sonwit/Bilderamme/plates/fugler/loxia-curvirostra.png

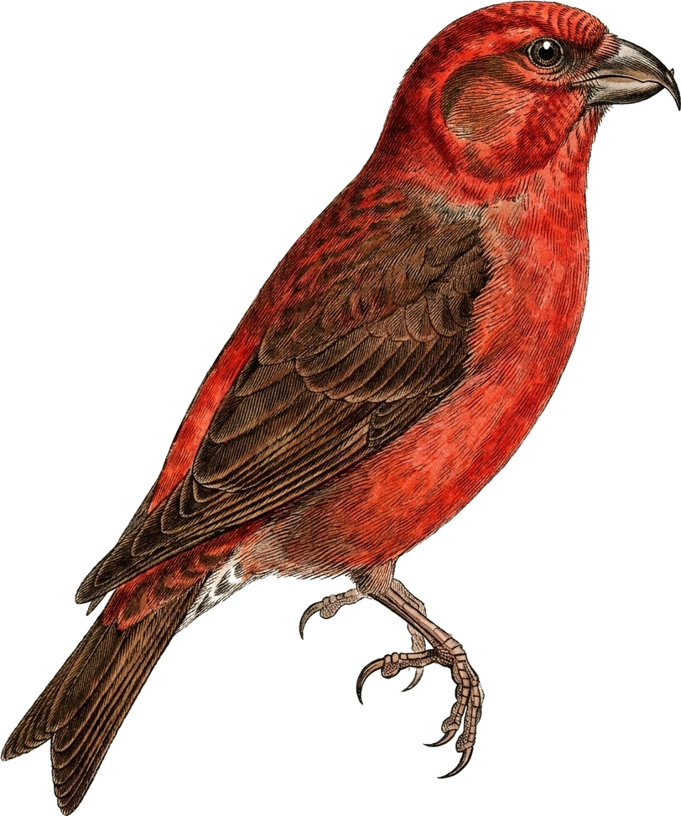
plates/fugler/loxia-curvirostra.png
