sonwit/Bilderamme/plates/fugler/phoenicurus-phoenicurus-flyvende.png

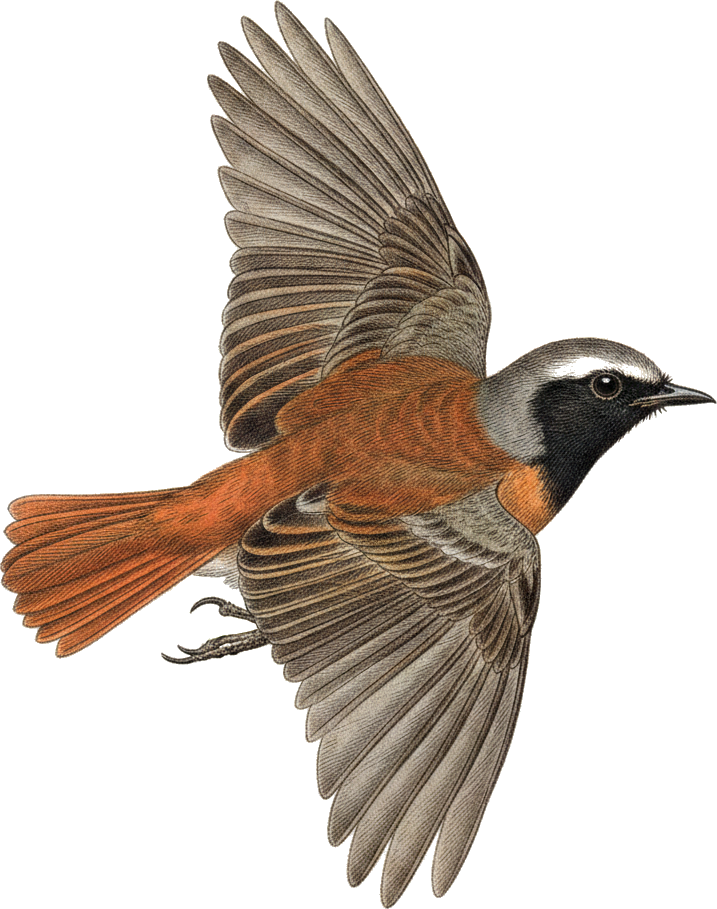
plates/fugler/phoenicurus-phoenicurus-flyvende.png
