sonwit/Bilderamme/docs/README.md

# docs/ — guider og notater

Guidene beskriver hvordan ting settes opp. Notatene er skrevet underveis og
beskriver det som var sant da; de er beholdt som historikk.

| Fil | Hva | Status |
|---|---|---|
| `Fase 1 — Kom i gang med ePaper-skjermen.md` | Første kontakt med panelet: board-innstillinger, testbilde, to nettverk under samme navn. | Guide |
| `Egen firmware — oppsett.md` | Hvordan innedelens firmware ble til, med den fungerende driveren. | Guide |
| `Flashing med arduino-cli.md` | Førstegangsoppsett av arduino-cli og feilsøking av flashing. | Guide |
| `Utedel v2 — ESP32-S3 XIAO.md` | Alt om lytteren: montering, strøm, fjernkonfig, feilsøking. | Guide |
| `Webapp — galleri og generering.md` | Webappen på port 8090: galleri, send på nytt, generering. | Guide |
| `Dagsoversikten — én dag om gangen.md` | `/dag`: hva siden viser og hvorfor den finnes. | Guide |
| `On-demand — Siri-kommando.md` | «Hei Siri, tegn X på fuglerammen»: snarveien og endepunktet. | Guide |
| `Prompt-guide — bilder til ePaper-rammen.md` | Prompt-maler som gir gode resultater på seks farger. | Guide |
| `Utedel — status og neste steg.md` | Utedel v1 på Raspberry Pi: hva som virket, hva som ikke gjorde det. | Historikk |
| `HANDOFF — bygg BirdNET-automatikk.md` | Overleveringen da BirdNET-automatikken skulle bygges, sommeren 2026. | Historikk |
| `Fugleramme — Ambient Art Display.md` | Det opprinnelige konseptet, før fuglesiden. | Historikk |

Hver mappe i repoet har sin egen README om det som ligger der; start i
[../README.md](../README.md).
