sonwit/Bilderamme/nettside/bilder/boks-inni.jpg

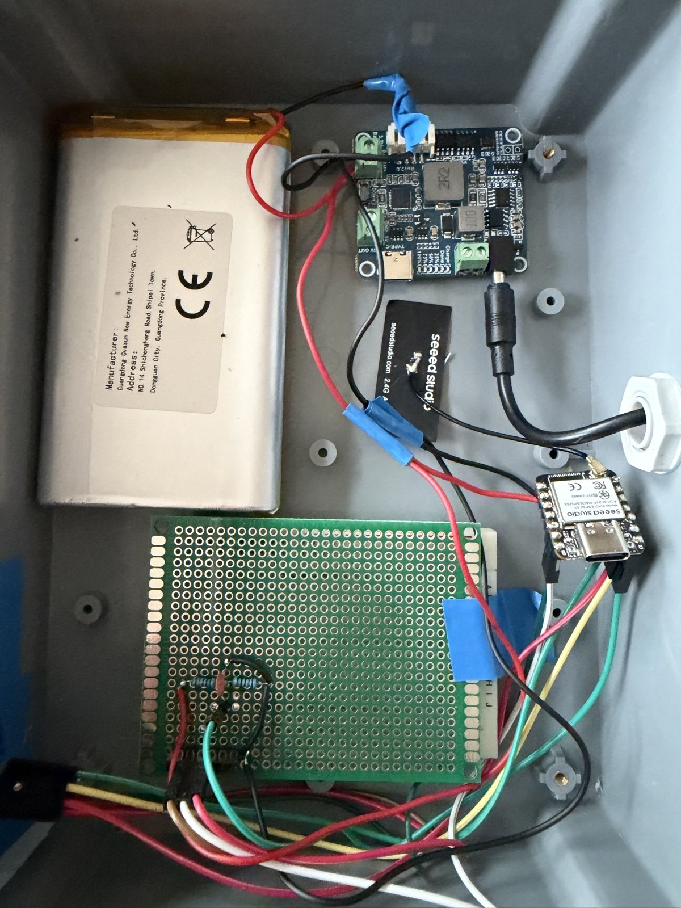
nettside/bilder/boks-inni.jpg
