sonwit/Bilderamme/nettside/bilder/boks-ute.jpg

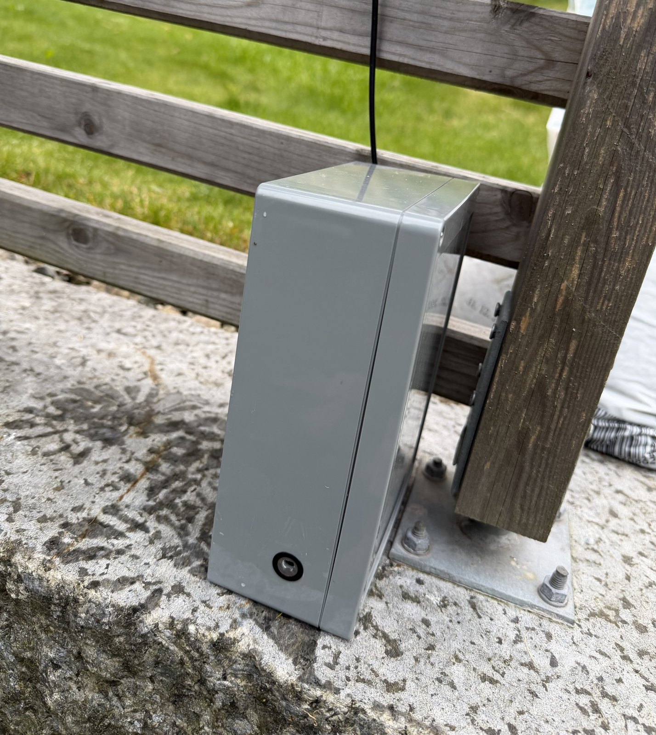
nettside/bilder/boks-ute.jpg
