sonwit/Bilderamme/nettside/bilder/ramme-naer.jpg

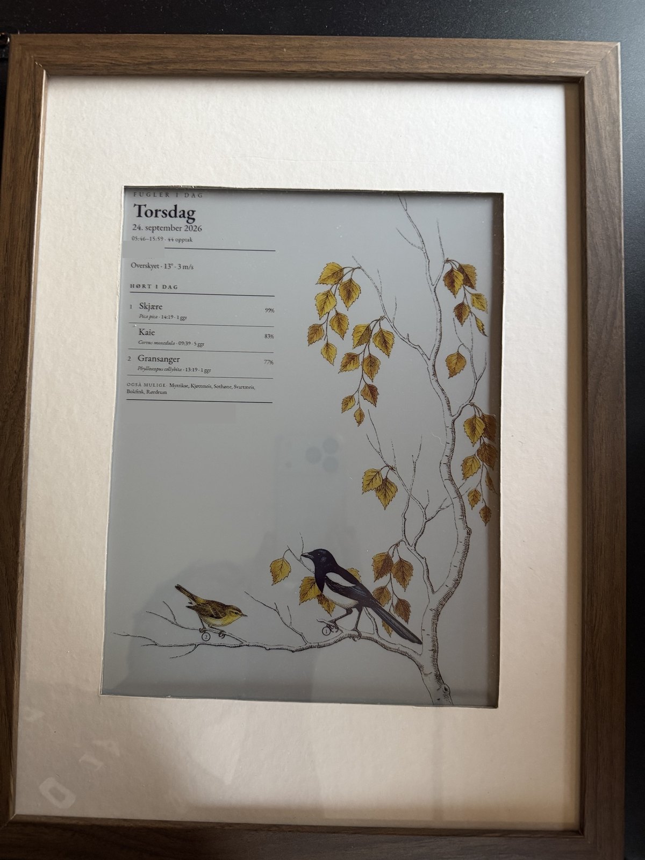
nettside/bilder/ramme-naer.jpg
