sonwit/Bilderamme/nettside/bilder/ramme.jpg

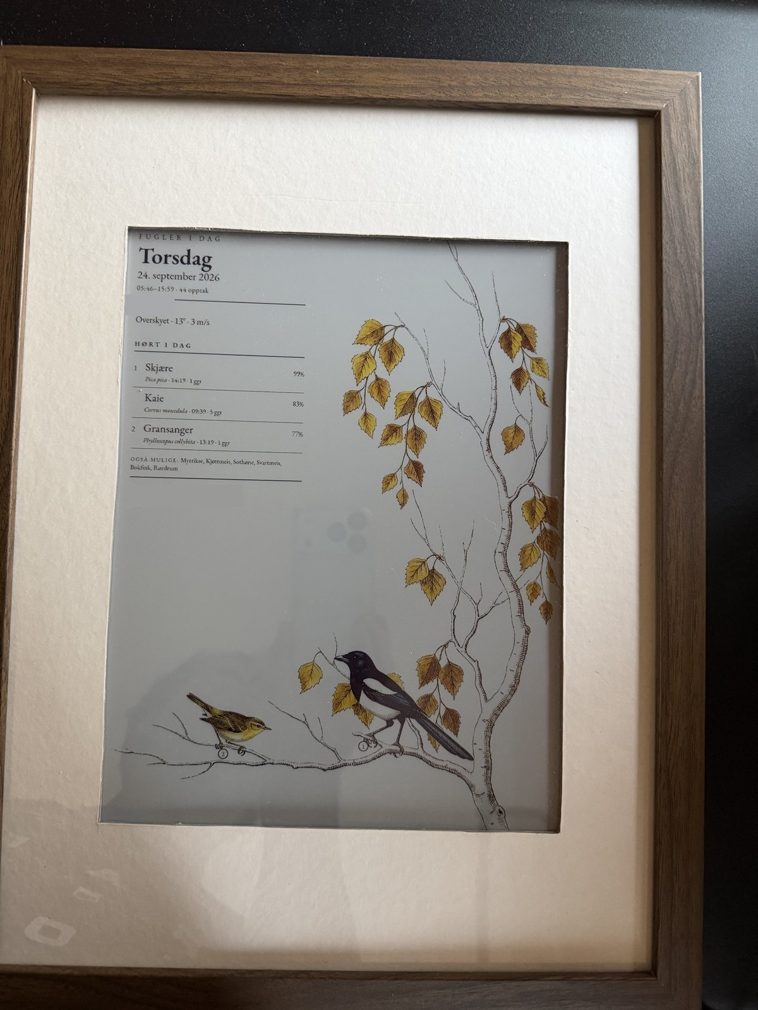
nettside/bilder/ramme.jpg
