sonwit/Bilderamme/nettside/dager/2026-09-18.png

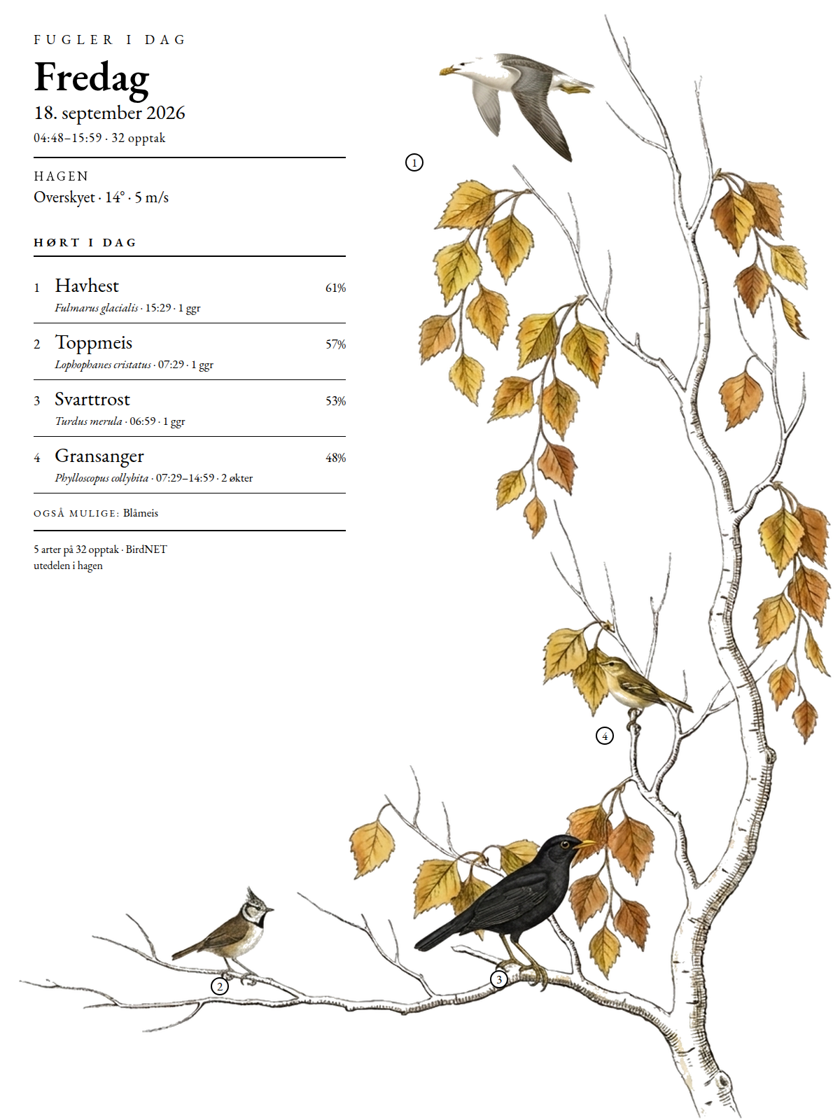
nettside/dager/2026-09-18.png
