sonwit/Bilderamme/nettside/dager/2026-09-19.png

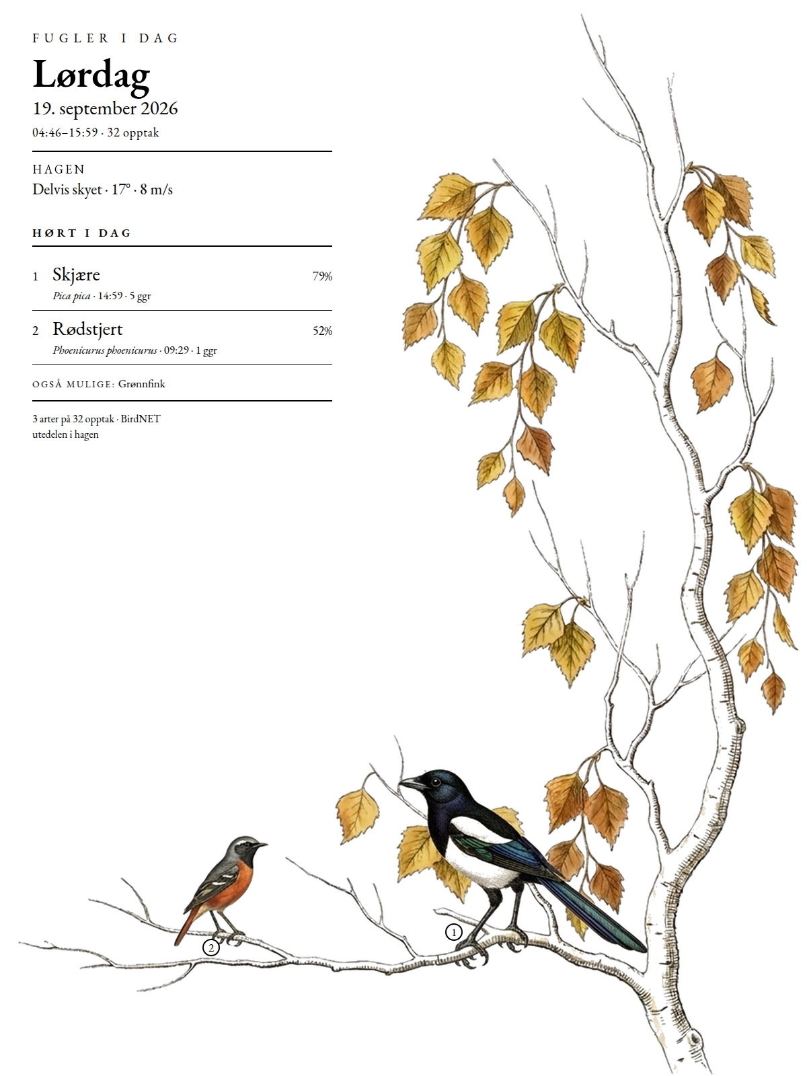
nettside/dager/2026-09-19.png
