sonwit/Bilderamme/nettside/dager/2026-09-20.png

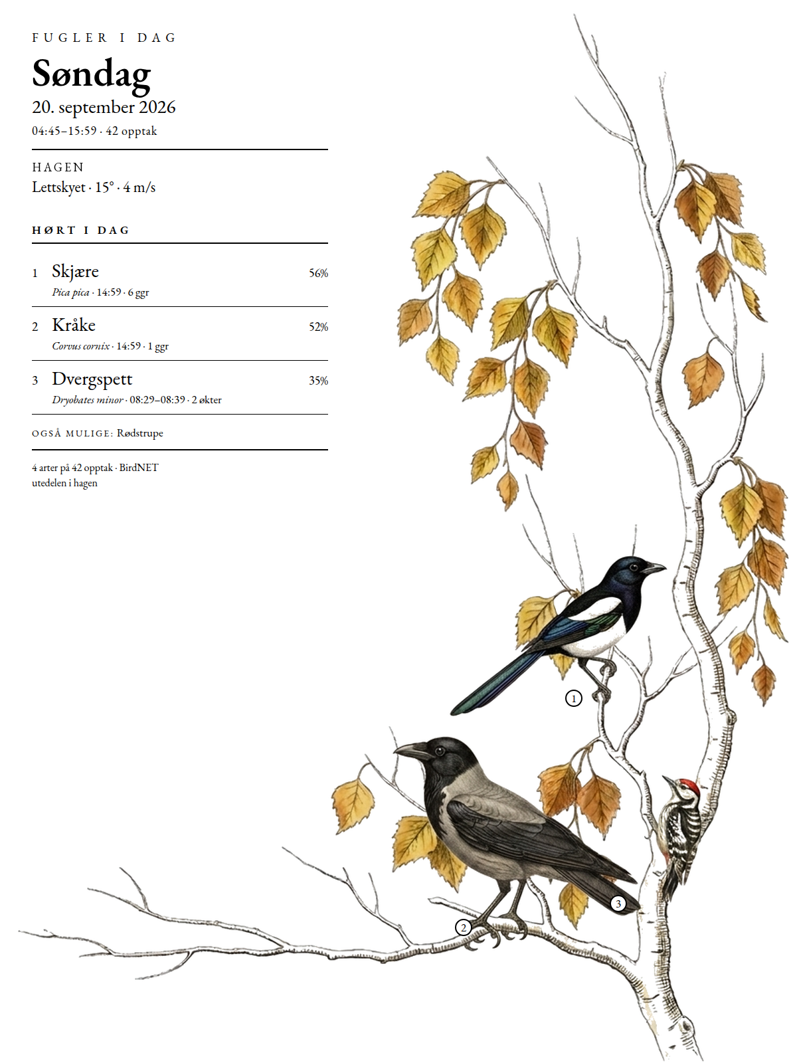
nettside/dager/2026-09-20.png
