sonwit/Bilderamme/nettside/dager/2026-09-21.png

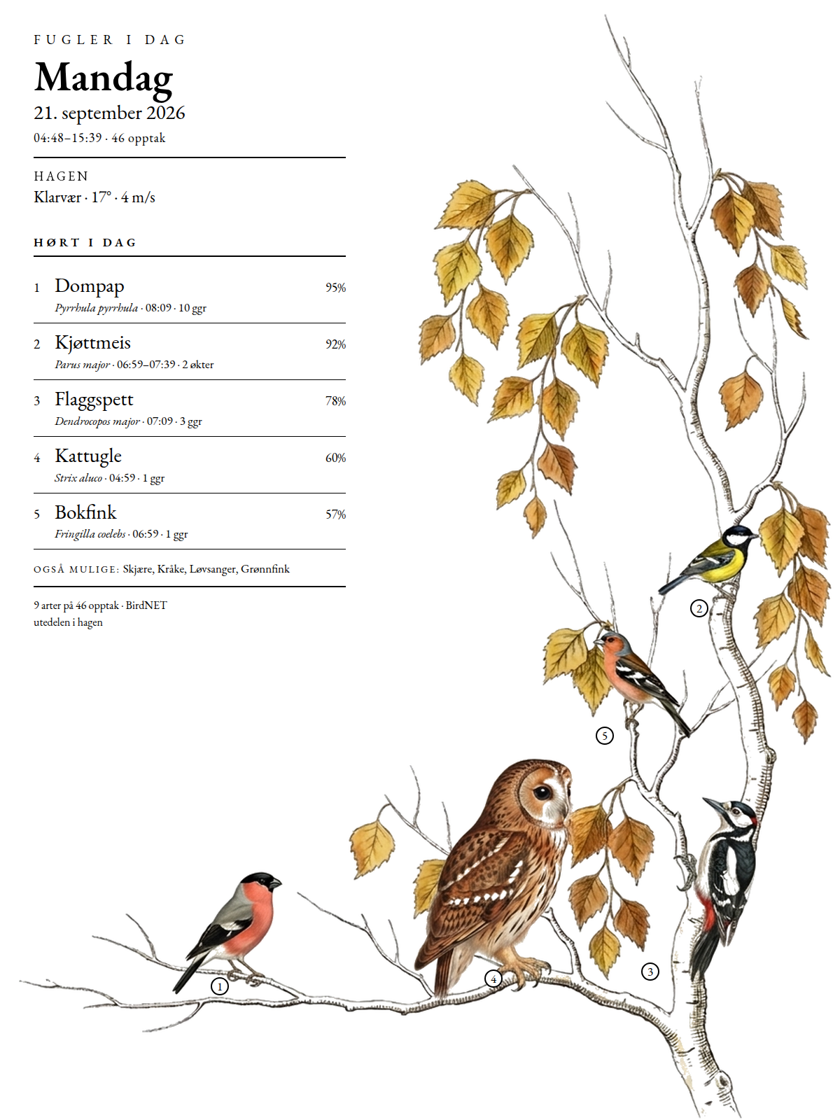
nettside/dager/2026-09-21.png
