sonwit/Bilderamme/nettside/dager/2026-09-22.png

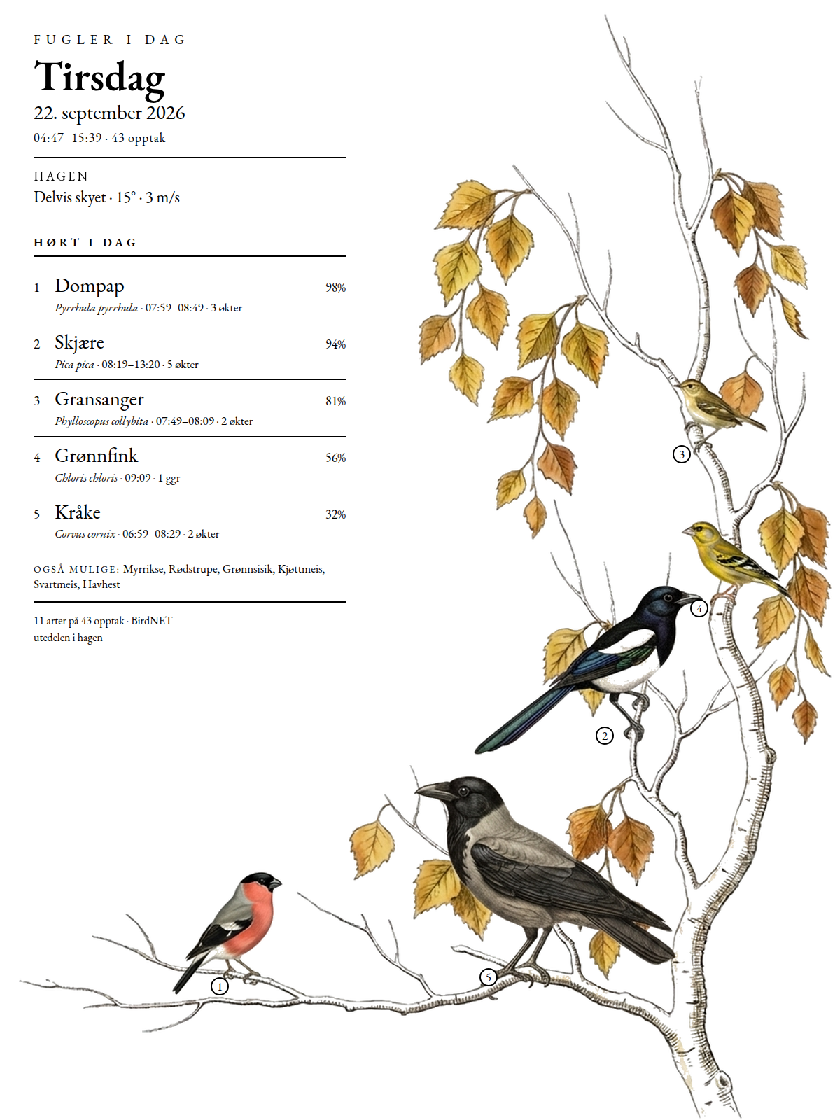
nettside/dager/2026-09-22.png
