sonwit/Bilderamme/nettside/dager/2026-09-23.png

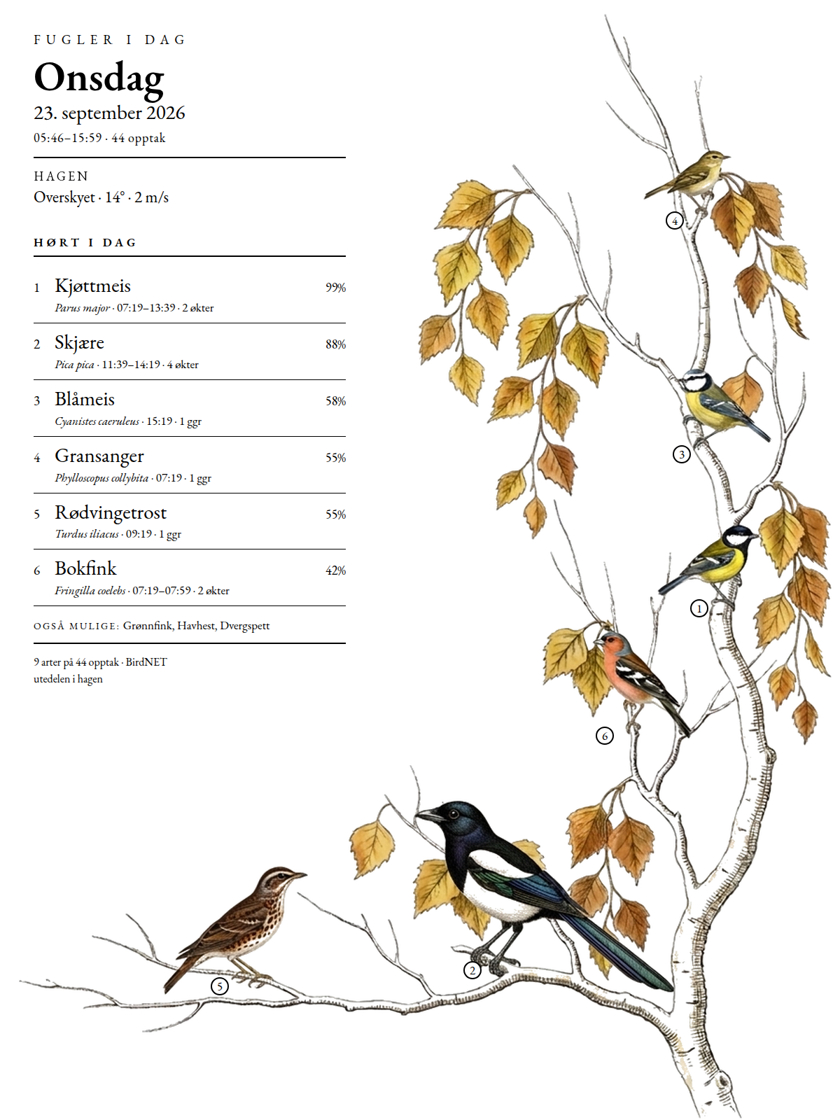
nettside/dager/2026-09-23.png
