sonwit/Bilderamme/nettside/dager/2026-09-24.png

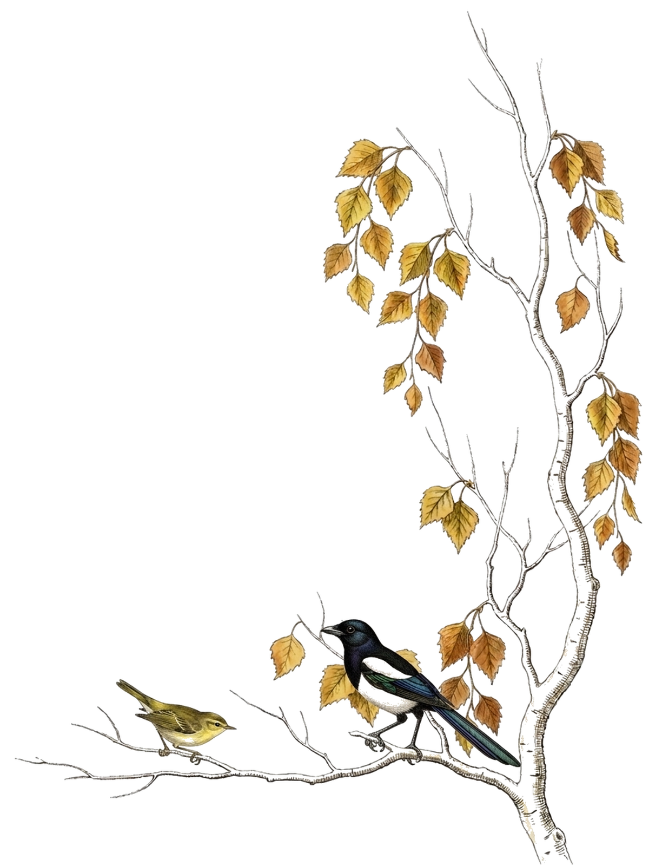
nettside/dager/2026-09-24.png
