sonwit/Bilderamme/nettside/dager/2026-09-26.png

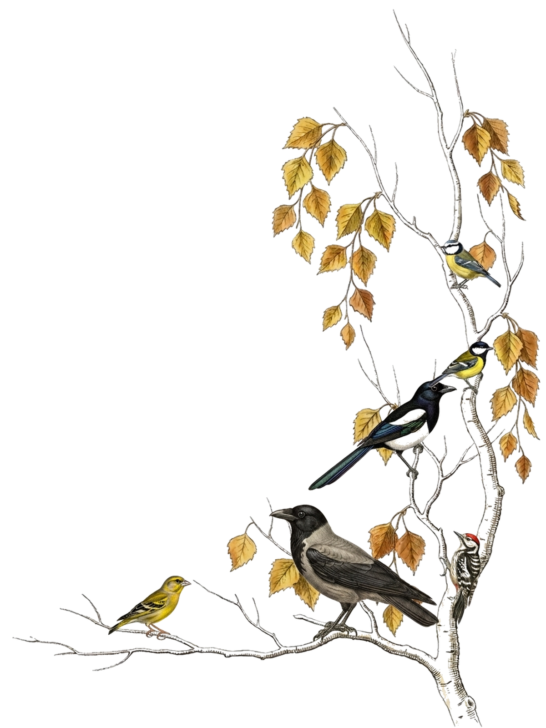
nettside/dager/2026-09-26.png
