sonwit/Bilderamme/nettside/dager/2026-09-29.png

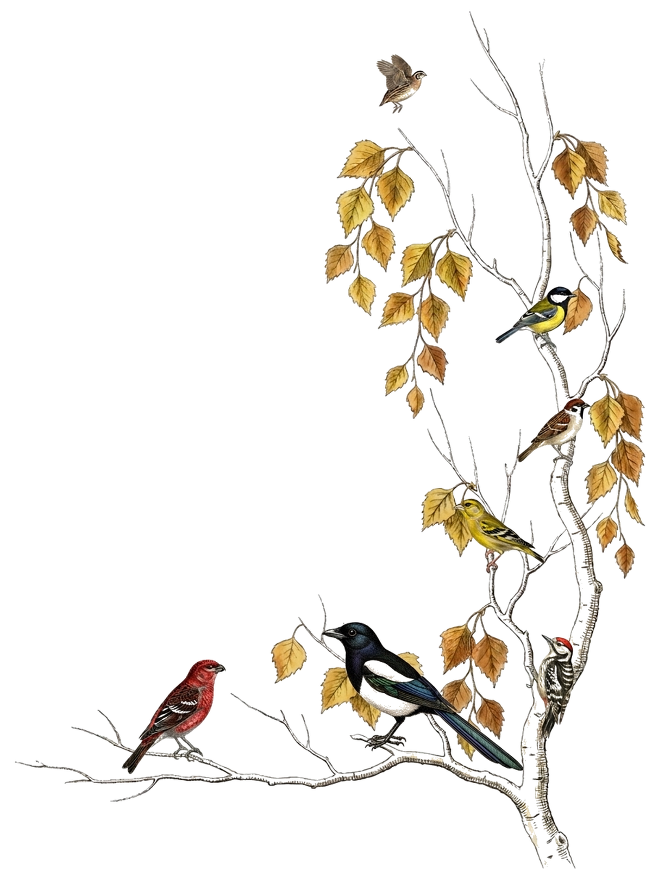
nettside/dager/2026-09-29.png
