sonwit/Bilderamme/nettside/dager/2026-10-04.png

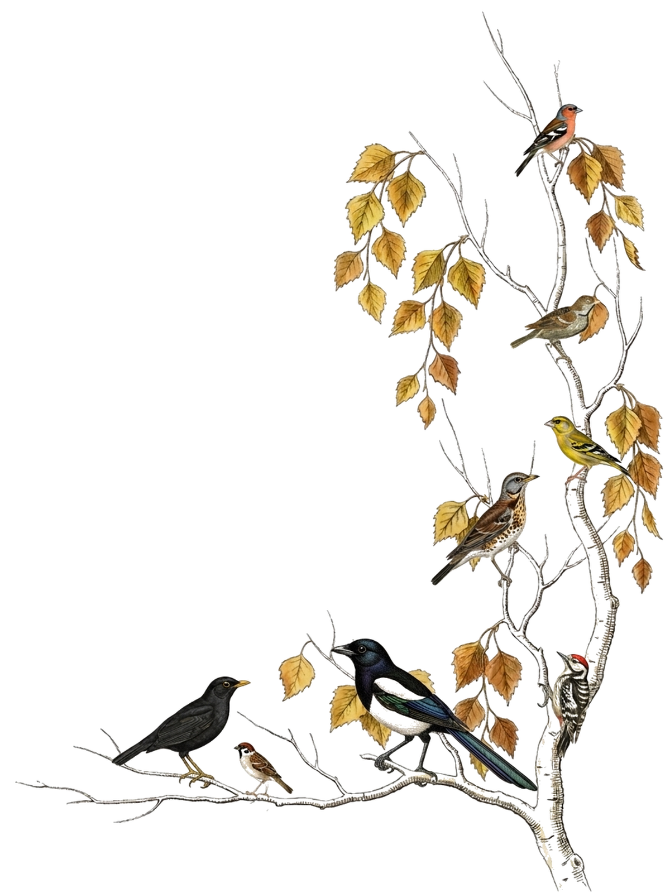
nettside/dager/2026-10-04.png
