sonwit/Bilderamme/nettside/dager/2026-10-10.png

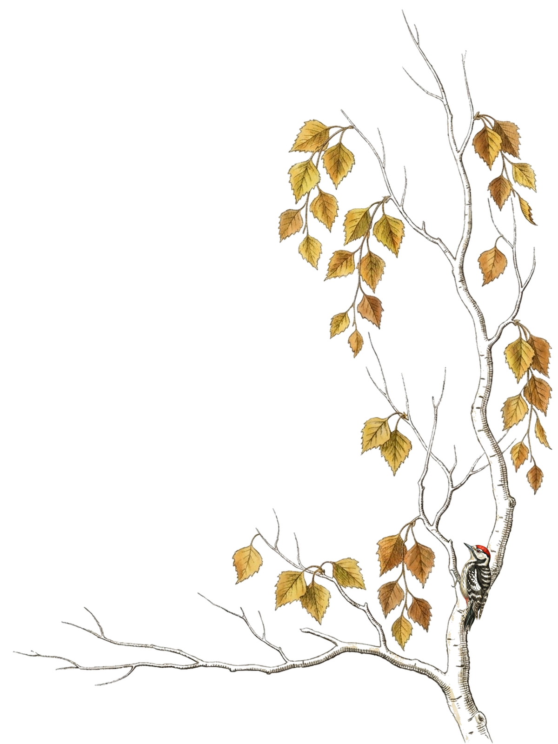
nettside/dager/2026-10-10.png
