sonwit/Bilderamme/nettside/dager/2026-10-22.png

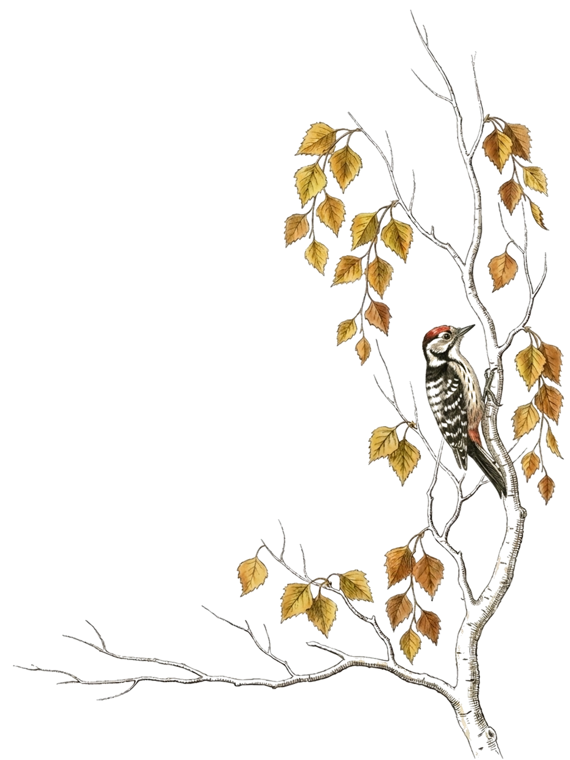
nettside/dager/2026-10-22.png
