sonwit/Bilderamme/nettside/dager/2026-11-07.png

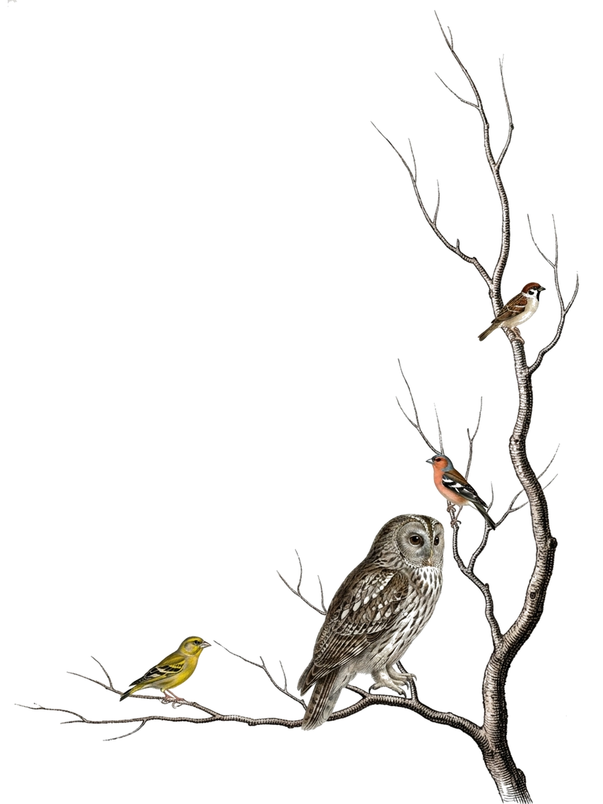
nettside/dager/2026-11-07.png
