sonwit/Bilderamme/nettside/dager/2026-11-08.png

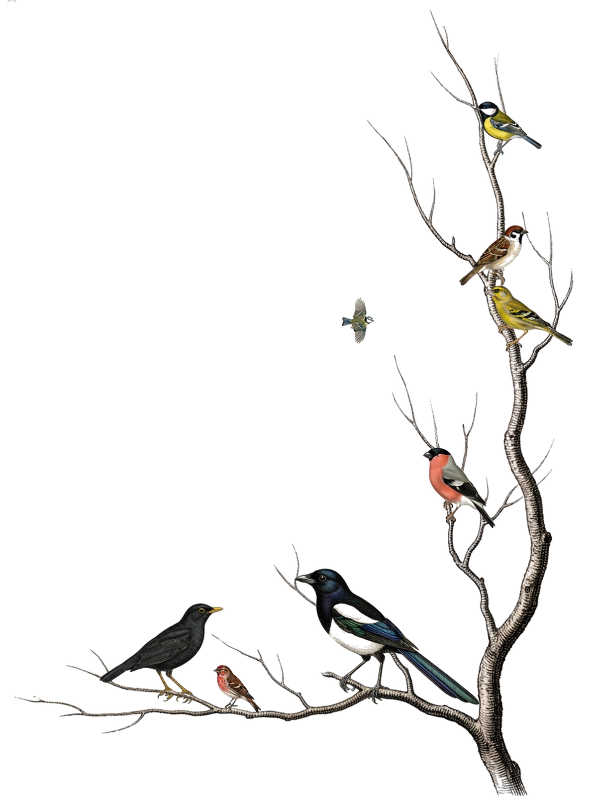
nettside/dager/2026-11-08.png
