sonwit/Bilderamme/nettside/dager/2026-11-09.png

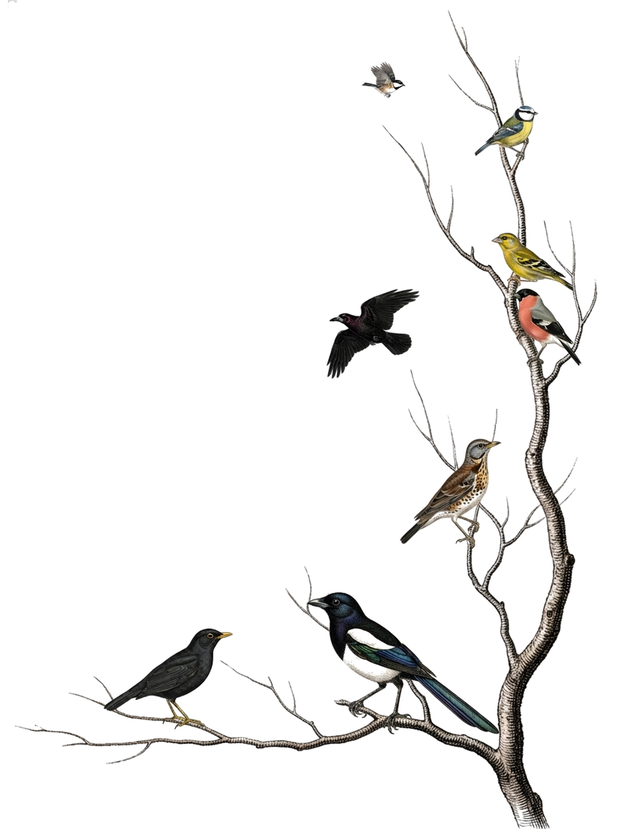
nettside/dager/2026-11-09.png
