sonwit/Bilderamme/nettside/dager/2026-11-10.png

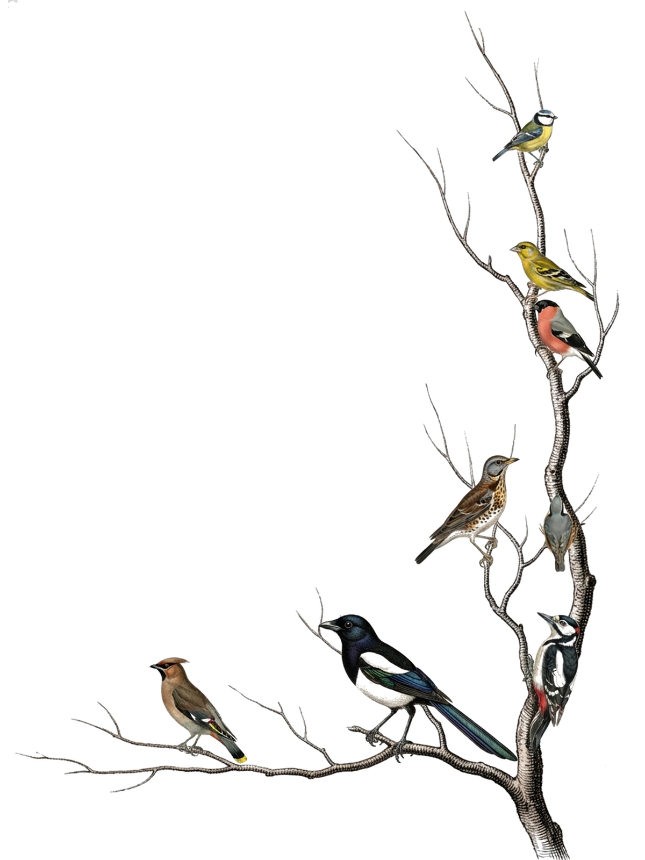
nettside/dager/2026-11-10.png
