sonwit/Bilderamme/nettside/dager/2026-11-13.png

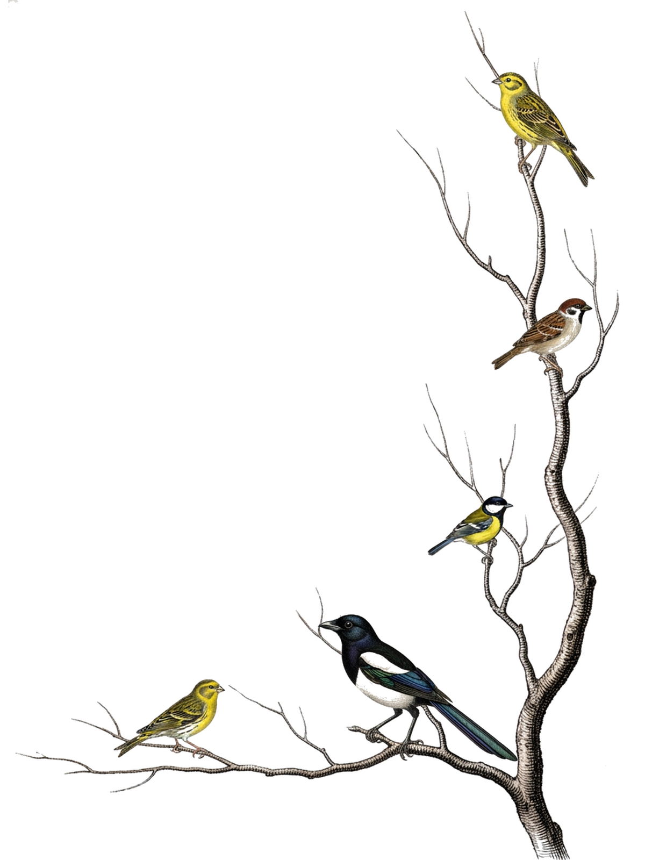
nettside/dager/2026-11-13.png
