sonwit/Bilderamme/plates/anser-anser.jpg

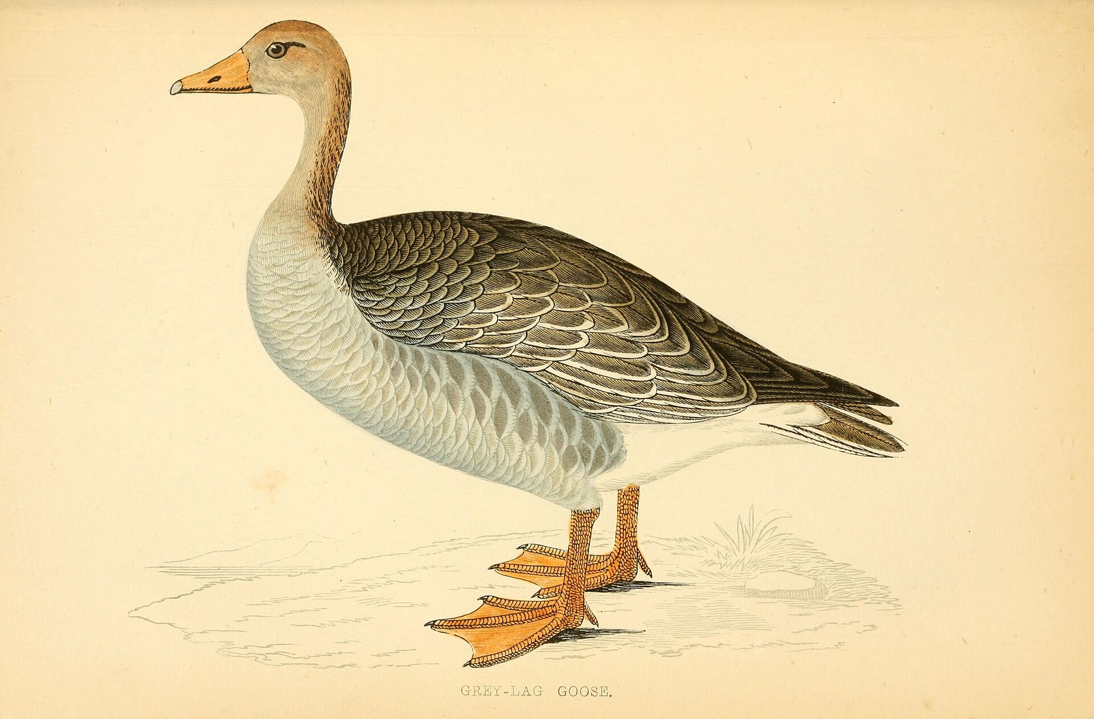
plates/anser-anser.jpg
