sonwit/Bilderamme/plates/ardea-cinerea.jpg

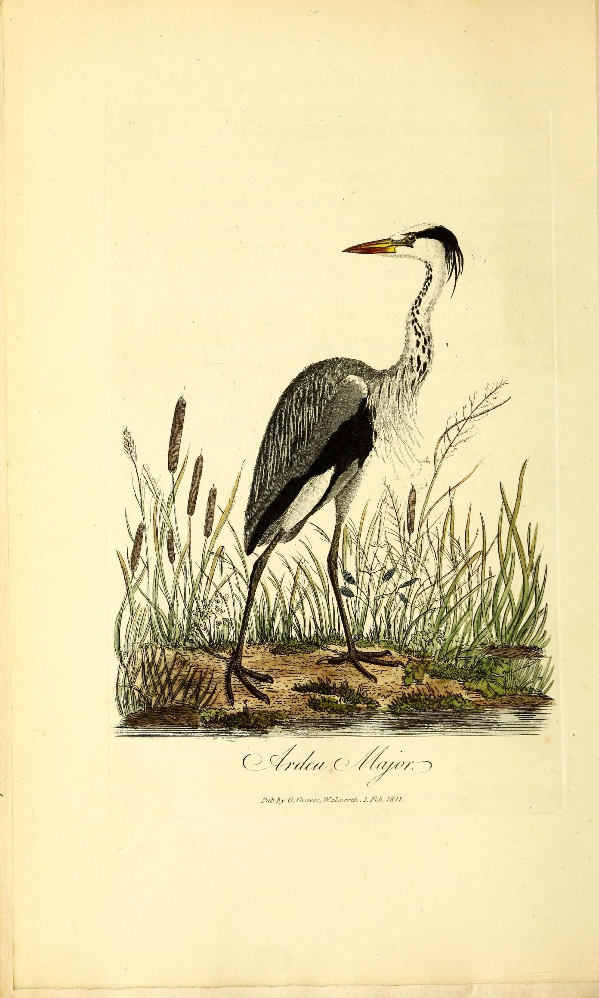
plates/ardea-cinerea.jpg
