sonwit/Bilderamme/plates/chloris-chloris.jpg

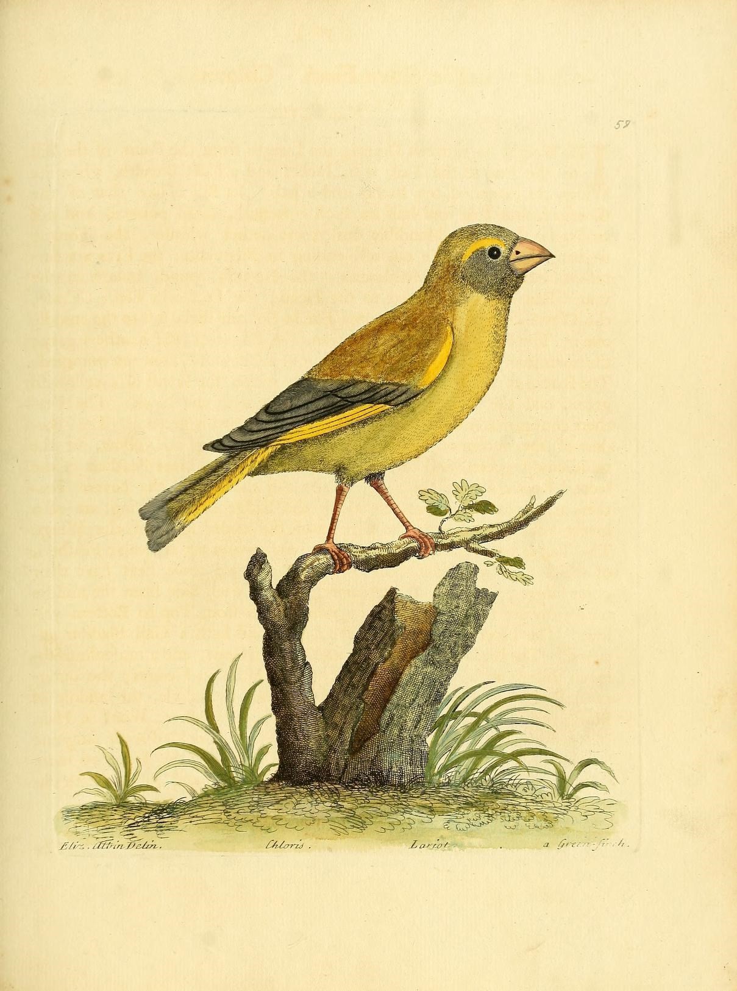
plates/chloris-chloris.jpg
