sonwit/Bilderamme/plates/corvus-cornix.jpg

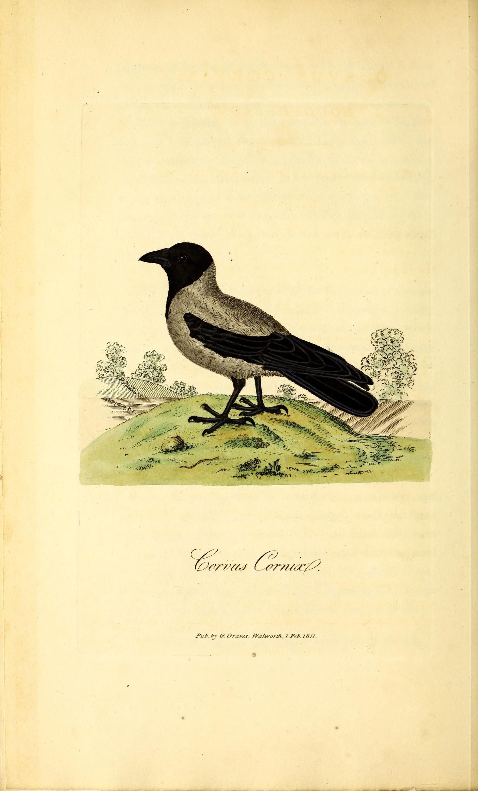
plates/corvus-cornix.jpg
