sonwit/Bilderamme/plates/coturnix-coturnix.jpg

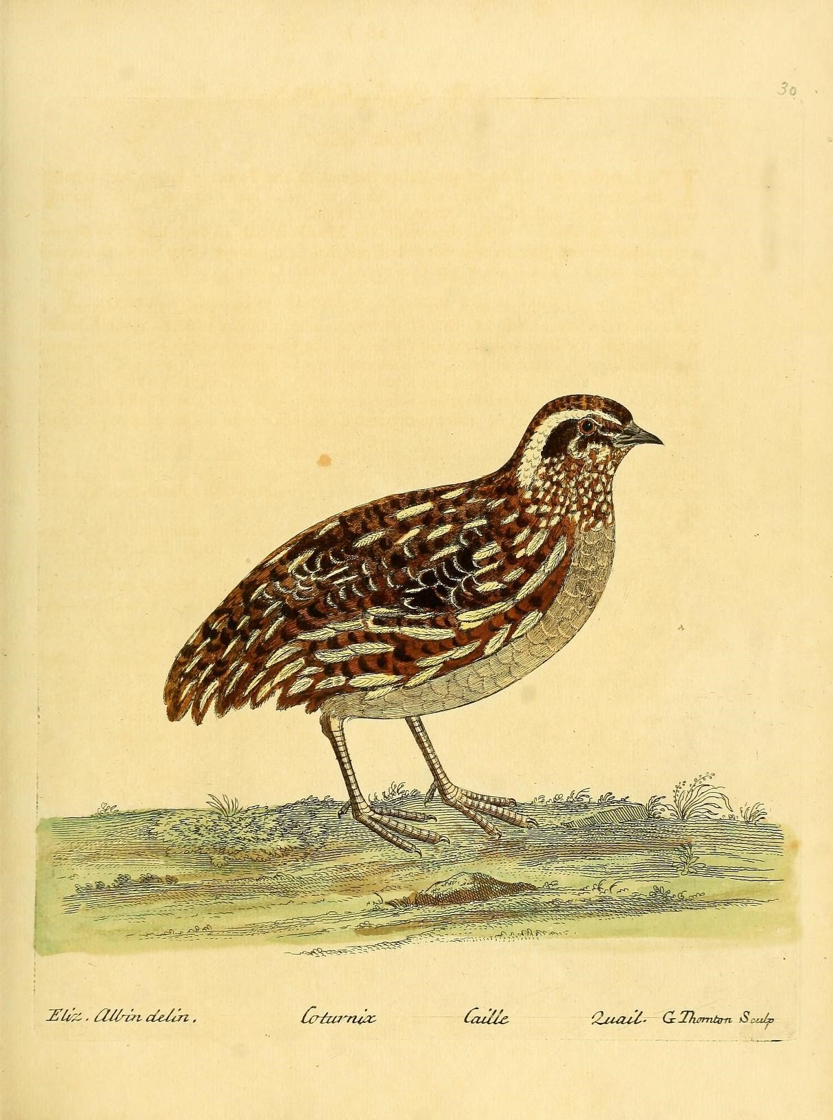
plates/coturnix-coturnix.jpg
