sonwit/Bilderamme/plates/cyanistes-caeruleus.jpg

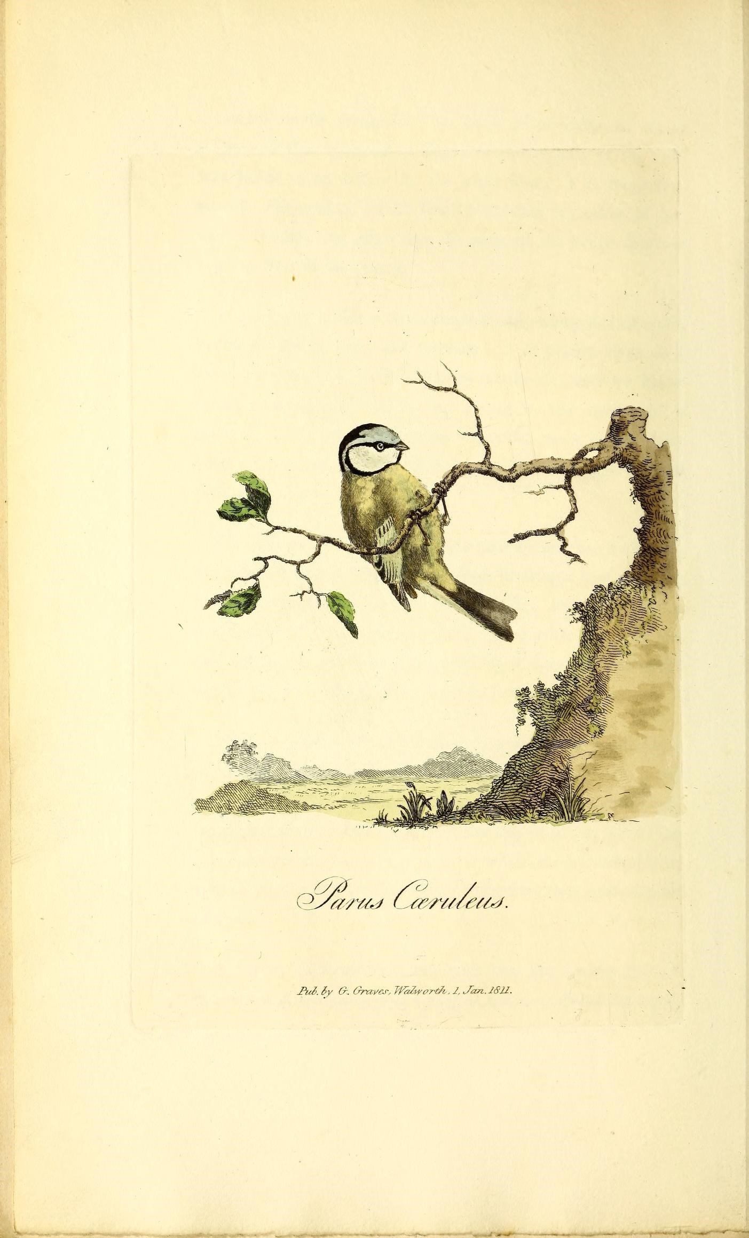
plates/cyanistes-caeruleus.jpg
