sonwit/Bilderamme/plates/dendrocopos-major.jpg

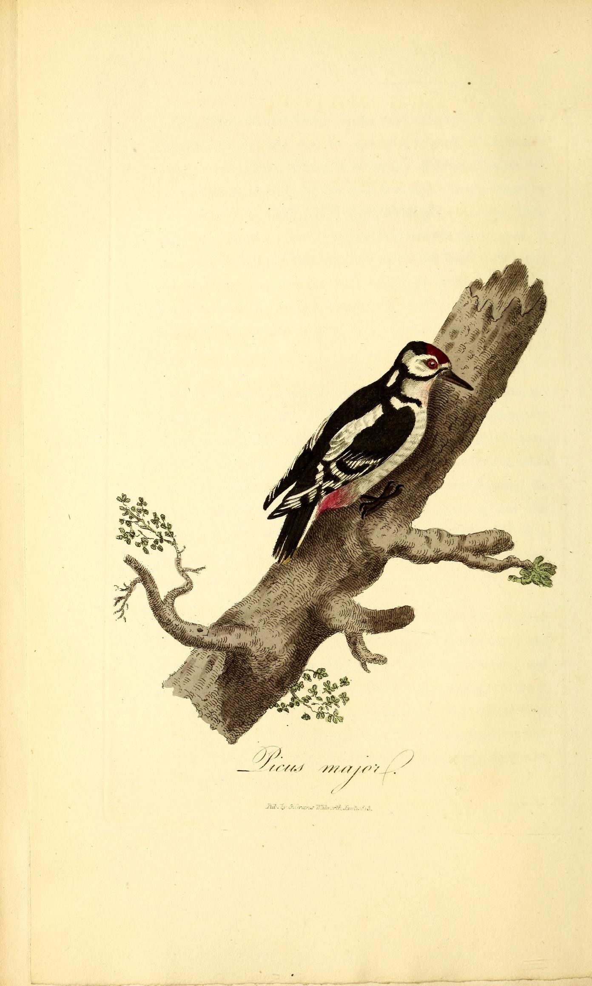
plates/dendrocopos-major.jpg
