sonwit/Bilderamme/plates/fringilla-coelebs.jpg

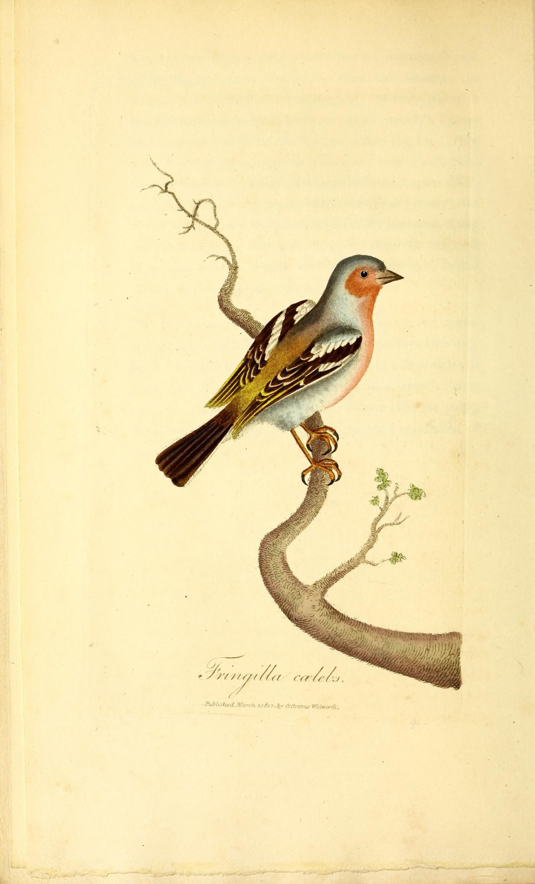
plates/fringilla-coelebs.jpg
