sonwit/Bilderamme/plates/fugler/anser-anser-flyvende.png

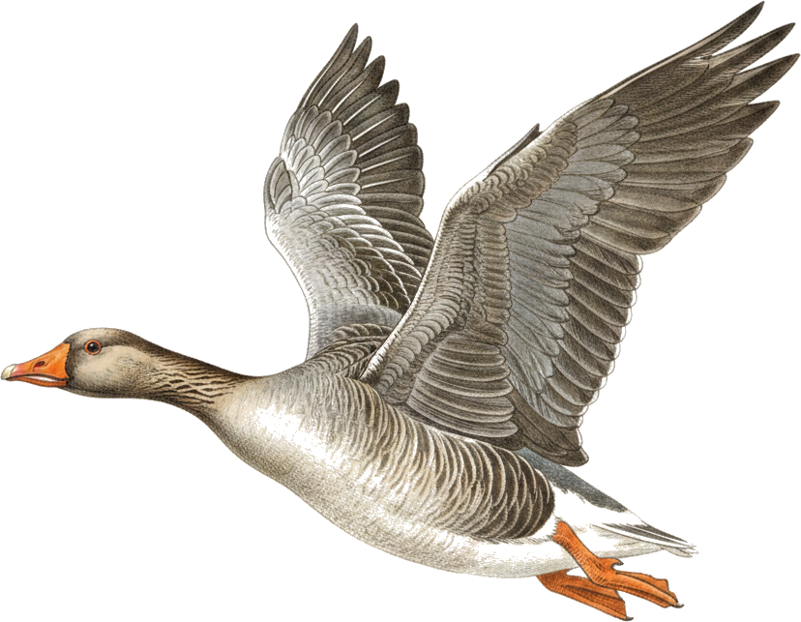
plates/fugler/anser-anser-flyvende.png
