sonwit/Bilderamme/plates/fugler/anser-anser.png

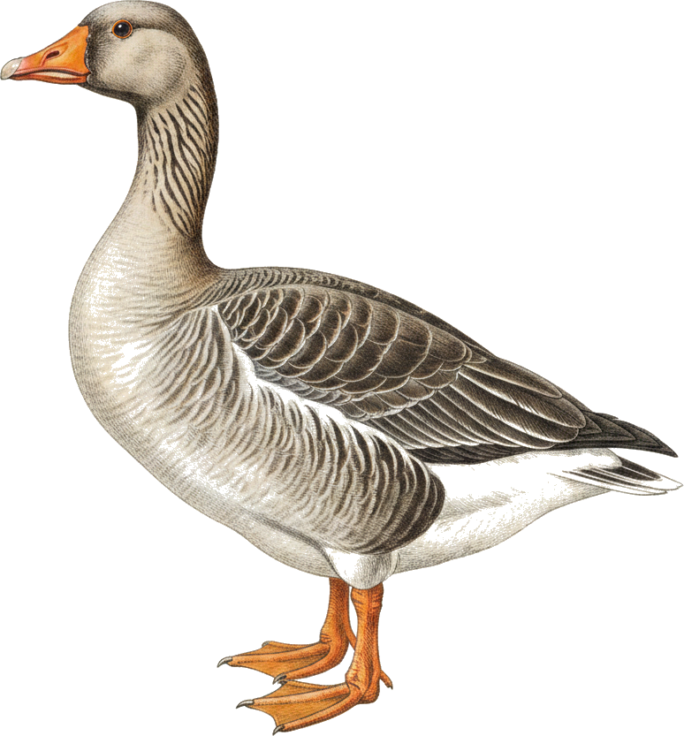
plates/fugler/anser-anser.png
