sonwit/Bilderamme/plates/fugler/ardea-cinerea-flyvende.png

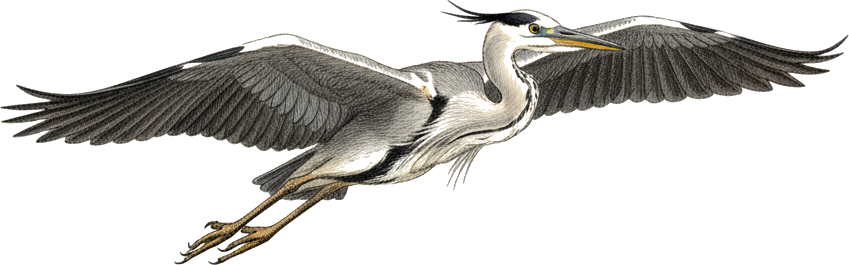
plates/fugler/ardea-cinerea-flyvende.png
