sonwit/Bilderamme/plates/fugler/ardea-cinerea.png

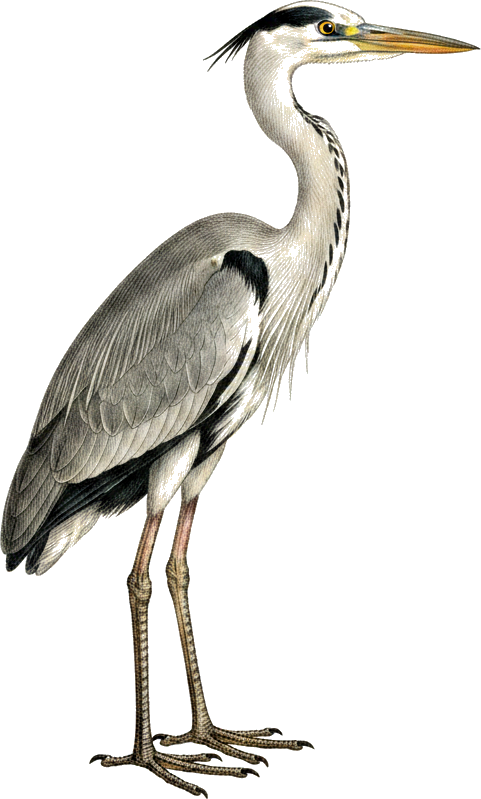
plates/fugler/ardea-cinerea.png
