sonwit/Bilderamme/plates/fugler/chloris-chloris-flyvende.png

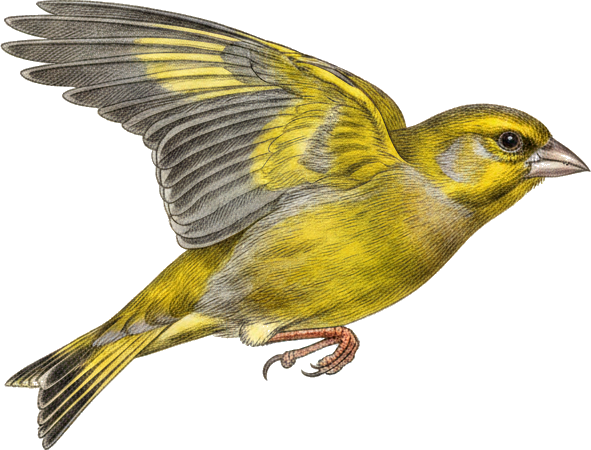
plates/fugler/chloris-chloris-flyvende.png
