sonwit/Bilderamme/plates/fugler/chloris-chloris.png

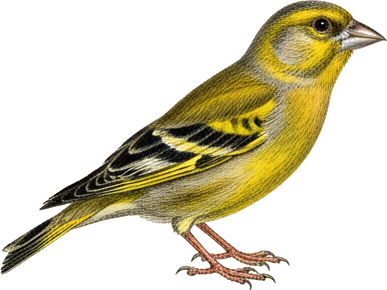
plates/fugler/chloris-chloris.png
