sonwit/Bilderamme/plates/fugler/corvus-cornix-flyvende.png

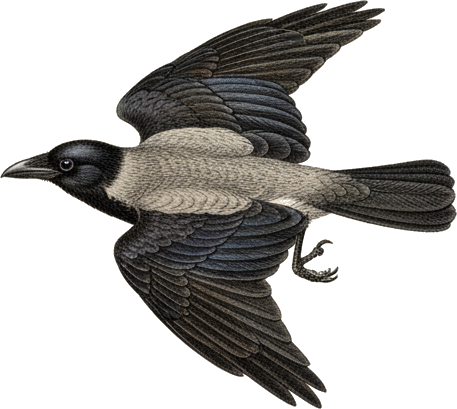
plates/fugler/corvus-cornix-flyvende.png
