sonwit/Bilderamme/plates/fugler/corvus-cornix.png

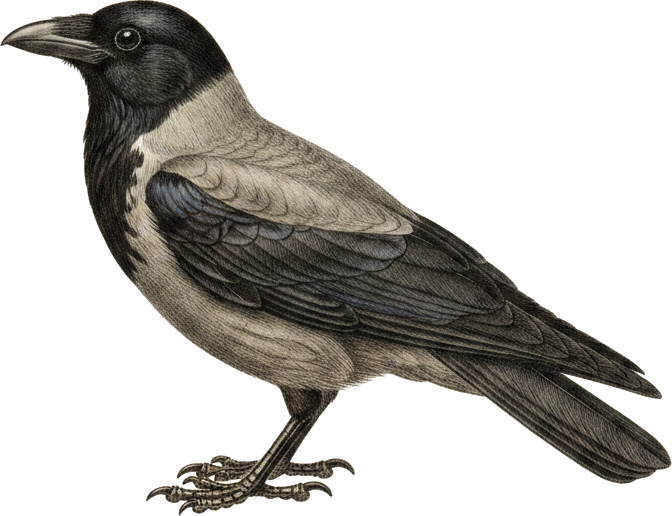
plates/fugler/corvus-cornix.png
