sonwit/Bilderamme/plates/fugler/coturnix-coturnix-flyvende.png

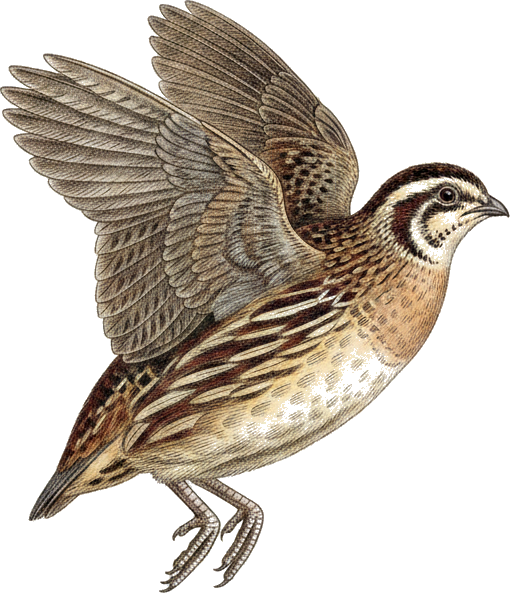
plates/fugler/coturnix-coturnix-flyvende.png
