sonwit/Bilderamme/plates/fugler/coturnix-coturnix.png

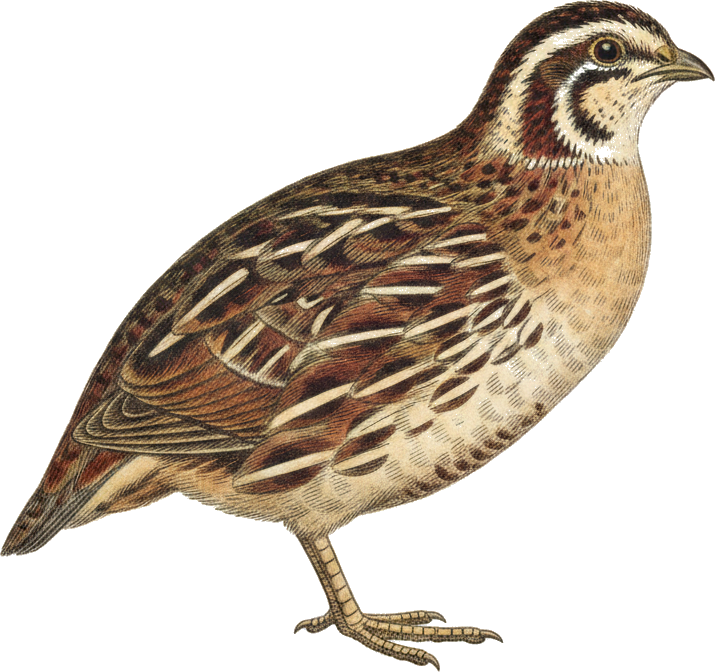
plates/fugler/coturnix-coturnix.png
