sonwit/Bilderamme/plates/fugler/cyanistes-caeruleus-flyvende.png

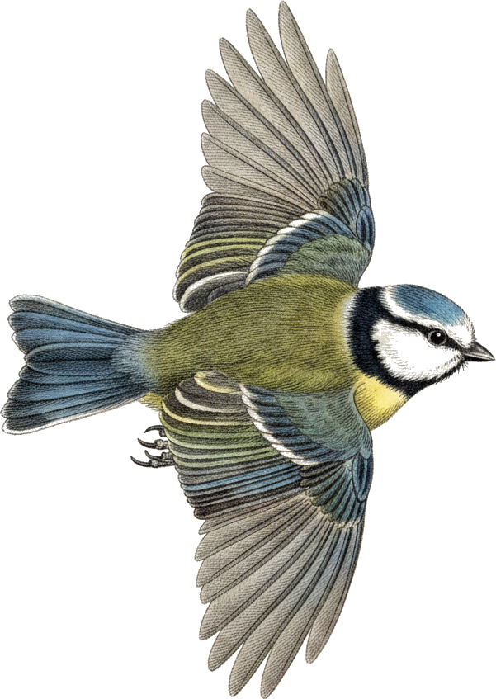
plates/fugler/cyanistes-caeruleus-flyvende.png
