sonwit/Bilderamme/plates/fugler/cyanistes-caeruleus.png

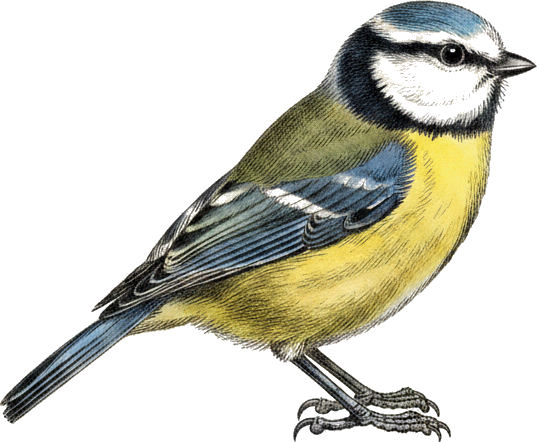
plates/fugler/cyanistes-caeruleus.png
