sonwit/Bilderamme/plates/fugler/dendrocopos-major-flyvende.png

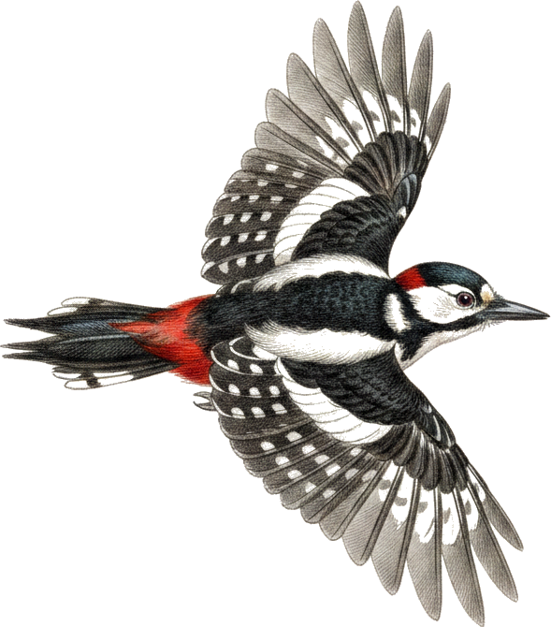
plates/fugler/dendrocopos-major-flyvende.png
