sonwit/Bilderamme/plates/fugler/dendrocopos-major-klatrende.png

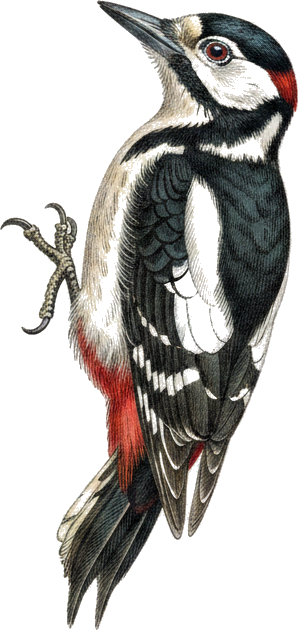
plates/fugler/dendrocopos-major-klatrende.png
