sonwit/Bilderamme/plates/fugler/dendrocopos-major.png

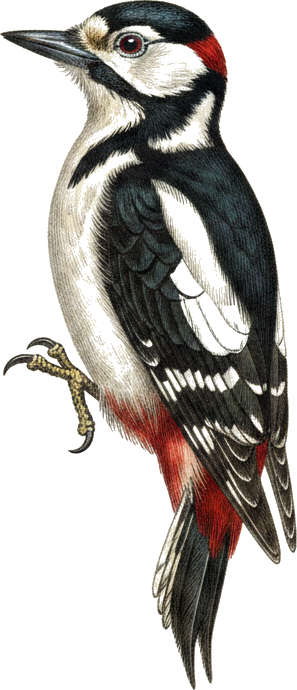
plates/fugler/dendrocopos-major.png
