sonwit/Bilderamme/plates/fugler/dryobates-minor-flyvende.png

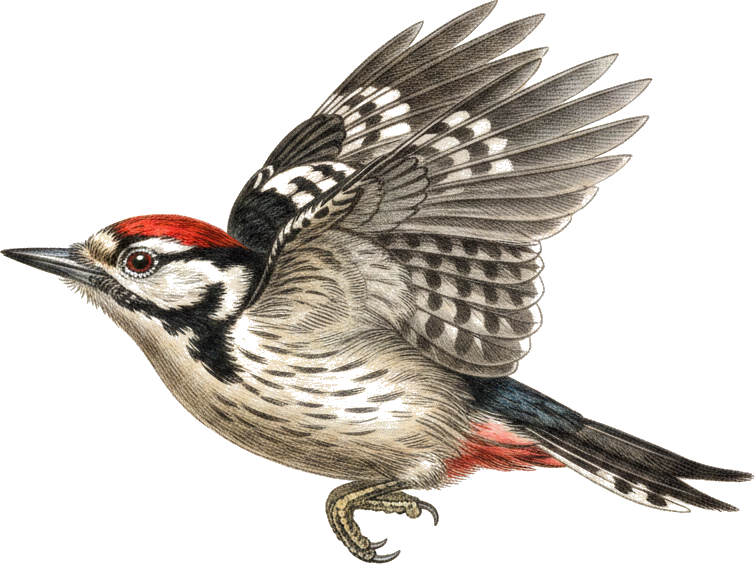
plates/fugler/dryobates-minor-flyvende.png
