sonwit/Bilderamme/plates/fugler/dryobates-minor-klatrende.png

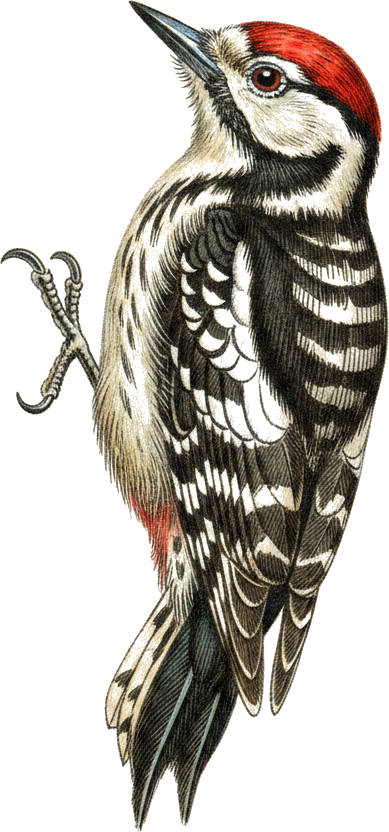
plates/fugler/dryobates-minor-klatrende.png
