sonwit/Bilderamme/plates/fugler/dryobates-minor.png

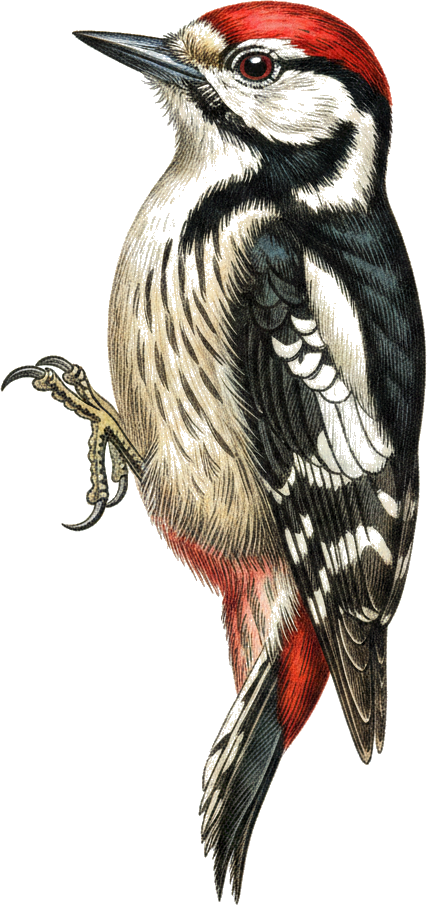
plates/fugler/dryobates-minor.png
