sonwit/Bilderamme/plates/fugler/fringilla-coelebs-flyvende.png

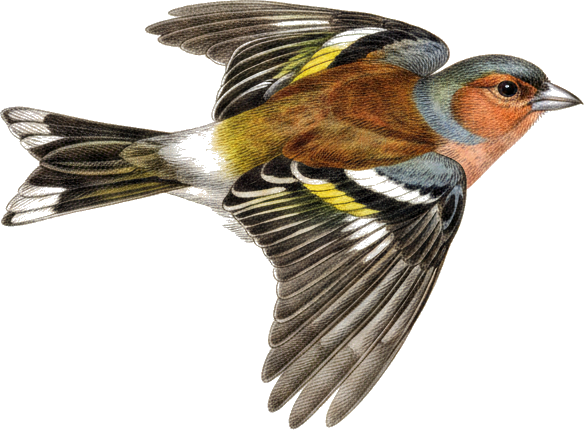
plates/fugler/fringilla-coelebs-flyvende.png
