sonwit/Bilderamme/plates/fugler/fringilla-coelebs.png

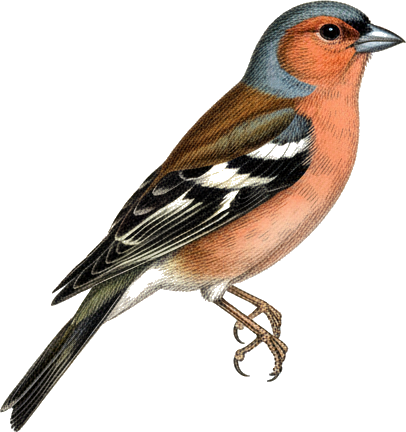
plates/fugler/fringilla-coelebs.png
