sonwit/Bilderamme/plates/fugler/fulmarus-glacialis-flyvende.png

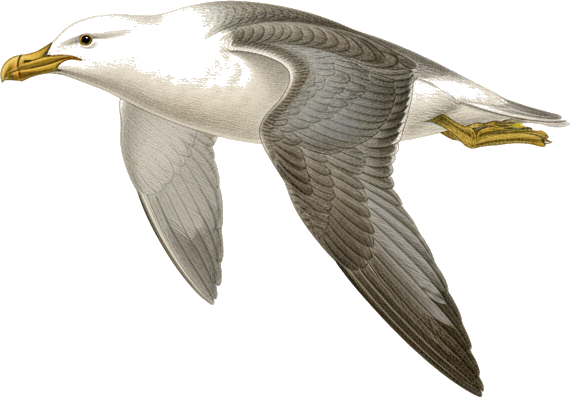
plates/fugler/fulmarus-glacialis-flyvende.png
