sonwit/Bilderamme/plates/fugler/fulmarus-glacialis.png

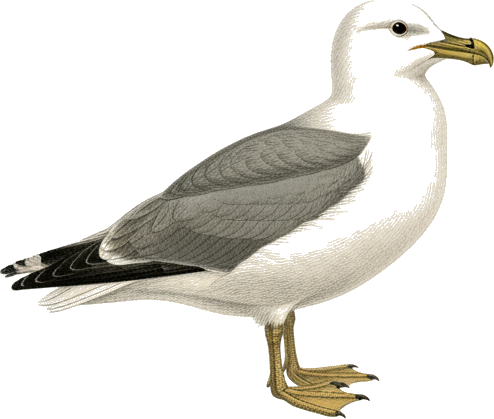
plates/fugler/fulmarus-glacialis.png
