sonwit/Bilderamme/plates/fugler/gallinago-gallinago-flyvende.png

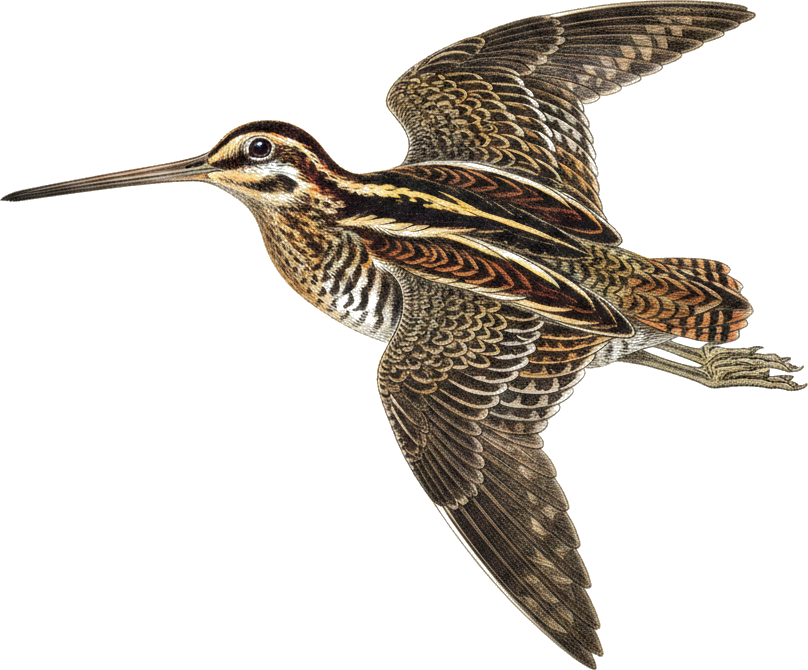
plates/fugler/gallinago-gallinago-flyvende.png
