sonwit/Bilderamme/plates/fugler/gallinago-gallinago.png

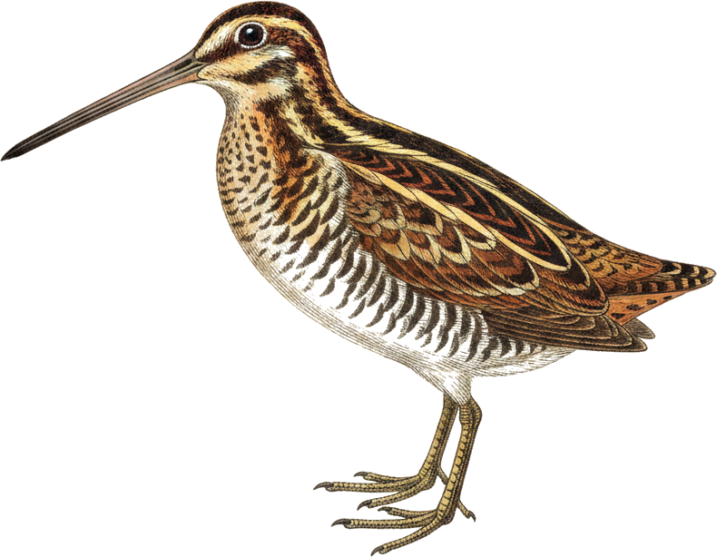
plates/fugler/gallinago-gallinago.png
