sonwit/Bilderamme/plates/fugler/mareca-strepera-flyvende.png

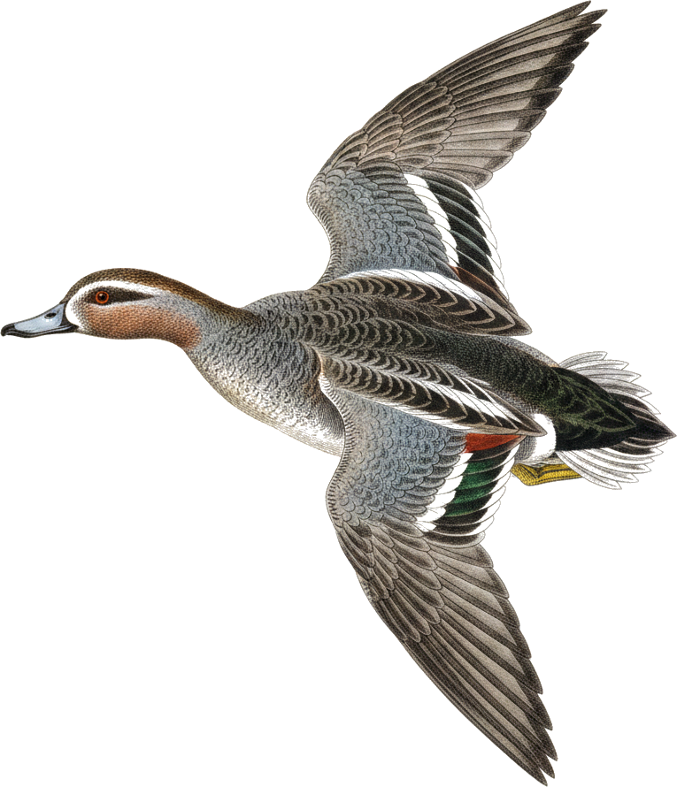
plates/fugler/mareca-strepera-flyvende.png
