sonwit/Bilderamme/plates/fugler/mareca-strepera.png

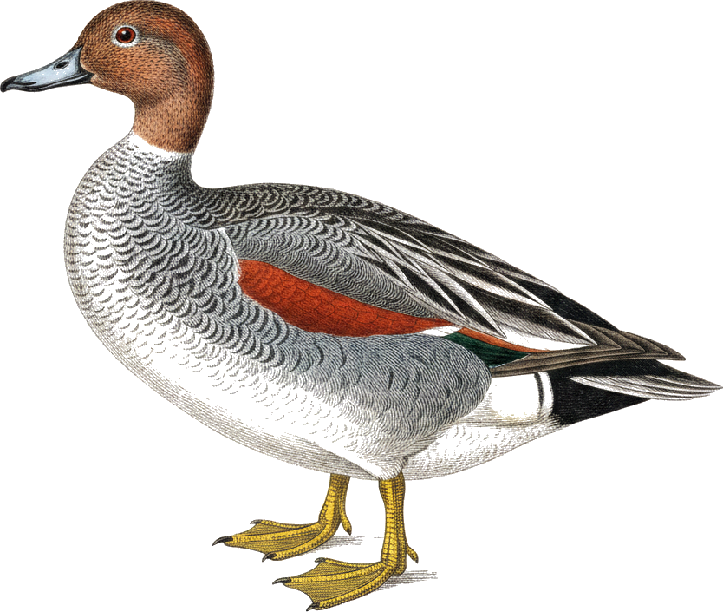
plates/fugler/mareca-strepera.png
