sonwit/Bilderamme/plates/fugler/parus-major-flyvende.png

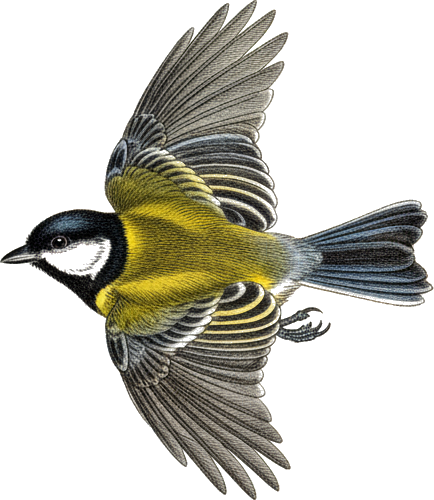
plates/fugler/parus-major-flyvende.png
