sonwit/Bilderamme/plates/fugler/parus-major.png

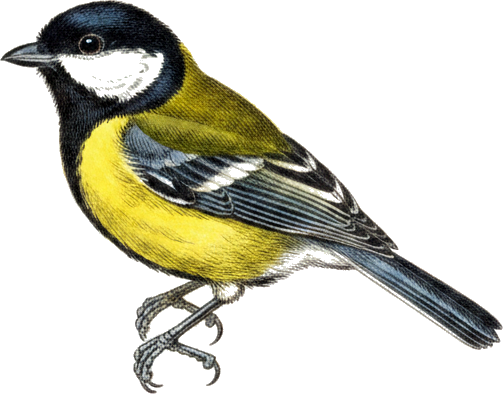
plates/fugler/parus-major.png
