sonwit/Bilderamme/plates/fugler/periparus-ater-flyvende.png

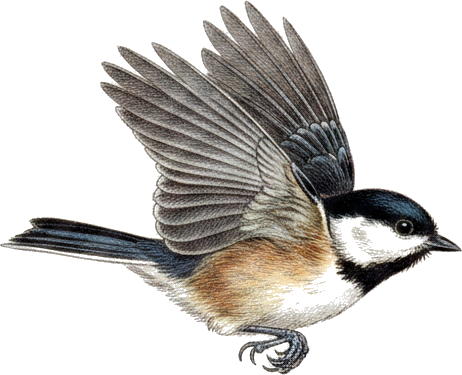
plates/fugler/periparus-ater-flyvende.png
