sonwit/Bilderamme/plates/fugler/periparus-ater.png

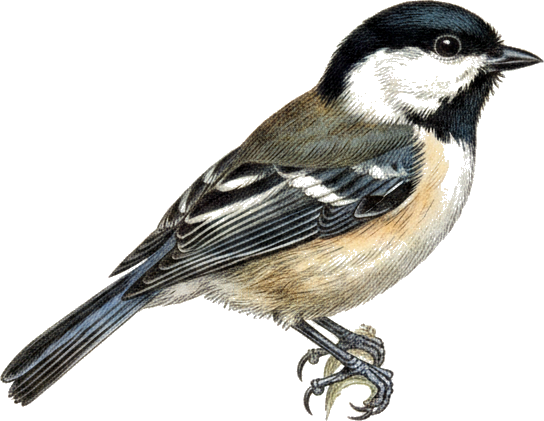
plates/fugler/periparus-ater.png
