sonwit/Bilderamme/plates/fugler/phoenicurus-phoenicurus.png

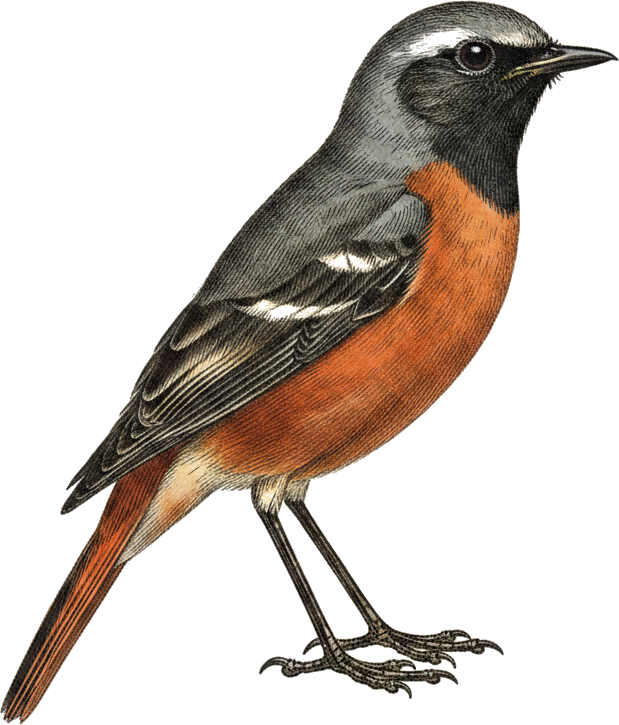
plates/fugler/phoenicurus-phoenicurus.png
