sonwit/Bilderamme/plates/fugler/phylloscopus-collybita-flyvende.png

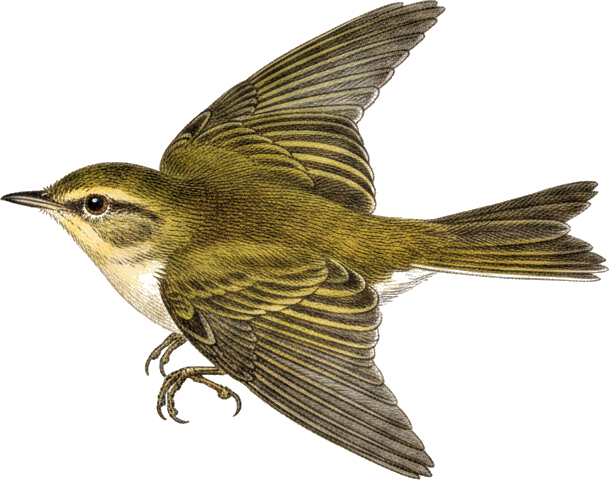
plates/fugler/phylloscopus-collybita-flyvende.png
