sonwit/Bilderamme/plates/fugler/phylloscopus-collybita.png

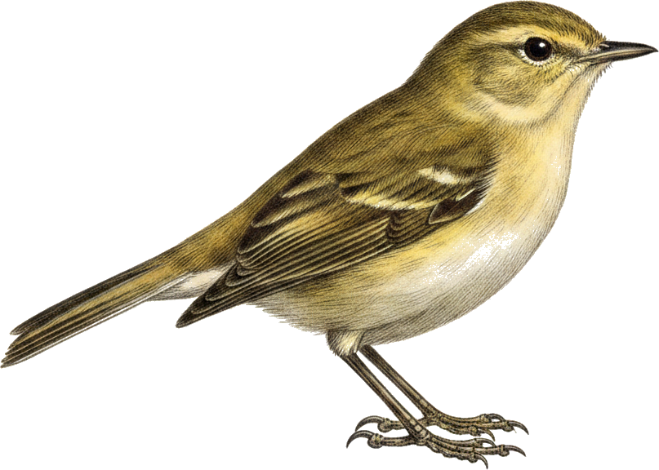
plates/fugler/phylloscopus-collybita.png
