sonwit/Bilderamme/plates/fugler/pica-pica-flyvende.png

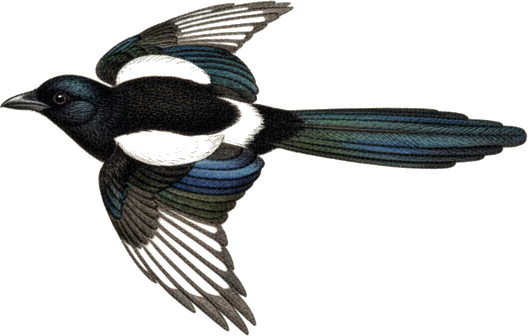
plates/fugler/pica-pica-flyvende.png
