sonwit/Bilderamme/plates/fugler/pica-pica.png

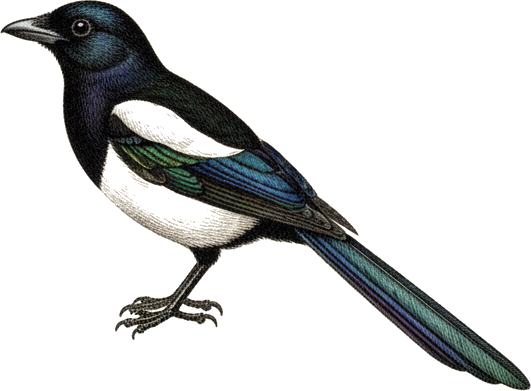
plates/fugler/pica-pica.png
