sonwit/Bilderamme/plates/fugler/porzana-porzana-flyvende.png

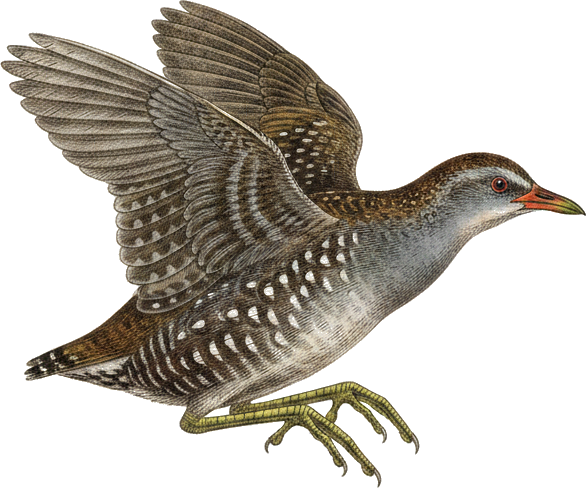
plates/fugler/porzana-porzana-flyvende.png
