sonwit/Bilderamme/plates/fugler/porzana-porzana.png

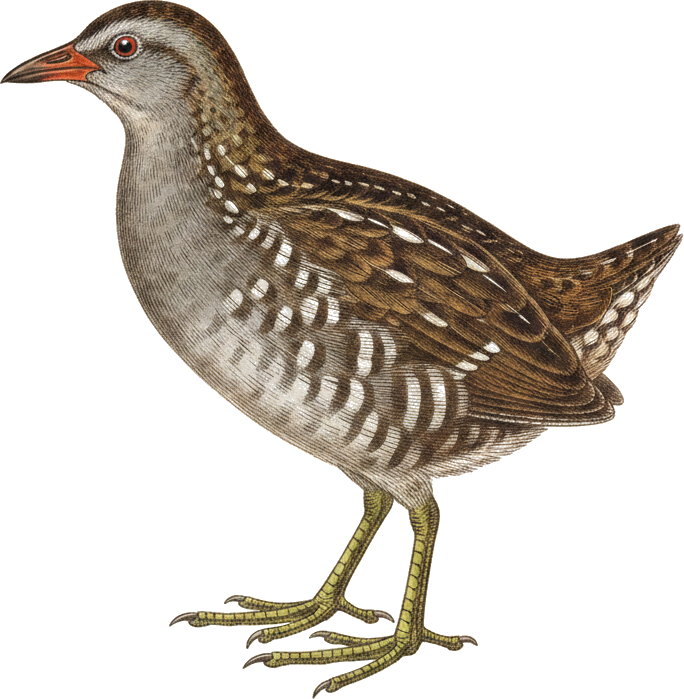
plates/fugler/porzana-porzana.png
