sonwit/Bilderamme/plates/fugler/pyrrhula-pyrrhula-flyvende.png

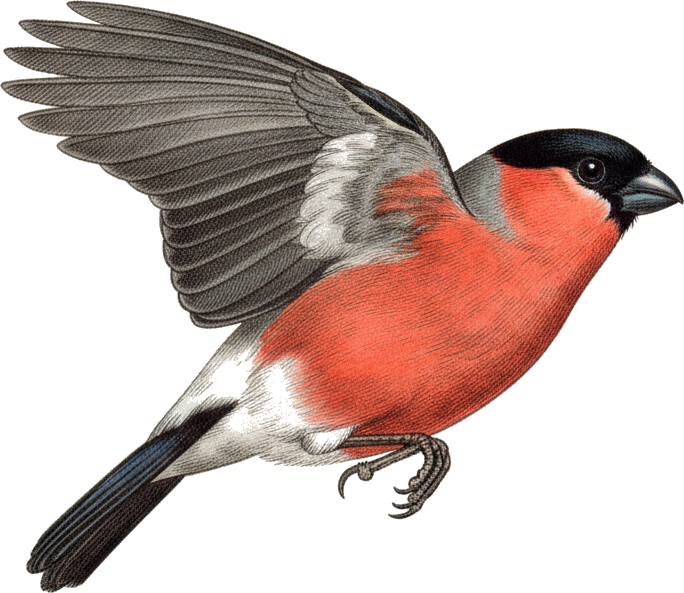
plates/fugler/pyrrhula-pyrrhula-flyvende.png
