sonwit/Bilderamme/plates/fugler/regulus-regulus-flyvende.png

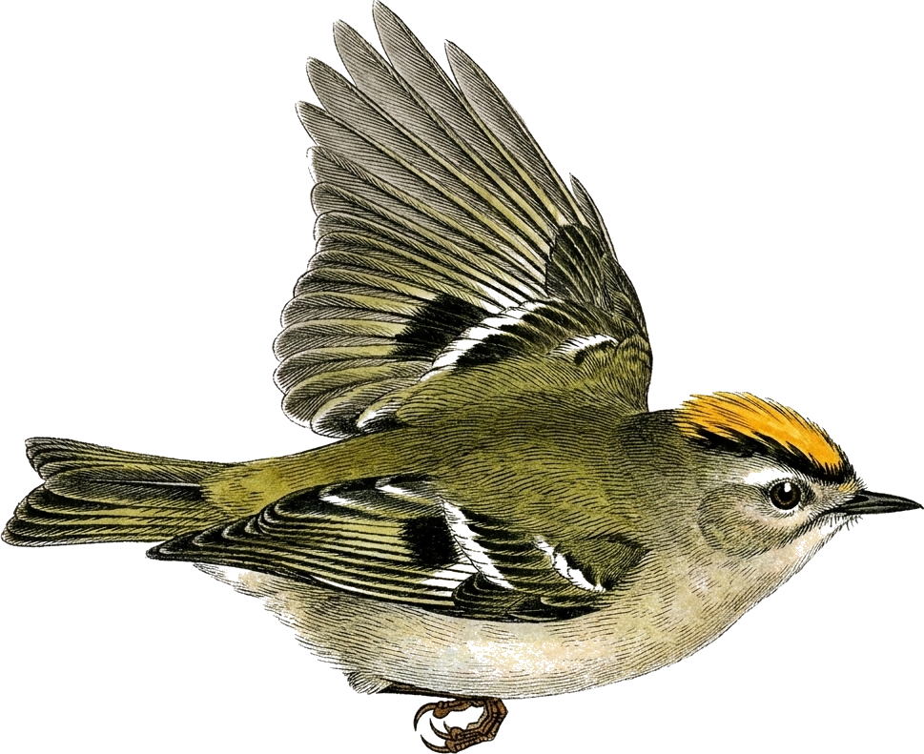
plates/fugler/regulus-regulus-flyvende.png
