sonwit/Bilderamme/plates/fugler/regulus-regulus.png

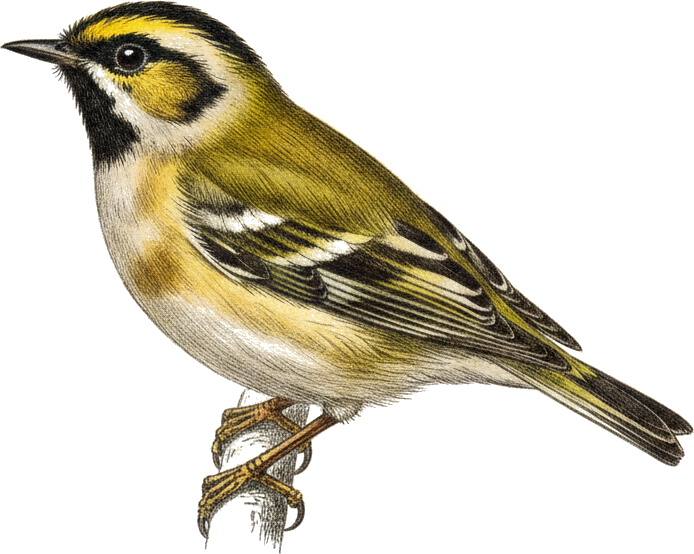
plates/fugler/regulus-regulus.png
