sonwit/Bilderamme/plates/fugler/sitta-europaea-klatrende.png

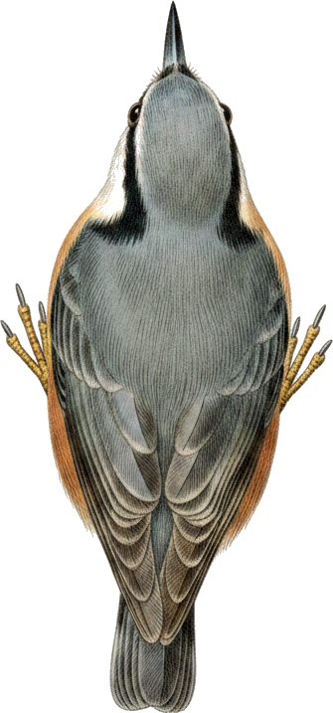
plates/fugler/sitta-europaea-klatrende.png
