sonwit/Bilderamme/plates/fugler/sitta-europaea.png

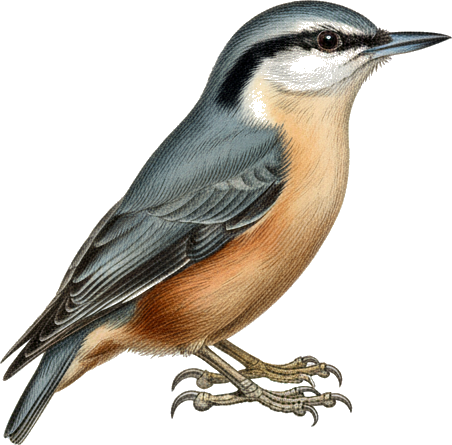
plates/fugler/sitta-europaea.png
