sonwit/Bilderamme/plates/fugler/spinus-spinus.png

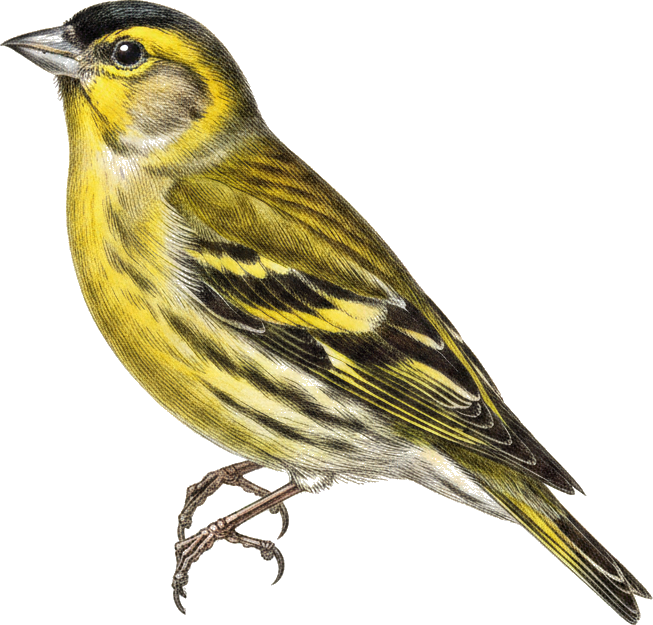
plates/fugler/spinus-spinus.png
