sonwit/Bilderamme/plates/fugler/strix-aluco-flyvende.png

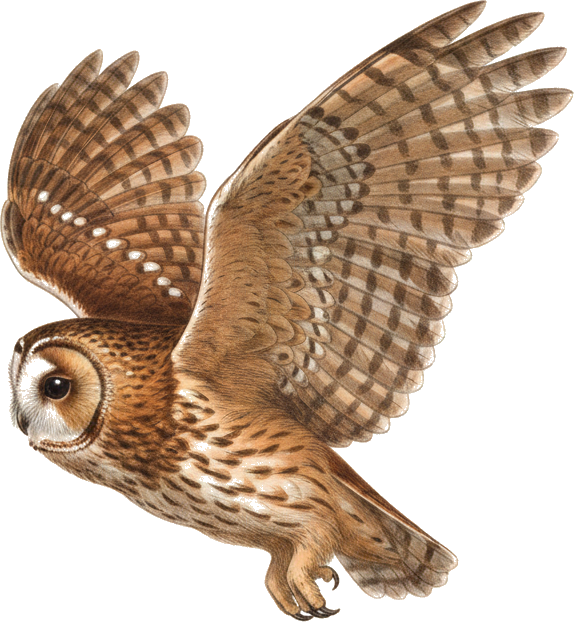
plates/fugler/strix-aluco-flyvende.png
