sonwit/Bilderamme/plates/fugler/strix-aluco.png

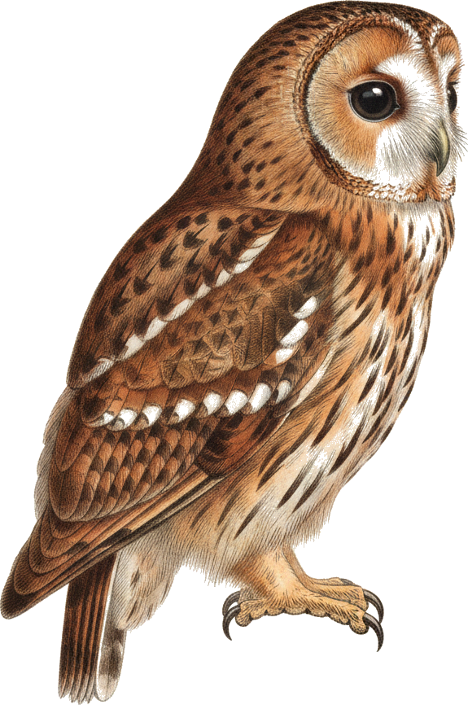
plates/fugler/strix-aluco.png
