sonwit/Bilderamme/plates/fugler/turdus-iliacus-flyvende.png

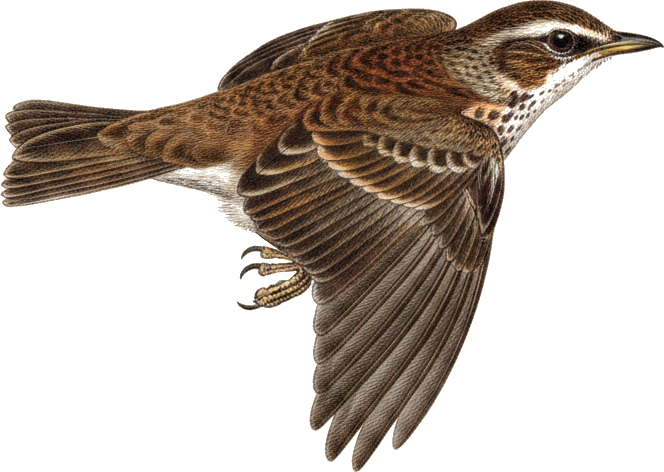
plates/fugler/turdus-iliacus-flyvende.png
