sonwit/Bilderamme/plates/fugler/turdus-iliacus.png

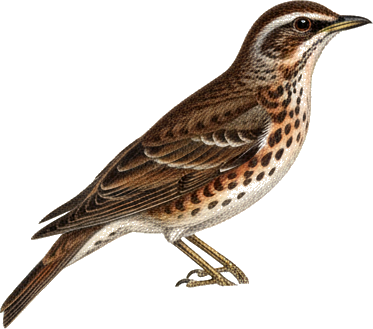
plates/fugler/turdus-iliacus.png
