sonwit/Bilderamme/plates/fugler/turdus-merula-flyvende.png

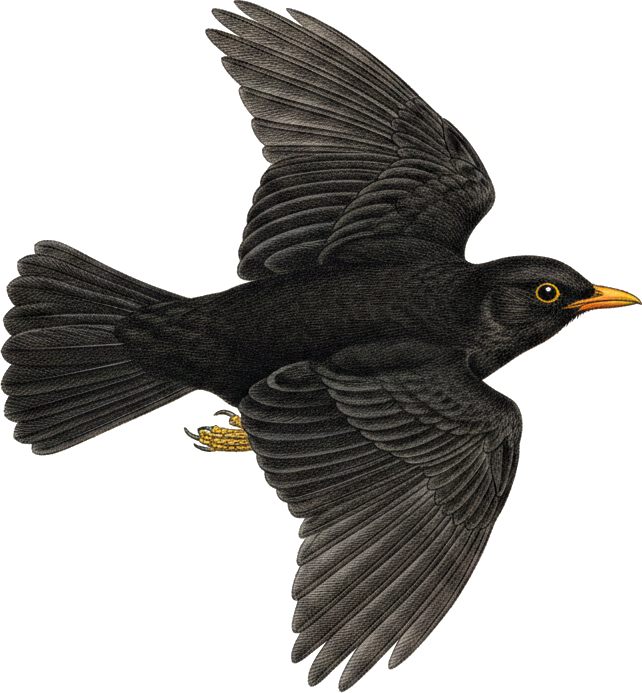
plates/fugler/turdus-merula-flyvende.png
