sonwit/Bilderamme/plates/fugler/turdus-merula.png

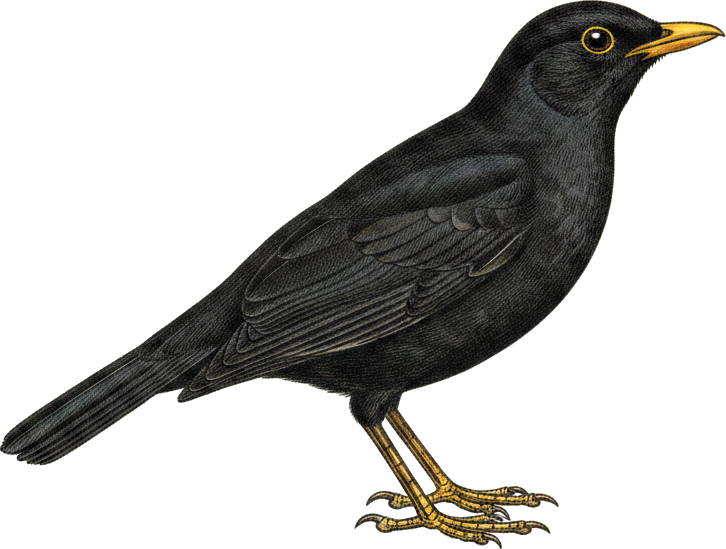
plates/fugler/turdus-merula.png
