sonwit/Bilderamme/plates/fugler/turdus-pilaris-flyvende.png

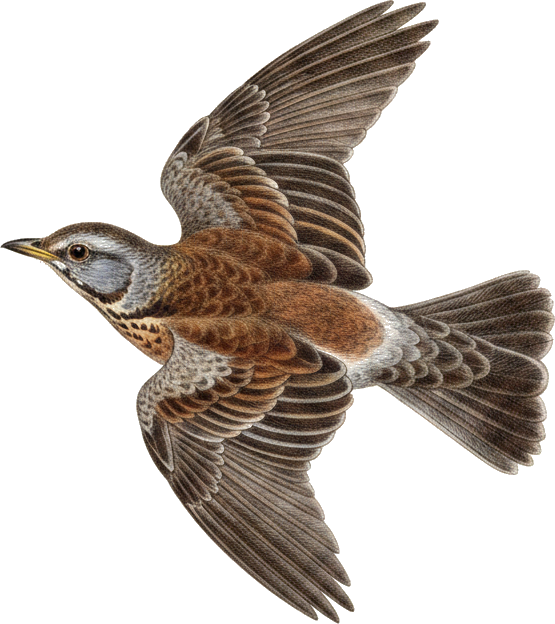
plates/fugler/turdus-pilaris-flyvende.png
