sonwit/Bilderamme/plates/fugler/turdus-pilaris.png

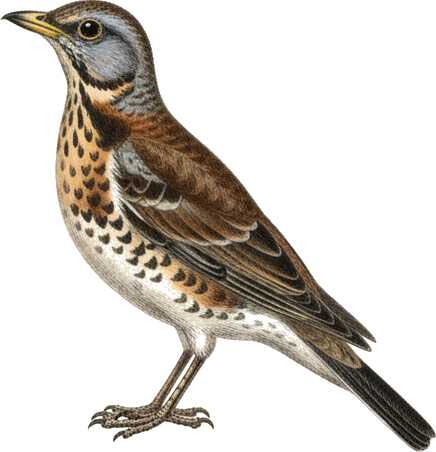
plates/fugler/turdus-pilaris.png
