sonwit/Bilderamme/plates/fulmarus-glacialis.jpg

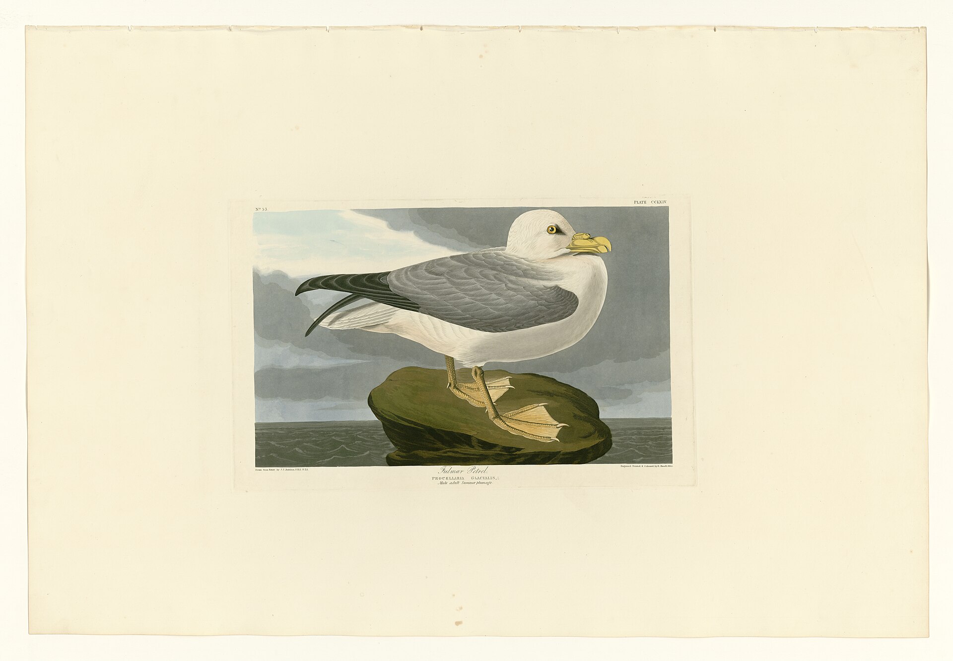
plates/fulmarus-glacialis.jpg
