sonwit/Bilderamme/plates/gallinago-gallinago.jpg

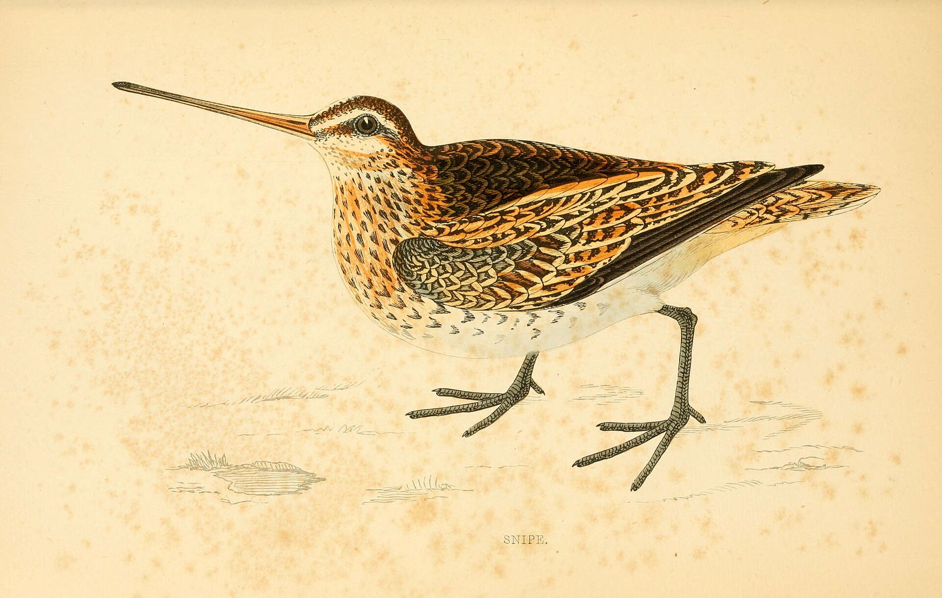
plates/gallinago-gallinago.jpg
