sonwit/Bilderamme/plates/loxia-curvirostra.jpg

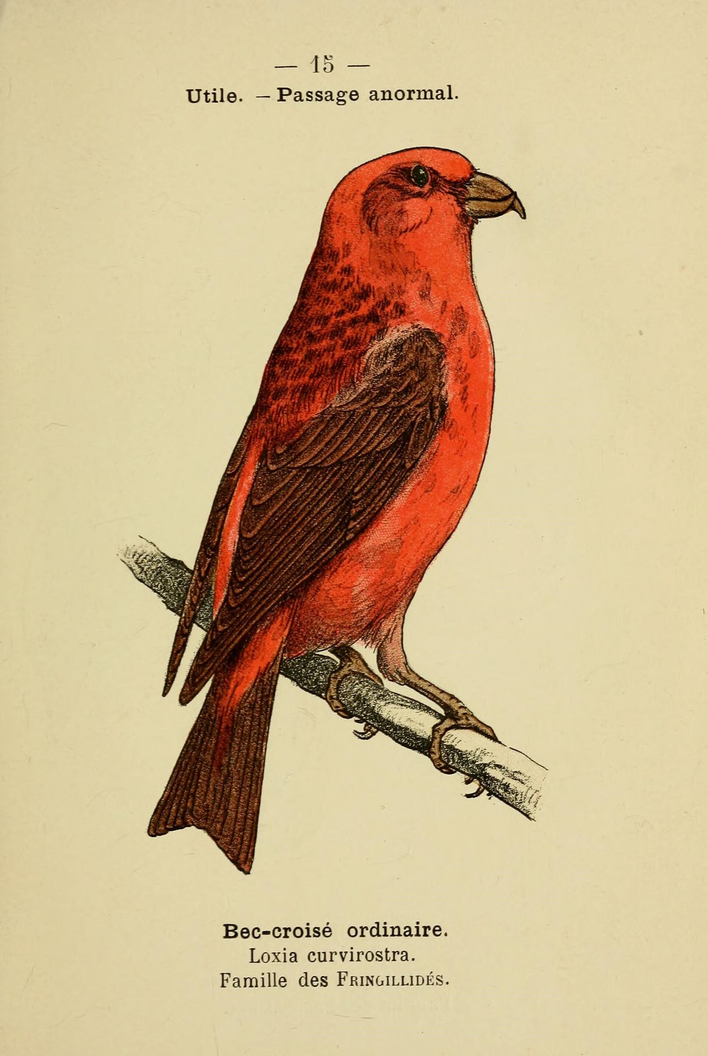
plates/loxia-curvirostra.jpg
