sonwit/Bilderamme/plates/maler/gran.png

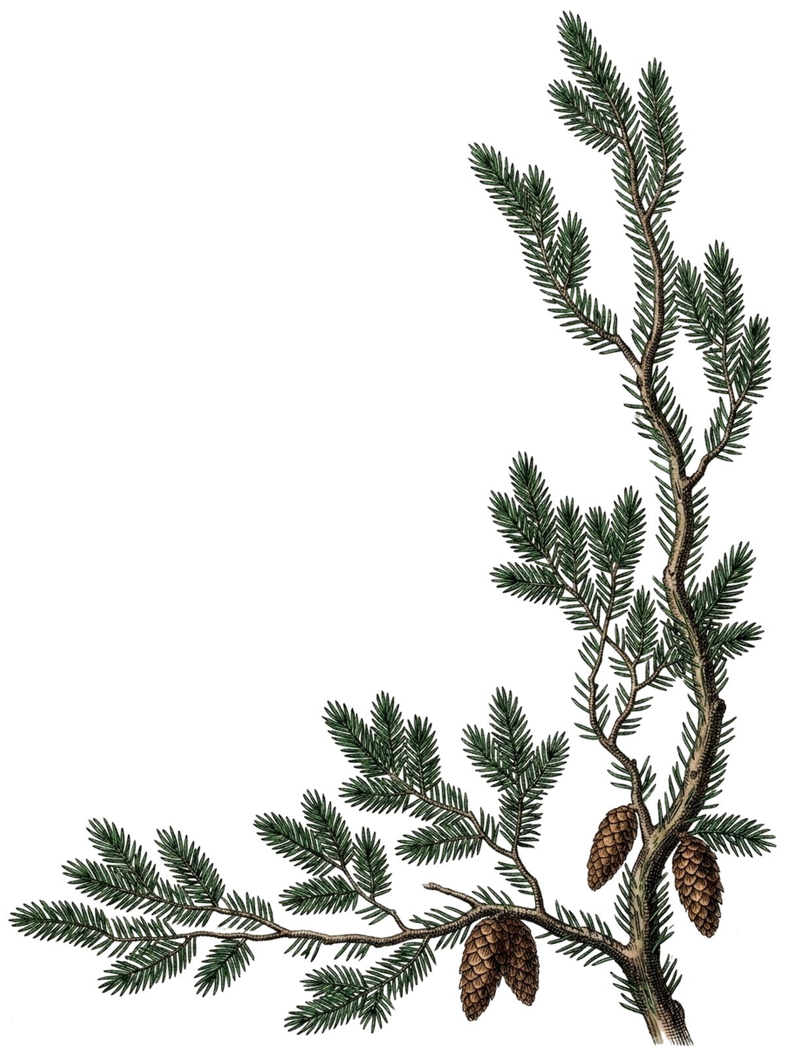
plates/maler/gran.png
