sonwit/Bilderamme/plates/maler/myr.png

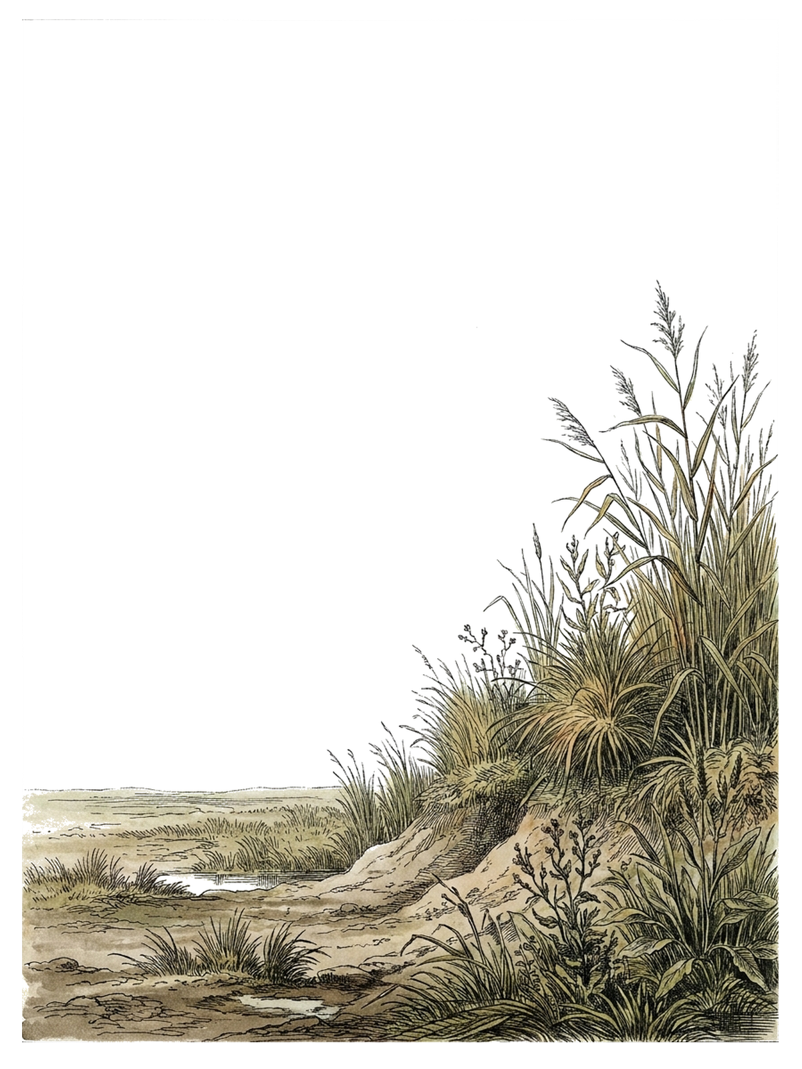
plates/maler/myr.png
