sonwit/Bilderamme/plates/maler/rogn.png

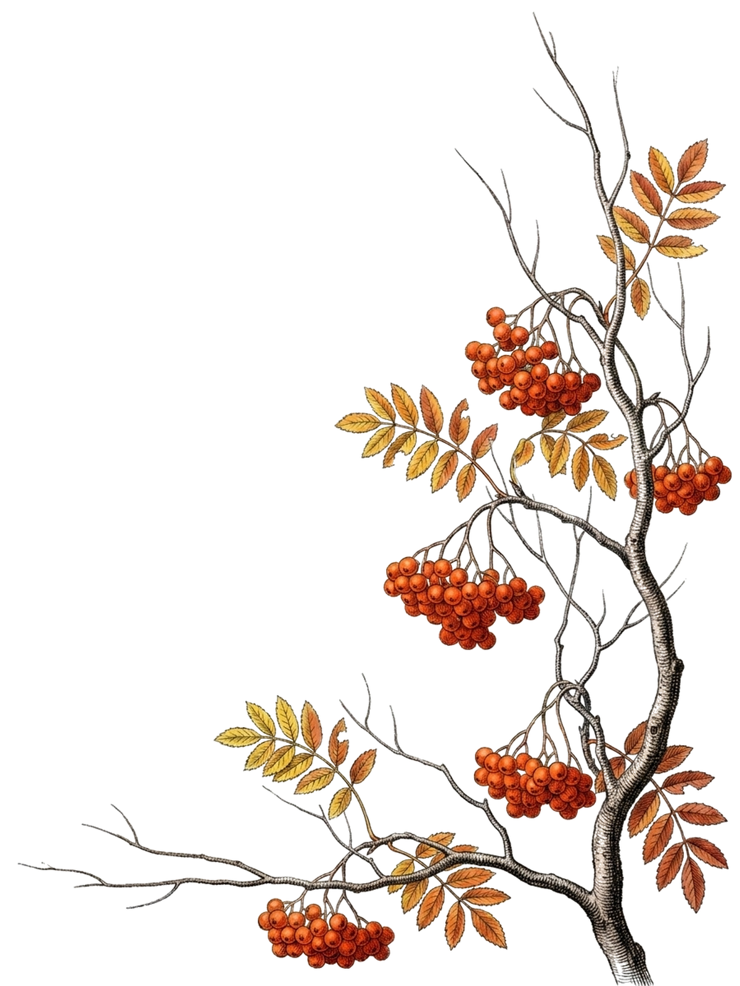
plates/maler/rogn.png
