sonwit/Bilderamme/plates/mareca-strepera.jpg

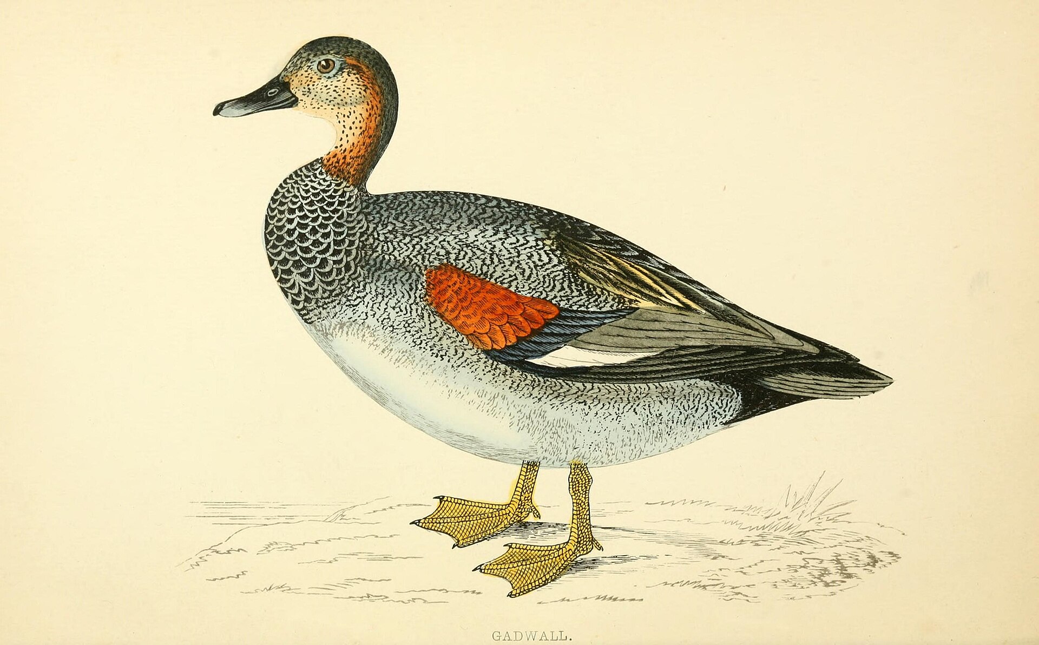
plates/mareca-strepera.jpg
