sonwit/Bilderamme/plates/parus-major.jpg

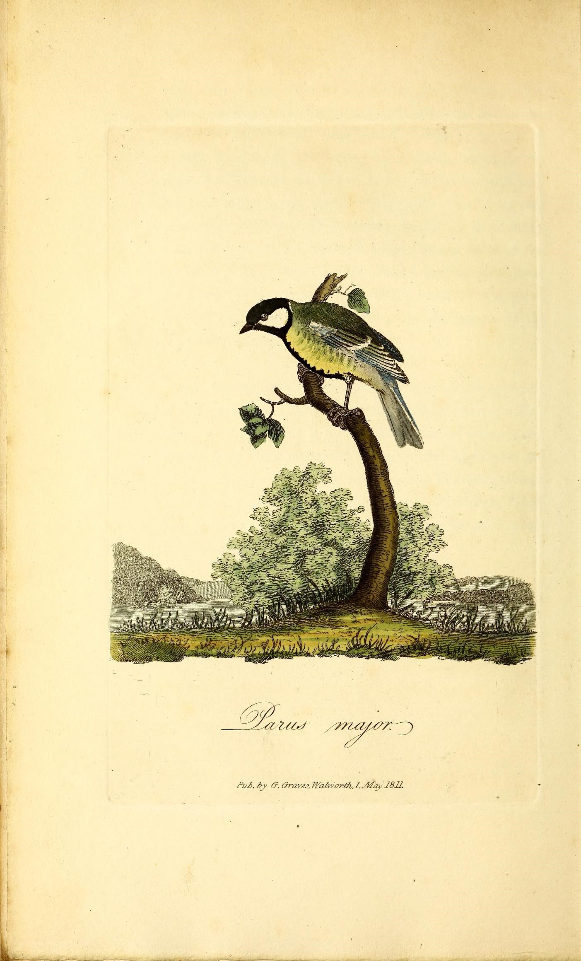
plates/parus-major.jpg
