sonwit/Bilderamme/plates/periparus-ater.jpg

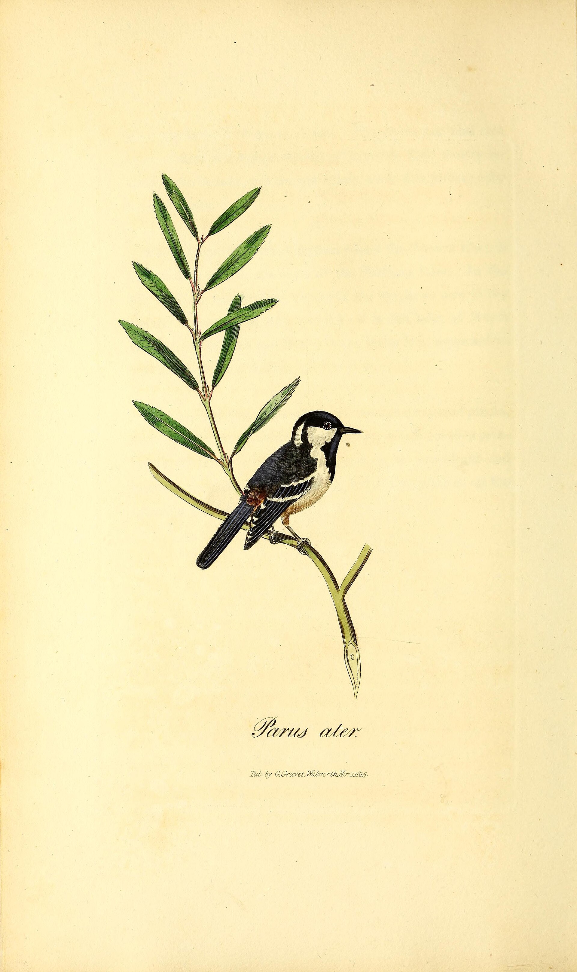
plates/periparus-ater.jpg
