sonwit/Bilderamme/plates/phoenicurus-phoenicurus.jpg

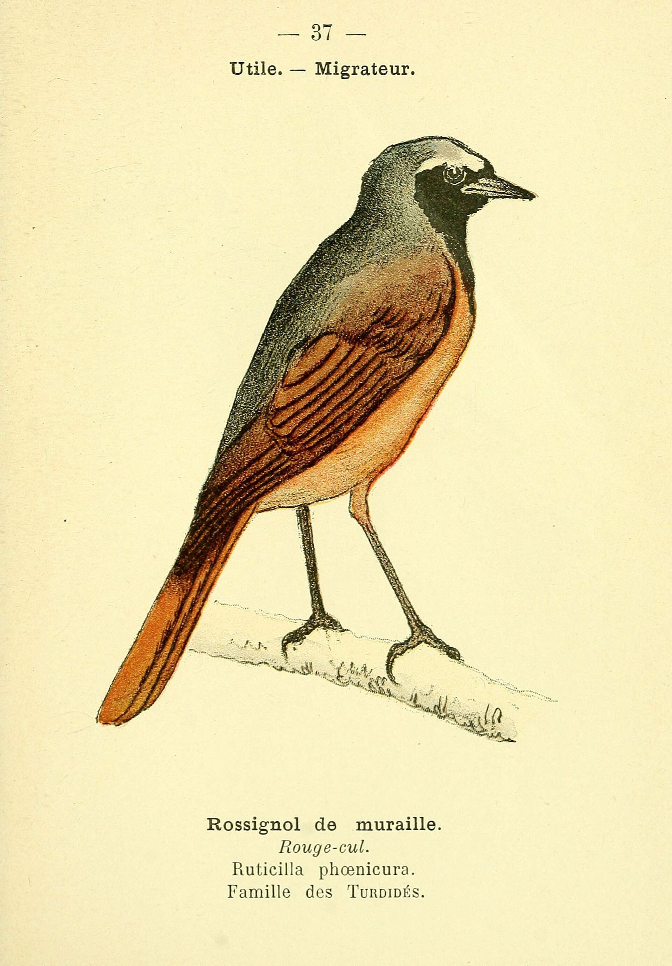
plates/phoenicurus-phoenicurus.jpg
