sonwit/Bilderamme/plates/phylloscopus-collybita.jpg

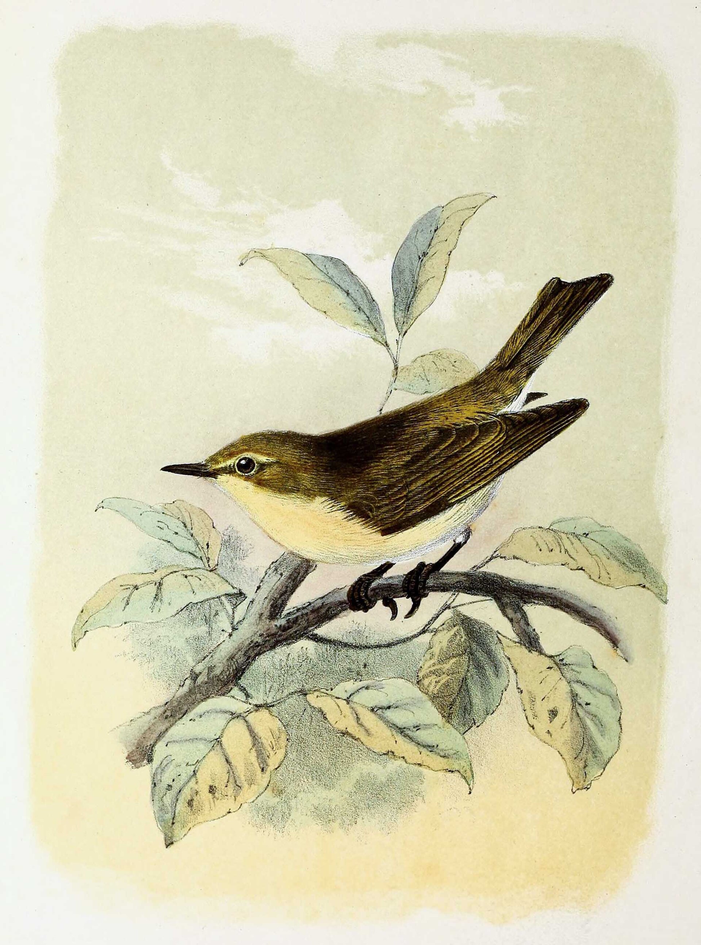
plates/phylloscopus-collybita.jpg
