sonwit/Bilderamme/plates/pica-pica.jpg

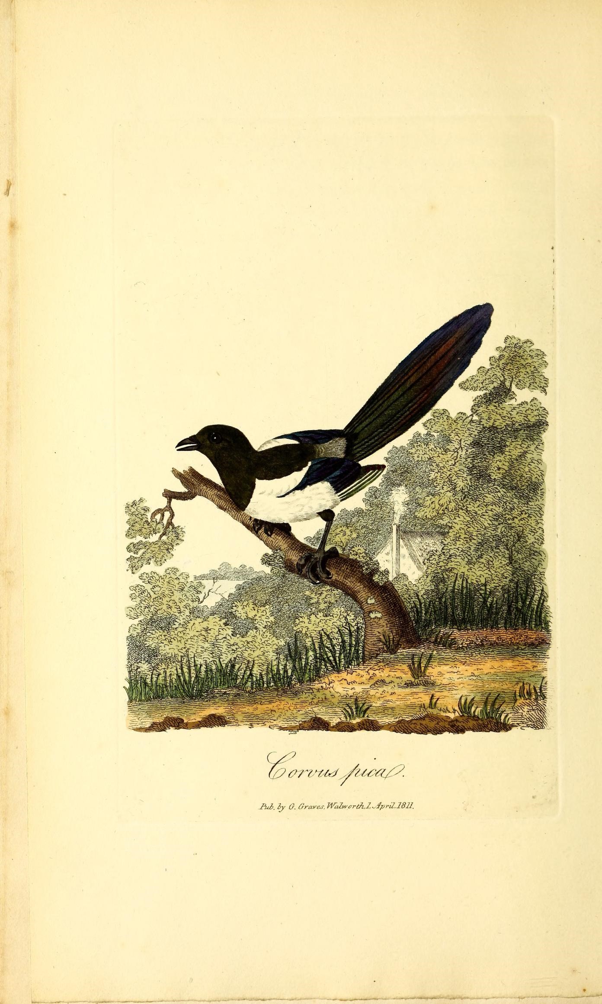
plates/pica-pica.jpg
