sonwit/Bilderamme/plates/porzana-porzana.jpg

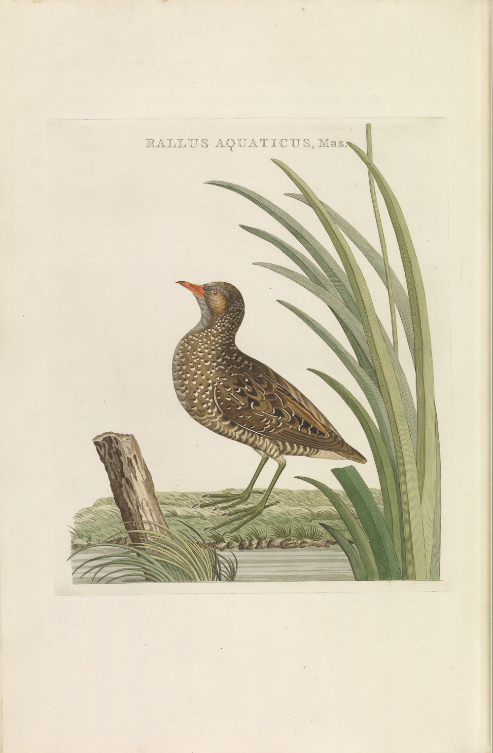
plates/porzana-porzana.jpg
