sonwit/Bilderamme/plates/pyrrhula-pyrrhula.jpg

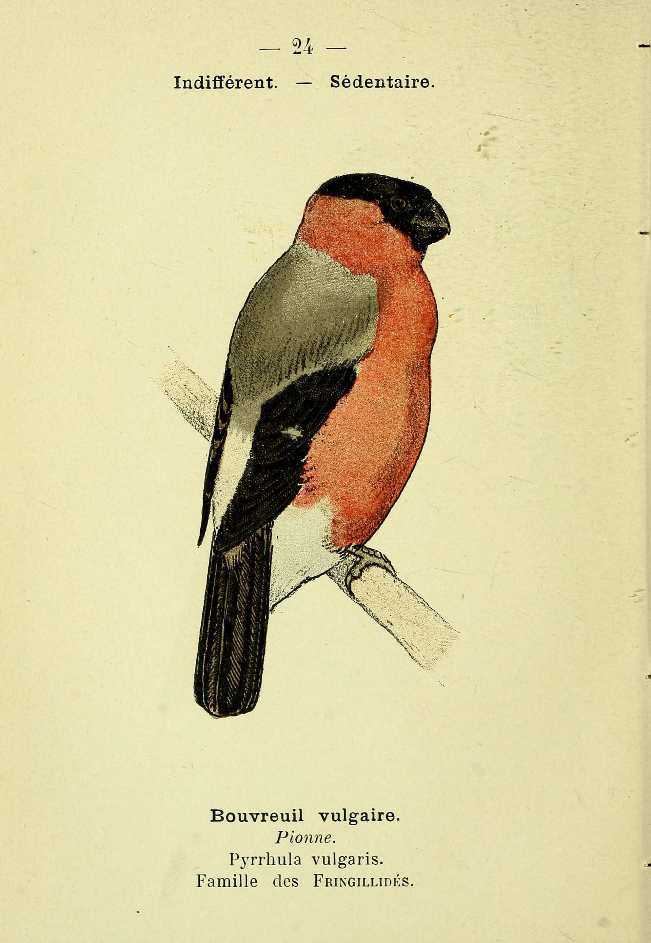
plates/pyrrhula-pyrrhula.jpg
