sonwit/Bilderamme/plates/regulus-regulus.jpg

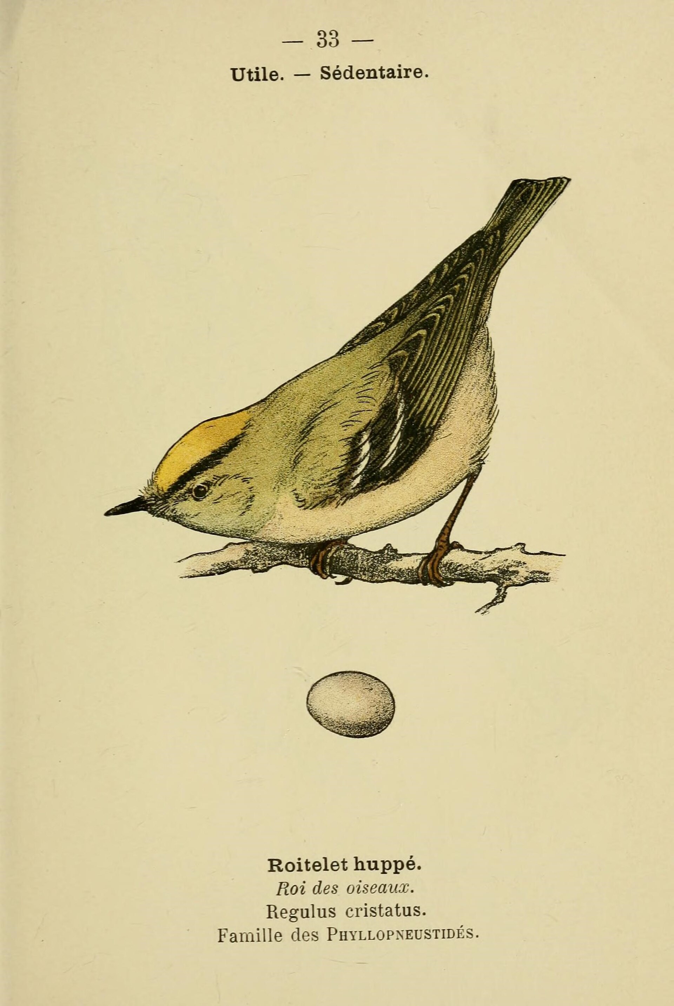
plates/regulus-regulus.jpg
