sonwit/Bilderamme/plates/sitta-europaea.jpg

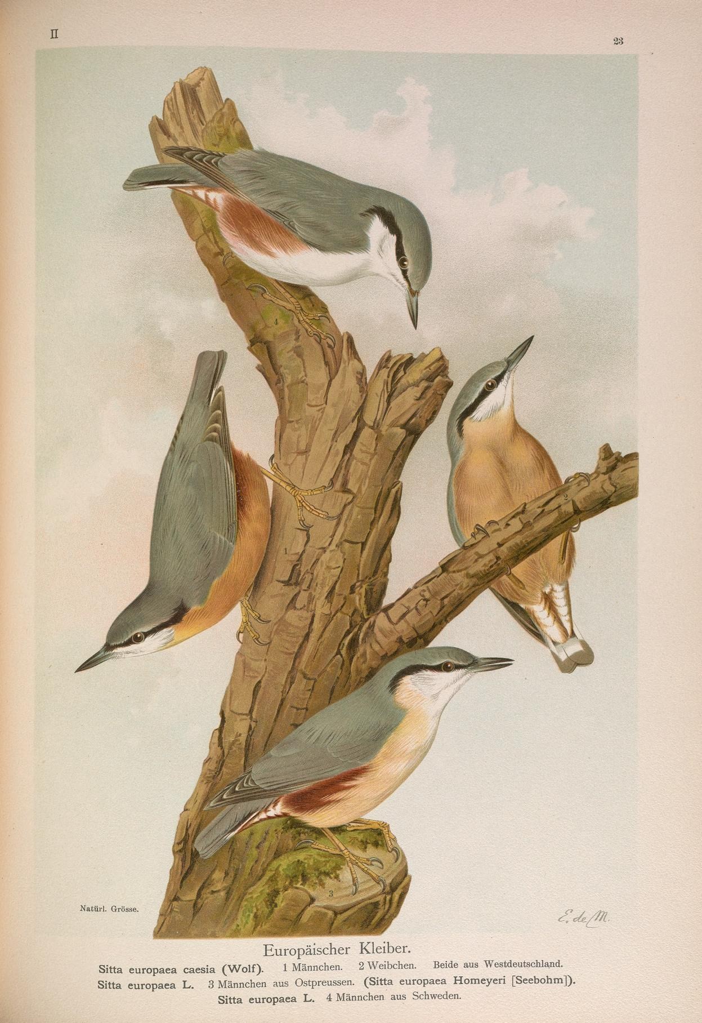
plates/sitta-europaea.jpg
