sonwit/Bilderamme/plates/spinus-spinus.jpg

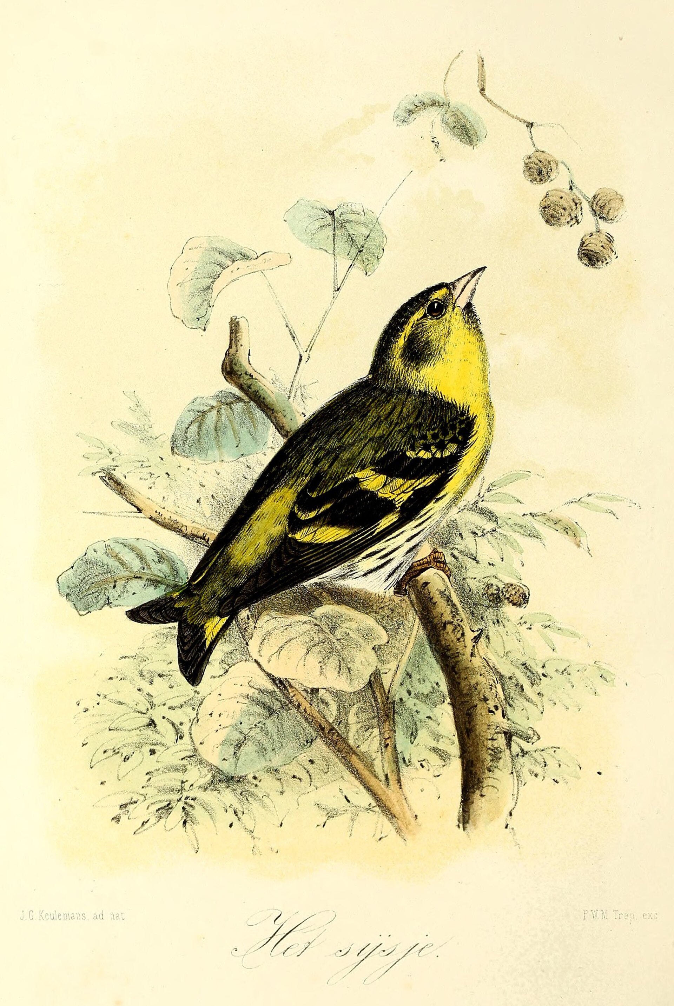
plates/spinus-spinus.jpg
