sonwit/Bilderamme/plates/strix-aluco.jpg

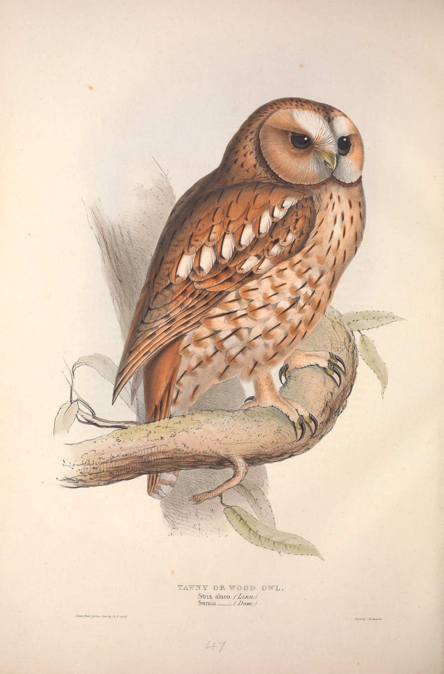
plates/strix-aluco.jpg
