sonwit/Bilderamme/plates/turdus-iliacus.jpg

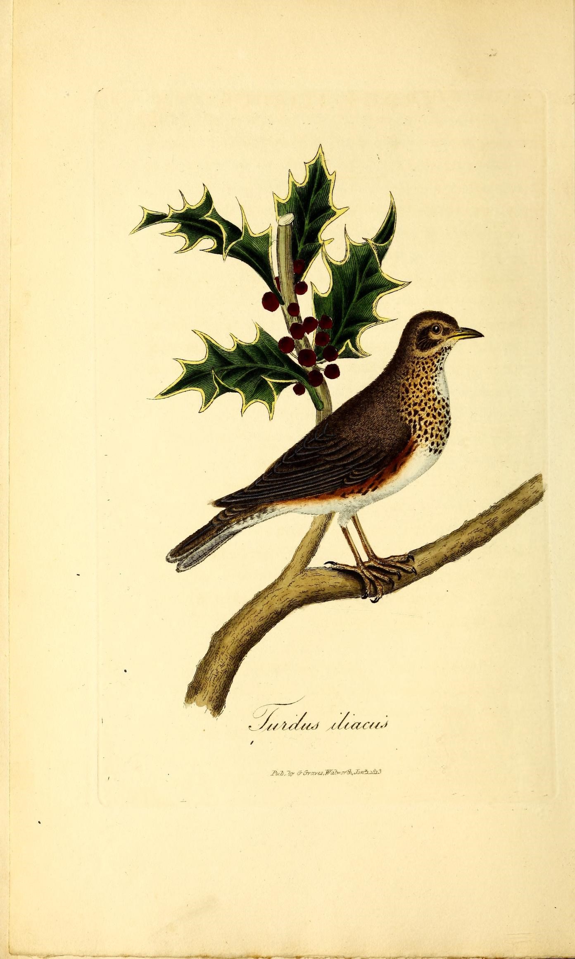
plates/turdus-iliacus.jpg
