sonwit/Bilderamme/plates/turdus-merula.jpg

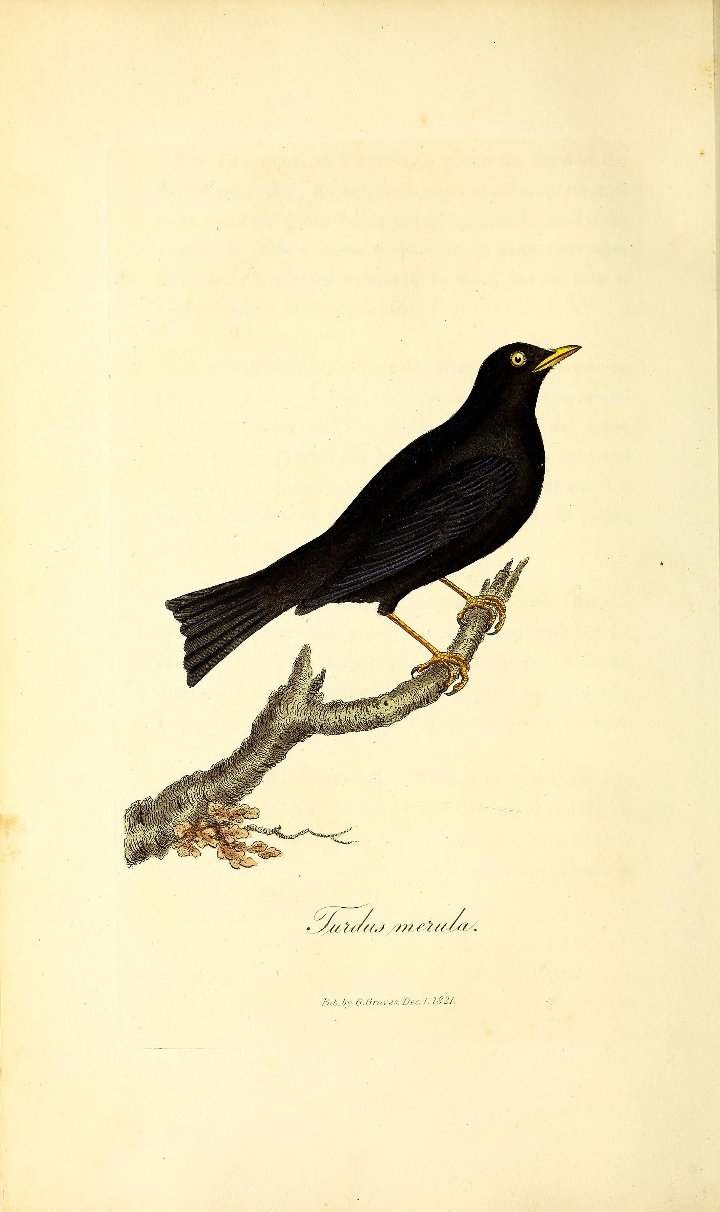
plates/turdus-merula.jpg
