sonwit/Bilderamme/plates/turdus-pilaris.jpg

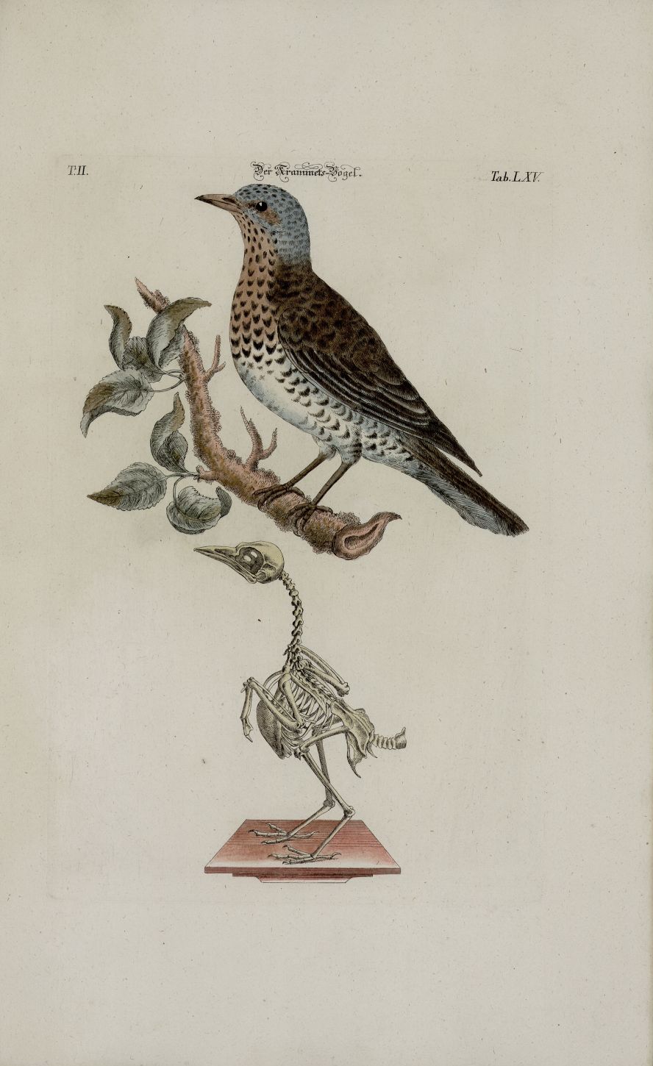
plates/turdus-pilaris.jpg
