sonwit/Bilderamme/(commit log)

2026-07-26 Legg til resten av prosjektet: firmware, frame-server, deploy og docs
    - firmware/indoor_frame/: ESP32-S3-sketch (HTTP-server, POST /display),
    Waveshare-driver og lyd (ES8311 + pling ved nytt bilde).
    - tools/frame_server.py: on-demand generering (Siri/web-galleri, port 8090).
    - tools/send_to_frame.py: manuell testing fra Macen.
    - deploy/: deploy.sh, systemd-tjeneste og env-eksempel for hjemmeserveren.
    - docs/: prosjektnotater, faser og guider.
    - .gitignore: hold testbilder og lokalt rask utenfor.
2026-07-26 BirdNET: dagens motiv fra fugler som faktisk er hoert i hagen
    - pi/: opptak paa utedelen (record_and_upload.sh, crontab, power-tuning).
    - tools/birdnet_analyze.py: analyserer opptak paa serveren, skriver birds.json.
    - tools/bird_stats.py: statistikk over hoerte arter.
    - generate_daily_image.py: er birds.json fersk (fra i dag), trekkes dagens
    motiv vektet blant toppartene i stedet for tilfeldig DAILY_SUBJECTS.
2026-08-04 Utedel v2: firmware for XIAO ESP32-S3
    Erstatter Pi 3 B (v1) som lydsensor: deep sleep etter opptaksplanen
    (04:00-08:30 hvert 30. min, 09-21 hver time), 60 s I2S-opptak fra
    INMP441 rett i PSRAM foer radioen slaas paa, NTP-synk som venter paa
    ekte SNTP-fullfoering (RTC drifter minutter per natt), hoeypassfilter
    mot vindrumling (150 Hz), og HTTP-opplasting med helse-JSON-sidecar.
    ~14 uA i soevn mot Pi-ens ~450 mA konstant. Ingen opptakskoe i v1 av
    firmwaren: PSRAM doer i deep sleep — tapte opplastinger vises som hull
    i dekningsstatistikken.
    [config.example.h, outdoor_sensor.ino]
2026-08-04 Server: audio_ingest tar imot opptak fra ESP32-utedelen
    ESP32 kan ikke scp/ssh slik Pi-en gjorde, saa utedelen POST-er WAV +
    helse-JSON til :8091 i stedet. Samme filnavnkonvensjon og analysekjede
    som foer — birdnet_analyze, observasjonslogg og statistikk er uroert.
    Kjoeres som systemd-tjeneste i venv-birdnet; deploy.sh installerer
    begge tjenestene og rydder bort manuelt startede instanser.
2026-08-04 BirdNET: normaliser paa 99,9-persentil-peak, ikke absolutt peak
    Utedelens hoeypassfilter gir ett fullskala-sample ved opptaksstart;
    absolutt peak paa 1.0 slo av normaliseringen for opptak som reelt er
    stille, og BirdNET mistet foelsomhet. peak999 ignorerer enkeltsamples.
2026-08-04 Docs: utedel v2 i drift — oppdater README og begge utedel-dokumentene
    README: status, struktur, serveroversikt og maskinvare reflekterer naa
    hele systemet (inneramme + webapp/Siri + utedel v2 + BirdNET-pipeline).
    V2-dokumentet: migreringen gjennomfoert, stroemvalget dokumentert med
    maaleresultater (5V-utgangen forkastet, XIAO rett paa batteriet),
    vindfunnet og fiksene, kjente quirks, og videre planer (batterimaaling,
    permanent lodding). V1-dokumentet stemplet som historikk.
2026-08-04 Utedel v2: fjernkonfig over HTTP — juster parametre uten aa hente boksen
    ESP-en henter GET /config etter hver opplasting og lagrer i RTC-minne;
    nye verdier gjelder fra neste oekt. Justerbart: gain, hoeypass,
    opptakslengde, testmodus og hele opptaksplanen. Serveren lagrer
    esp_config.json og tar imot POST /config. "rev" ekkoes som cfg_rev i
    helse-JSON, saa man ser naar brikken har plukket opp endringen.
    Inkluderer ogsaa priming av hoeypassfilteret (fjerner fullskala-
    samplet ved opptaksstart).
2026-08-05 Docs: rett opp port 8080-referanser — www serveres ikke over HTTP
    Galleriet ligger paa frame_server (:8090); raafilene i www/ hentes med scp.
    Legg ogsaa til at fugleramme.local er ramma (192.168.1.94), ikke serveren —
    serveren heter hjemmeserveren og kunngjoer ikke noe .local-navn.
2026-08-05 BirdNET: bruk opptakets dato, og fjern normaliseringen som ikke gjorde noe
    To funn fra maalinger paa 131 opptak:
    1. Normaliseringen var en no-op. BirdNET normaliserer selv internt. A/B paa
    10 opptak fra begge utedelene (ESP32 og Pi, forsterkning +16 til +39 dB)
    ga identisk konfidens, avvik <= 0,01. Fjernet — den kostet en temp-fil
    skrevet og lest per opptak uten aa paavirke resultatet.
    2. analyze() sendte datetime.date.today() til BirdNET i stedet for opptakets
    egen dato. BirdNET bruker dato + posisjon til aa avgjoere hvilke arter som
    er sannsynlige den uka, saa samme lydfil fikk ulikt svar avhengig av NAAR
    den ble analysert: fugl_20260727_062001.wav gir null myrrikse m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
2026-08-27 Flashing uten Arduino IDE: arduino-cli-script og oppsettsguide
    Board-innstillingene laa bare i en IDE-meny og i en tabell i docs — etter
    en nullstilt Mac maatte de settes for haand paa nytt. Naa ligger de i repoet
    som FQBN, og tools/flash_firmware.sh kompilerer, finner USB-porten og laster
    opp begge brettene.
    - tools/flash_firmware.sh: inne/utedel, --sjekk (kompiler uten brett),
    --port, --monitor. Installerer esp32-kjernen hvis den mangler, og lager
    config.h fra malen med beskjed om aa fylle inn WiFi.
    - docs/Flashing med arduino-cli.md: foerstegangsoppsett paa Macen,
    IDE-innstilling -> FQBN-tabell, feilsoeking, og hva som maa gjoeres med
    FRAME_HOST naar rammen faar ny DHCP-IP ette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
2026-08-27 Innedel: watchdog + WiFi som kommer tilbake av seg selv
    Rammen henger i veggen og har ingen som trykker reset. Naa passer den paa
    seg selv:
    - Task-watchdog paa 120 s, panic -> omstart. Timeouten maa vaere romslig
    fordi en normal skjermtegning blokkerer i 25-35 s, men den fanger det
    som faktisk henger: driverens ReadBusyH venter i en uendelig loekke hvis
    BUSY-pinnen aldri slipper. Mates i loop() og i mottaksloekken.
    - WiFi ved oppstart: gir opp etter 60 s og starter paa nytt, i stedet for
    aa henge i while(status != CONNECTED) til noen drar ut stroemmen.
    - WiFi under drift: wifiKeepAlive() kobler til igjen naar nettet forsvinner,
    og starter brettet paa nytt hvis det ikke er tilbake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
    [indoor_frame.ino]
2026-08-27 Rammens adresse: bruk navnet, og slaa opp mDNS selv
    Rammen fikk ny DHCP-leie (.94 -> .92) etter en omstart 26.08., og da stoppet
    dagens bilde uten at noe annet feilet. push_to_frame.py brukte allerede
    fugleramme.local, men frame_server.py hadde IP-en hardkodet som default —
    saa webappen og Siri gikk i "No route to host" mens cron var uberoert.
    - push_to_frame.py: resolve_host() slaar opp .local over mDNS paa egen haand
    naar OS-et ikke klarer det (stdlib, ingen avahi/libnss-mdns paa serveren).
    Verifisert mot rammen: fugleramme.local -> 192.168.1.92 paa 1,4 s.
    - frame_server.py: arver defaulten fra push_to_frame i stedet for aa ha sin
    egen. Ett sted, ikke to som kan sprike.
    - Fjernet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
2026-08-27 Flash-script: si fra om Rosetta i stedet for "bad CPU type"
    arduino-cli kjoerer Arduinos ctags under kompileringen, og den finnes bare
    som Intel-binaer. Paa en fersk Apple Silicon-Mac stopper byggingen med
    "fork/exec ...: bad CPU type in executable", som ikke sier noe om hva man
    skal gjoere. Nå sjekker scriptet foerst og peker paa
    softwareupdate --install-rosetta.
    (universal-ctags fra Homebrew ble proevd som native alternativ — den mangler
    feltene Arduino bruker til aa generere prototyper og lager kode som ikke
    kompilerer. Rosetta er veien.)
2026-08-27 Flashing-doc: Rosetta, de to USB-portene, og at FRAME_HOST skal vaere navnet
    Tre ting som kostet tid i dag:
    - Apple Silicon trenger Rosetta til arduino-clis ctags. Feilmeldingen
    ("bad CPU type in executable") sier ingenting om hva man skal gjoere.
    - Innedelen dukker opp som to /dev/cu.usbmodem*-porter: Espressifs egen
    (flash hit) og en CH343 (serieutskriften kommer hit). Med CDCOnBoot=default
    gaar Serial.print paa UART-en, saa Serial Monitor paa Espressif-porten er
    helt tom — som ser ut som et doedt brett, men ikke er det.
    - Avsnittet om "endret IP-en seg" beskrev en jobb som ikke lenger finnes:
    push_to_frame.py slaar opp fugleramme.local selv.
2026-08-27 Rett opp historikken om .94: aatte doegn, ikke ett — og serveren HAR mdns
    Sjekket mot /opt/fugleramme/logs/daily.log paa serveren i stedet for aa tro
    paa overleveringen:
    - Rammen byttet IP en gang mellom 9. og 19. aug, ikke 26. aug. Pushen feilet
    aatte doegn paa rad (19.-26.) med [Errno 113], mens bildet ble generert og
    arkivert som normalt hver morgen. Veggen viste 9. august-bildet i 18 dager.
    - Serveren fikk libnss-mdns + avahi 26. aug og har FRAME_HOST=fugleramme.local
    i env-fila fra samme dag kl. 09:59. Paastanden om at serveren "mangler
    libnss-mdns" var altsaa feil da jeg skrev den.
    - Foerste vellykkede push var 27. aug 07:07 — dagens bilde var paa plass laenge
    foer jeg r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
2026-08-27 Fjern mDNS-oppslaget fra push_to_frame.py igjen
    Serveren har libnss-mdns + avahi fra 26. aug, saa getent loeser
    fugleramme.local der. De ~90 linjene med haandskrevet DNS-parsing var
    forsikring mot et problem som ikke finnes, og de maa vedlikeholdes.
    Koden i fila er naa byte-identisk med foer — bare docstringen er endret, og
    den sier naa hva som faktisk skjedde (aatte doegn, ikke "kan skje").
    Feiler navneoppslaget uten avahi, gir http.client en gaierror som allerede
    fanges av except OSError -> SendFailed -> retry, med IP i FRAME_HOST som
    utvei. Docs ryddet for omtale av resolve_host.
2026-08-27 bird_stats: mal dekningen mot utedelens plan, ikke Pi-ens gamle crontab
    EXPECTED_PER_HOUR var laast til Pi-en (*/20 i dagsangen = 31 oekter per
    doegn). Utedel v2 tar 23: hver halvtime 04:00-08:30, hver time 09:00-21:00.
    Resultatet var "⚠ hull, 76-84 %" hver eneste dag mens utedelen faktisk
    leverte hver eneste planlagte oekt. Etter fiksen: 23/23 (100 %) alle dager.
    - Planen leses naa fra DAWN_*/DAY_*-konstanter som speiler
    firmware/outdoor_sensor/config.h, ikke en per-time-tabell. Opptaket
    starter et minutt foer slottet (08:59 = 09:00-oekta), saa vi matcher med
    slingringsmonn.
    - Dekning teller hvilke planlagte oekter som kom, ikke hvor mange opptak som
    finnes. Ellers kunne en ekstr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
2026-08-27 Utedel: gjenskap batterilinja som bare fantes paa brikka
    Dumpet flashen fra utedelen (8 MB, esptool) og sammenlignet strengene med
    kilden. Alt stemte linje for linje bortsett fra én:
    Batteri: %.2f V (ADC-pinne %d, deler %.3f)
    Den finnes i binaeren og i ingen commit. Altsaa nok en ucommittet endring som
    ble flashet fra Macen og forsvant da Macen ble nullstilt — samme tap som
    watchdogen i innedelen, bare at ingen visste om denne.
    Verdien av linja er konkret: da config.h forsvant var det NETTOPP denne som
    fortalte oss at BATT_ADC_PIN = 1 og BATT_DIVIDER = 2.004. Helse-JSON-en
    rapporterer bare resultatet ("volt"), ikke hvordan det ble maalt. 2.004
    bekreftet uavhengig: den finnes noeyak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
2026-08-28 Norske fuglenavn og kroppslengder, noeklet paa latinsk navn
    BirdNET gir engelske navn, og de er ikke stabile mellom versjoner
    ("Eurasian Blue Tit" vs "Blue Tit"); Cyanistes caeruleus staar i ro.
    ~135 arter -- alle 41 utedelen har hoert saa langt, pluss vanlige hage-
    og skogsfugler. Ukjent art faller tilbake paa engelsk navn i kursiv, saa
    hull i lista synes paa veggen.
    Lengdene brukes til aa skalere fuglene i forhold til hverandre. Uten dem
    blir en skjaere paa 44 cm like stor som en groennsisik paa 12.
2026-08-28 Plansjer fra Wikimedia Commons, vasket for e-ink
    Commons har en "<Vitenskapelig navn> (illustrations)"-kategori for 40 av
    de 41 artene utedelen har hoert -- 2166 illustrasjoner, alle falt i det fri.
    Kategoriene er rotete (frimerker, lydfiler, 250 px-utsnitt), saa
    fetch_plates.py lager kortliste og mennesket velger. plates.json holder
    kilde og lisens for hver, saa vi kan svare paa hvor et bilde kommer fra.
    prepare_plates.py loeser det som naesten stoppet hele idéen: en raa
    skanning har papirtone som ikke finnes i paletten, saa Atkinson gjetter
    den med gule prikker og hele arket braaker. Hvitpunktet strekkes PER KANAL
    (gulstikket ligger i at R og G er hoeyere enn B -- felles skalering ville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
2026-08-28 Daglig kjoering byttet til fuglesida, med AI-bildet som reserve
    daily_panel.py kjoerer hele kjeden og gaar bare ut med 0 hvis frame.bin
    faktisk finnes og er 960000 byte. Cron paa serveren:
    { daily_panel.py || generate_daily_image.py; } && push_to_frame.py
    Har ingen av dagens arter faatt plansje ennaa, eller er Gemini nede, faller
    den tilbake paa den gamle veien -- da henger det et bilde paa veggen i
    stedet for ingenting. Sida arkiveres i www/arkiv/ saa galleriet paa :8090
    faar med historikken ogsaa for panelet.
2026-08-28 deploy.sh: ta med de nye verktoeyene og plansjebiblioteket
    Cron kjoerer naa daily_panel.py, men deploy.sh kopierte fortsatt bare de
    opprinnelige seks filene — en deploy ville latt de nye ligge igjen med
    gammel kode paa serveren uten at noe klaget.
    Kopierer ikke plates/vasket/ (lages av prepare_plates.py) eller
    plates/dagens-* (byttes hver morgen).
2026-08-28 Nummerer fuglene paa plansjen og i lista
    Med fem fugler paa grenen var det ingen maate aa se hvilken linje som hoerte
    til hvilken fugl. Nummeret staar naa begge steder.
    To valg verdt aa notere:
    * Bare artene som faktisk er TEGNET faar nummer, og de loeper 1..k i listas
    rekkefoelge. Numererte vi alle linjene, ville 1, 7 og 8 peke paa fugler som
    ikke finnes paa plansjen -- et tall uten svar er verre enn ikke noe tall.
    Tallplassen holdes av ogsaa paa de unummererte linjene, saa navnene
    fortsatt staar paa linje.
    * Plasseringen finnes i compose_branch.py, ikke i HTML-en. Den har pikslene
    og kan lete opp en flekk som faktisk er hvit; et tall lagt oppaa greina
    eller i fjaerdrakten for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
2026-08-28 Maler per habitat og aarstid i stedet for én fast gren
    En mal er ett habitat: et bakgrunnsbilde og en liste plasser aa sette fugler
    paa, lagret som JSON i plates/maler/. En ny mal er derfor en fil, ikke en
    kodeendring. Malen velges av dagens arter, maaneden og vaeret.
    Plass-typene svarer til hva fuglen faktisk gjoer:
    gren sitter paa ved -- y snappes til greinas overflate, fotpunkt brukes
    bakke staar paa mark -- y er bakkelinja, ingen snapping
    luft flyr -- ingen foetter, fuglen sentreres, og den tegnes i
    FLYGENDE positur (egen 1:1-fil per art)
    Habitatet ligger i bird_names.py. En plass tar bare imot arter som hoerer
    hjemme der -- en s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
2026-08-28 Fiks: hvitt MIDT i fuglen ble klippet bort
    Skjaera mistet buk og skulderflekk og ble gjennomsiktig der. Aarsaken var
    utklippingen, ikke genereringen: cutout() fjernet alt lysere enn terskelen,
    uansett hvor det laa. Hvit fjaerdrakt er like hvit som papiret.
    Bakgrunn er ikke "lyst", det er "lyst og ikke omsluttet av fugl".
    scipy.ndimage.binary_fill_holes fyller nettopp de hullene i motivmasken som
    ikke henger sammen med kanten. Verifisert at utsnittet blir bit for bit likt
    det gamle (pica-pica: 531x391 baade foer og etter), saa de lagrede
    fotpunktene fortsatt stemmer.
    PIL sin ImageDraw.floodfill ble proevd foerst -- den fylte 0 % i denne
    Pillow-versjonen, saa hele bildet ble staaende som mot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
2026-08-28 Sorter lista paa sikkerhet, og bygg pusse-instruksen av det som staar i bildet
    Sorteringen laa paa belegg -- flest oekter foerst -- med den begrunnelsen at
    en art hoert i flere oekter er mer troverdig enn én med hoey score i én
    tre-sekunders bit. I praksis ga det feil svar: myrriksa la seg oeverst med
    58 % og fire oekter, og en myrrikse i en hage paa Hagen er et av de klassiske
    BirdNET-feiltreffene. Fire svake treff paa samme feil art er fortsatt fire
    svake treff. Naa staar hoeyest score oeverst; --sortering belegg gir den
    gamle oppfoerselen.
    Pusse-instruksen var en fast tekst om aa faa fuglene til aa "sitte paa veden
    de staar paa". Paa myrmalen ga det tull: en flygende skjaere har ingen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
2026-08-28 Myrmalen: bakkeplassene opp til sivkanten, og en grankvist-variant
    Myrriksa forsvant i sivet. Maalingen forklarte hvorfor: under y~1380 er
    vegetasjonen 97-100 % dekket, saa en fugl som staar der har hele kroppen mot
    moerkt lauv. Bakkeplassene ligger naa rett under sivkanten (~y 1250), der
    kroppen staar mot lyst papir og bare beina er nede i vegetasjonen.
    Plassene kan sette sin egen maks_overlapp. Paa myrkanten finnes det bare
    ett baelte -- x 600-900 -- der en bakkefugl faar kroppen mot lyst papir, fordi
    venstre halvdel er tekstspalten. To vadere maa derfor staa taettere enn
    standardgrensen tillater, slik de faktisk gjoer i naturen. 0,40 lot dem smelte
    sammen; 0,26 gir naerhet uten at den en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
2026-08-28 Listeboksen foelger teksten, ny myrmal, og merker som taaler travel bunn
    Tre ting:
    * Puta dekket greinene. Ruta til lista spenner rad 4-16, saa den hvite
    flaten strakte seg helt ned til nedre kant selv om teksten slutter rundt
    70 % av hoeyden. align-self:start gjoer boksen bare saa hoey som innholdet.
    * Ny myrmal. Den gamle hadde sivkanten like hoeyt over hele bredden, saa det
    fantes bare ett baelte der en bakkefugl fikk kroppen mot lyst papir --
    derfor maatte de to vaderne staa oppaa hverandre. Den nye skraaner:
    horisonten ligger paa y~1180 til venstre og stiger til 444 til hoeyre, og
    mudderet til venstre er LYST. Det var tonen, ikke hoeyden, som slukte
    myrriksa -- moerkt si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
2026-08-28 Sommergren: full loevverk juni-august
    Hullet i sesongdekningen. Juni-august laa paa den noeytrale aarsrunde-greina,
    mens vaar, hoest og vinter hadde hver sin.
    Sommerloevet er det tetteste av alle variantene og ville ikke holde seg unna
    tekstspalten: 16-20 % blekk i sonen i alle fire foerste forsoek. Det som loeste
    det var ikke flere forsoek, men aa si hvilken VEI loevet skal vokse -- "every
    leaf must grow towards the RIGHT and towards the BOTTOM; no leaf may extend
    leftward past the branch". Tredje forsoek med den ordlyden ga 0,0 %.
    Verifisert at den velges automatisk: 28. august gir gren-sommer og gren like
    mange arter i habitat, men sesongbonusen avgjoer -- en variant for akkurat
    denne m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
2026-08-28 Bjoerk om sommeren, snoe paa grankvisten
    Begge traff paa foerste forsoek — ingen bortkastede generasjoner.
    gren-sommer er naa bjoerk: bark OG blad byttet, greinformen beholdt gjennom
    arven, saa festepunktene staar. Kremhvit bark med fine moerke porestreker,
    moerk sprekkbark nederst paa den tykkeste greina, smaa trekantede
    dobbelttannede blad og slanke rakler. Tekstsonen maaler 0,0 %. Den er
    lysere og luftigere enn rogna, som var hele poenget.
    gren-vinter arver naa gran i stedet for den bare greina: snoe som ligger paa
    oversiden av hver barspri, med hvite topper paa konglene. Maaler 4,8 % i
    tekstsonen, saa lista faar pute paa den malen.
    Hoestmalen er fortsatt rogn — baerene er grunnen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
2026-08-28 En luftplass paa greinmalene -- myrriksa blir endelig tegnet
    Myrriksa har staatt i lista nesten hver dag uten aa bli tegnet noen
    gang. To ting stengte for den, og begge er borte naa.
    Grenmalene hadde bare gren-plasser, og de tar bare trefugler. Malene
    arver en luftplass fra grunnmalen: (720, 640), i det tomme feltet mellom
    lista og stammen. Maalt paa alle seks greinmaler ligger det mellom 0,0
    og 1,6 % blekk der, saa fuglen faar rent papir uansett aarstid.
    Utvalget saa ogsaa feil sted. Det tok malens habitat foerst og resten
    etterpaa, og kuttet ved antall plasser -- men grenmalen har seks
    gren-plasser, saa seks trefugler fylte lista foer myrriksa kom til orde.
    velg_arter gaar plass for plas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
2026-08-28 To tegninger i doegnet: frokostsida viser hele gaarsdagen
    Eieren spurte om ettermiddagsfuglene ble ignorert. De ble det, og verre
    enn han trodde. Utedelen tar opp fra 03:45 til 21:00, 20-30 opptak i
    doegnet -- men bare aatte av dem er unnagjort naar sida tegnes 07:07.
    Maalt paa de fjorten siste dagene med data fanget de 22 % av doegnets
    sikre arter, og paa SJU av fjorten dagene ingen i det hele tatt. Da har
    compose_branch ingenting aa tegne, gaar ut med feil, og cron faller
    tilbake paa AI-bildet.
    Tegnet kl. andel av dagens arter dager uten noe aa tegne
    07:07 22 % 7 av 14
    16:00 76 % 4 av 14
    21:30 98 %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
2026-08-28 ny_art.py: en ukjent art gjoer seg selv klar
    En ny art var en manuell oeving i fem trinn: finne en plansje paa
    Commons, se gjennom kontaktarket og velge, vaske skanningen, be Gemini
    tegne fuglen 1:1, og maale fotpunktet -- pluss aa skrive norsk navn,
    lengde og habitat inn i bird_names.py for haand. Sto arten uten, ble den
    tegnet 18 cm stor, plassert som trefugl og navngitt paa engelsk. I
    praksis betydde det at groennfinken laa paa 96 % i lista i ukevis uten
    aa bli tegnet.
    Alt limet fantes fra foer -- fetch_plates.candidates(), prepare(),
    ensure_bird(), foot_point(). Det som manglet var én kjoering som binder
    dem sammen, og metadataene.
    Det ene som ikke kunne automatiseres rett fram var VA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
2026-08-28 Stoerre overlappstoleranse paa plassen over ugla
    Groennsisiken paa 88 % ble ikke tegnet mens roedstjerten paa 60 % ble
    det. Aarsaken var arealskaleringen tidligere i dag: kattugla gikk fra
    257 til 303 px hoey, og vokser oppover inn i plassen over seg. Sisiken
    proeves sist fordi den er minst, og da var den siste ledige plassen
    sperret.
    Maalt, ikke gjettet: det faktiske overlappet mellom ugla og naboen er
    0,276. Plassen faar 0,32 -- snaut nok til aa slippe inn en liten fugl
    over en stor nabo, ikke saa rundhaandet at hva som helst gaar. Standard
    er fortsatt 0,22, myra bruker 0,26.
    Alle sju artene staar naa, og nummereringen i lista gaar 1-7 uten hull.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
2026-08-28 To nye plasser -- og feilen de avslørte
    Eieren saa at det var plass til en liten fugl mellom skjaera og trosten,
    og til en flygende over greina. Begge er lagt inn SIST i lista, saa de
    bare tas naar de faste er fulle.
    Plasseringene er maalt paa alle seks greinmalene, ikke bare bjoerka.
    Luftplassen (740, 150) har 0,0 % blekk i alle seks -- den var lett. Den
    lille sitteplassen (460, 1422) er ren luft paa bjoerka og den bare greina
    (2 % blekk), men ligger midt inne i barmassen paa grankvisten, der samme
    rute er 58 % dekket. Derfor kan en plass naa begrense seg til bestemte
    maler med `bare_i`. Ett skjelett, men ikke hver plass er brukbar i hver
    aarstid.
    Den lille plassen tar seg av seg selv: d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
2026-08-28 Klipp fugleplansja til fuglen -- kjoettmeisa var halvparten saa stor
    Eieren saa at kjoettmeisa var mye mindre enn spettmeisa. Begge staar med
    14 cm i tabellen, saa det skulle vaere feil -- og det var det, men ikke i
    skalaen.
    cutout() beskjaerte til ALT blekk i arket. Modellen tegner paa 1024x1024
    og hadde lagt igjen noen prikker ute i hjoernene, saa kjoettmeisas utsnitt
    ble 907x854 der bare 9,3 % faktisk var fugl. Spettmeisas var 452x445 med
    40,4 %. Skaleringen sikter paa BOKSEN, saa kjoettmeisa endte med en
    bokstavelig talt halvtom ramme i riktig stoerrelse -- og en fugl i halv
    stoerrelse inni den.
    To grep:
    uten_flekker() kaster loese klatter mindre enn 1 % av den stoerste foer
    beskjaeri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
2026-08-29 Sommerbjoerka: den luftigere varianten
    Bytter til forsoek 2 fra bladstoerrelse-testen. Ikke fordi bladene ble
    mindre -- det gikk ikke -- men fordi plansja ble vakrere: 13 blad mot 17,
    mer bar ved, og stammen faar baere bildet i stedet for loevet.
    Selve bladstoerrelsen staar uendret paa 85 px mot 87, altsaa rundt 10 cm
    ved fugleskalaen der et bjoerkeblad er 3-7. Det er verdt aa notere HVORFOR
    vi gir oss: modellen har ett budsjett for instrukser, og de to kravene
    konkurrerer. Foerste forsoek fikk bladene 17 % ned, men da vandret loevet
    inn i tekstsonen -- 12,8 % i det verste baandet. Skjerpet vi
    hoeyre-side-regelen hardt nok til aa holde sonen ren, slapp den
    stoerrelseskravet og gikk tilbake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
2026-08-29 Lytteplanen foelger sola, og trappes ned etter batteriet
    To ting var galt med den faste planen i firmwaren (04-08 hver halvtime,
    09-21 hver time).
    Den foelger ikke sola. I Oslo staar sola opp 03:52 i juni og 09:13 i
    desember -- over fem timer. En fast morgenrunde fra kl. 04 treffer
    morgenkoret i juni og bekmoerke i desember. Soloppgangen regnes naa ut
    per dag med NOAA-formelen, og finvinduet legges fra én time foer til
    fire timer etter. Utregnet, ikke hentet: svaret ligger i veien for
    utedelens config-henting, og et API som er nede skal ikke kunne stoppe
    brikka i aa faa en plan. Kontrollert mot virkelige Oslo-tall -- tre til
    fire minutter tidlig hele aaret, godt innenfor timen slakk.
    Den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
2026-08-29 Utedelen: sperre mot aa sikte paa et slott som er sekunder unna
    next_slot() godtok ethvert slott i framtida: `if (t > now) return t`.
    Deep-sleep-timeren gaar paa en intern RC-oscillator som bommer 2-7 % og
    UFORUTSIGBART -- fire naesten like lange soevner 29. august bommet 28, 38,
    84 og 87 sekunder for tidlig. Vaakner brikka mer enn en oektlengde for
    tidlig, er den ferdig FOER slottet, og siktet da paa det slottet den
    nettopp hadde dekket:
    13:18:33 vaakner 87 s for tidlig
    13:19:38 ferdig, 22 s foer slottet 13:20
    13:20:01 samme slott én gang til
    Slottet maa naa ligge halve intervallet fram, men aldri mer enn fire
    minutter. Begge grensene er noedvendige: halve intervallet alene vill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
    [config.example.h, outdoor_sensor.ino]
2026-08-30 Begge sidene tegner dagen som paagaar -- med gaarsdagen i reserve
    Eieren vil ha to oppdateringer av dagen som gaar: ca. 07 og ca. 16.
    Kronlinja er endret, og daily_panel har faatt en reserve den trenger.
    Grunnen er lytteplanen vi la om i gaar: den foelger sola, og om vinteren
    har utedelen ikke vaaknet ennaa kl. 07. Maalt over aaret, opptak foer
    kl. 07:00:
    15. juni soloppgang 03:52, foerste opptak 02:00 -> 24
    15. aug soloppgang 05:32, foerste opptak 04:00 -> 14
    15. sep soloppgang 06:45, foerste opptak 05:00 -> 7
    15. okt soloppgang 07:57, foerste opptak 06:00 -> 0
    15. des soloppgang 09:13, foerste opptak 08:00 -> 0
    Fra midten av oktober til ut februar ville m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
2026-08-30 Helseside paa :8090/helse — status og statistikk for hele anlegget
    Alt dette har ligget der hele tiden, spredt: batterispenning og
    WiFi-styrke i helse-sidecarene ved hvert opptak, artene i
    observations.jsonl, hva som sist ble tegnet i dagens-bakgrunn.json.
    helse.py samler det og tegner det opp.
    Grunnen til at det er verdt en side: i loepet av ett doegn gikk kontoen
    tom for Gemini-kreditt, utedelen laa femten timer i bootloader uten at
    noen saa det, og lytteplanen ble lagt om saa strømforbruket ble 2,5
    ganger stoerre. Ingen av delene var synlige noe sted.
    Sida viser:
    Utedelen spenning med trappene 3,80/3,65 V tegnet inn, temperatur,
    wifi, opptak i dag, opplastinger, f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
2026-08-30 Krev to oekter for aa tegne, og en vakt som sier fra
    30. august ga BirdNET 68 % paa en HAVHEST -- en havfugl fra Runde, tjue
    kilometer fra naermeste sjoe -- hoert i ett minutt og aldri igjen. Den
    ble tegnet seilende over bjoerka. Samme dag sto en sangsvane paa 67 %,
    ogsaa ett minutt. Stedsfilteret redder oss ikke: begge hekker i Norge.
    Naa maa en art vaere hoert i minst to oekter for aa bli tegnet. Kostnaden
    er maalt over tolv dager: 49 -> 26 tegnede fugler, og fire dager mister
    alt. Men de fire dagene hadde bare ÉN art hoert i hele doegnet, og de er
    fra den gamle tynne lytteplanen. Paa den tetteste dagen gaar 10 ned til
    8. Med 60 opptak i doegnet er to oekter en lav terskel.
    TEGN_MIN_OEK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
2026-08-30 Vakten oeverst paa helsesida
    Vakten skriver bare til logg, og en logg som krever SSH blir ikke lest.
    Naa staar den oeverst paa /helse: advarslene regnes ut paa nytt ved hvert
    sidevisning, saa de er ferske, og de siste aatte linjene fra
    logs/vakt.log viser historikken. Er alt bra, staar det bare «alt i
    orden» -- og loggen er tom, som den skal vaere.
    Feiler vakt.py, sier seksjonen det i stedet for aa rive med seg sida.
2026-09-01 Sju arter til i plansjebiblioteket — fem fantes bare paa serveren
    Vaktel, bokfink, blaameis, dvergspett og havhest ble laget av ny_art.py
    paa hjemmeserveren mellom 30.08 og 01.09 og aldri hentet tilbake hit. De
    laa i ett eksemplar paa en maskin som slo seg av uforklart 01.09 kl.
    16:25 — hver av dem koster en Gemini-kjoering aa lage paa nytt.
    Snadderand og graatrost laa usporet i arbeidstreet.
    arter.json og plates.json er serverens versjoner. De var rene supersett
    av de lokale: ingen delt noekkel hadde avvikende verdi, og alle 46 delte
    plansjefiler var byte-identiske, saa ingenting lokalt ble overskrevet.
    Biblioteket teller naa 17 arter. Elleve hoerte arter mangler fortsatt
    plansje; roe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
2026-09-01 Si hvorfor bildet ikke ble tegnet, i stedet for aa sprekke
    «kong harald V» 1. september kl. 21:36 gav «FEIL: genererer: kong harald
    V — 'NoneType' object has no attribute 'parts'» paa :8090. Det er ikke
    en feil i anlegget: modellen svarer 200 med en kandidat uten innhold naar
    den ikke vil tegne motivet, og grunnen ligger i finish_reason. Her var
    den IMAGE_OTHER — bekreftet mot API-et i dag — som er svaret modellen gir
    paa navngitte, virkelige personer. Sida tegnet fint baade kl. 07:09 og
    16:01 samme dag, saa det var bare denne prompten som stod.
    generate_image() leser naa kandidat, innhold og parts hver for seg og
    loefter et BildeAvvist med grunnen oversatt: «Gemini tegnet ikke b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
2026-09-01 deploy.sh drepte sitt eget skall og lot serveren ligge nede
    Etter deployen 1. september kl. 21:46 var frame-serveren borte: journalen
    viser «Stopping ... Deactivated successfully» 21:46:30 og ingenting
    etterpaa, ingen lytter paa 8090, og audio-ingest stod fremdeles med
    starttidspunkt fra oppstarten 20:05 — altsaa naadde skriptet aldri
    «systemctl start».
    pkill -f matcher mot hele kommandolinja, og hele dette skriptet ER
    kommandolinja til skallet ssh kjoerer det i. [f]-trikset skjulte
    moensteret, men echo-linja rett under inneholdt «frame_server.py»
    uforkledd — saa pkill sendte SIGTERM til seg selv. Reprodusert paa
    serveren: en kopi av blokka doer med exit 255 og naar aldri linja et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
2026-09-02 Graahegre og svartmeis inn i plansjebiblioteket fra serveren
    ny_art.py laget begge paa serveren i morges (07:07) -- graahegra fra
    gaarsdagens liste, svartmeisa fra dagens. Som med de sju forrige fantes
    de bare der. Hentet hjem med sidecar-JSON og arter.json-oppfoeringer.
2026-09-02 En tegnet fugl staar alltid i lista
    compose_branch velger blant de tolv sikreste, lista viser aatte. 1. sep
    sto bokfinken som nummer ti (36 %, to oekter), ble tegnet nederst paa
    greina -- og fantes verken i lista eller i fotnoten. Et tall paa arket
    skal kunne slaas opp; her var det ikke engang et tall.
    Naa holdes de tegnede artene inne i lista, og de svakeste u-tegnede viker
    for dem. Rekkefoelgen er fortsatt etter sikkerhet. Merk at split_species
    med None som radgrense betyr MAX_ROWS (sju), ikke «alle».
2026-09-02 ny_art --mangler ser de samme tolv som compose_branch
    Med standardgrensa (sju rader) saa den bare topplista: svarttrosten sto
    som nummer ni 1. september med to oekter, ble aldri klargjort, og kunne
    dermed aldri tegnes selv om den var sikker nok.
2026-09-02 Den nedre luftplassen bare paa de bare malene
    2. sep fikk graahegra luftplassen paa (720, 640) i hoestbjoerka: tegnet
    mindre enn skjaera -- luft betyr langt unna -- og rett foran loevet. Da
    leses den som en liten fugl som sitter i treet, ikke som en stor fugl
    langt borte. Relativ stoerrelse gaar ikke: 94 cm i skjaeras maalestokk
    er 585 px.
    Plassen ligger midt i bladverket paa sommer- og hoestbjoerka og rogna, saa
    der er den borte naa. Gren, vaarbjoerk, gran og vinter har aapen luft
    rundt den og beholder begge.
2026-09-02 Kutt smellet i starten av opptaket foer maaling og analyse
    233 av 293 opptak siden 19. aug begynner med et klippet smell paa opptil
    ett sekund, alle naar boksen er under 22 °C. Smellet gir ingen BirdNET-
    treff i seg selv, men nivaamaalingene beskrev smellet i stedet for
    opptaket: peak 1,0, «klipping» i 26 % av opptakene, RMS -25 dBFS for et
    opptak som egentlig ligger paa -62. Og fordi peak var 1,0 ble de doeve
    opptakene aldri normalisert foer analyse.
    Klipper foerste sekund mer enn 0,05 %, kuttes det foerste sekundet foer
    maaling og analyse. Rene opptak roeres ikke. smell_pct logges uansett, saa
    statistikken kan se det mot temperatur og doegn -- det er sporet etter en
    mikrofon som ikke v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
2026-09-03 Si hvorfor lista er tom, ikke bare at den er det
    3. sep 2026 sto det «Ingen av dagens arter har en plansje ennaa» om en dag
    der begge artene med plansje var stroeket av kravet om to oekter. Det leste
    som en feil i biblioteket. Naa skilles de tre tilfellene: stroeket av
    oekt-kravet, sikre arter uten plansje, og ingen arter i det hele tatt.
2026-09-03 Fuglekamera i vinduet: bevegelse -> bilde -> serveren spoer modellen
    3. sep 2026 sto to troster paa plenen som mikrofonen aldri hoerte. Naa ser
    vi ogsaa. Pi 3 B-en fra utedel v1 staar i vinduet med Camera Module 3
    Wide, paa stroem fra veggen -- strømtrekket som drepte den ute spiller
    ingen rolle inne.
    kamera/kamera.py (paa Pi-en): to stroemmer fra kameraet, en liten
    graatonestroem som leses hele tiden og en stor som brukes naar noe skjer.
    Bevegelse = andelen piksler i utsnittet som endret seg; over terskelen tas
    et bilde, beskjaeres til utsnittet og POST-es til serveren. Pause mellom
    bilder, natt hoppes over, fast fokus mot materen saa autofokusen ikke
    finner vindusglasset. Ingen analyse p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
2026-09-03 Bildeanalyse: ekorn og andre dyr i samme liste som fuglene
    Foerste ekte utloesning fra vinduet 3. sep var et ekorn paa materen.
    Modellen skrev det i «annet» og lot artslista staa tom, saa det ble
    loggfoert som «ingen fugl». Naa skal alt som staar der inn i lista med
    latinsk navn -- ekorn er ogsaa en observasjon, og et ekorn paa materen
    forklarer hvorfor det ikke er fugler der.
2026-09-03 Kamera: HQ-kameraet med manuell fokus, og en fokushjelper
    Byttet til HQ Camera + 6 mm 3. sep: materen var for liten for
    vidvinkelen. HQ-kameraet har fokusring paa linsa og ingen AfMode, saa
    autofokus-kallene er naa bak en sjekk paa hva kameraet kan. fokus.py
    skriver et skarphetstall (Laplace-varians i midten) hvert sekund, saa
    ringen kan vris til toppen.
2026-09-03 Kamera: ett felt per mater, to rammer paa rad, og 90 graders rotasjon
    HQ-kameraet i det nye vinduet ser begge materne paa 4 m, men ett stort
    utsnitt rundt dem tok med saa mye loev at vinden ga 4 utloesninger per
    minutt selv med blokk-kravet. Naa er utsnittet to smaa felt rundt hver
    mater (roier), bevegelsen maales i hvert for seg, og bildet som sendes
    dekker begge. Og bevegelsen maa vare to rammer paa rad: et vindkast er
    borte paa neste ramme, en fugl blir sittende. Ett minutt vind: 0
    utloesninger, mot 4 foer.
    roter kan naa vaere 90 eller 270 ogsaa -- HQ-kameraet ligger paa siden i
    vinduskarmen -- og snus i numpy siden sensoren bare kan 180.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
2026-09-09 Plansje: fuglekonge (Hamonville, Atlas de poche pl. 33)
    Hoert 9. sep kl. 06:49 med 63 % — andre gang noensinne, og den foerste solide
    (3. sep var 30 % i ett vindu). ny_art.py klargjorde den paa serveren kl. 07:07:
    valgte 3 av 6 Commons-kandidater (eneste fargelagte enkeltfugl), vasket og
    skar ut fuglen, og lot modellen sette fotpunktet. Kopiert inn med
    fotpunkt-JSON og flyvende variant, og lagt inn i arter.json og plates.json.
2026-09-09 Plansjer: kraake og dompap fra serveren, og indeksene i synk
    Kraake (6. sep) og dompap (8. sep) ble klargjort av cron og laa bare paa
    serveren. arter.json faar ogsaa stokkand (8. sep, ingen plansje laget enda)
    og flaggspett, som ble kopiert inn 5. sep uten oppfoeringen sin. plates.json
    faar de sju Commons-oppfoeringene serveren hadde og repoet manglet; gransangeren
    (Keulemans) finnes bare i repoets utgave, siden ingenting leser fila i drift.
2026-09-09 Tegn hele lista: to-oekter-kravet skrudd av
    Kravet fra 30. aug om at en art maa vaere hoert i to oekter for aa bli
    tegnet holdt fuglekongen (63 %) og svarttrosten borte fra greina 9. sep,
    slik det holdt vaktel, graahegre og kjoettmeis borte 2. sep. Eieren vil ha
    hele lista paa greina. Standard er naa TEGN_MIN_OEKTER=1; kravet kan slaas
    paa igjen med TEGN_MIN_OEKTER=2 i frame_server.env.
2026-09-18 Kamera-app for Pixel-en: test av hvilke linser en vanlig app faar bruke
    Pi Zero 2 W-en kom aldri, og Orange Pi-en har ingen kamerakontakt, saa
    fuglekameraet skal bli en app paa en Pixel 9 Pro. Foerst en test: appen
    lister kameraene telefonen viser fram, tar bilder med zoom 1x, 5x og 10x
    og noterer hvilken fysisk linse hvert bilde kom fra. Ingenting sendes til
    serveren, saa testbilder havner ikke hos Gemini eller i statistikken.
    Foerste kjoering 18. sep (Android 17): bakkameraet er ett logisk kamera
    med hovedkamera (2), vidvinkel (3), tele 17,9 mm / 110 mm ekv. / 18 grader
    (4) og sensorutsnitt (5, 6, 9). Ingen av dem kan aapnes direkte, men zoom
    styrer linsevalget: 10x ga telelinsen (EXIF 17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
2026-09-19 Blokkliste: myrrikse og roerdrum tegnes aldri, men staar i fotnoten
    BirdNETs stedsfilter slipper dem gjennom fordi de finnes i Norge, men
    ikke i hagen. PANEL_BLOKKERT overstyrer lista.
2026-09-22 Koordinater og kontakt ut av koden: oppsett.py leser dem fra miljoeet
    Hagen og e-posten stod hardkodet i fem verktoey. Naa leses FUGLERAMME_LAT,
    FUGLERAMME_LON og FUGLERAMME_KONTAKT fra frame_server.env, med standard
    avrundet til to desimaler og en kontakt som peker til repoet. Bunnteksten
    paa fuglesida skriver koordinatene med de desimalene som er satt.
    Forberedelse til aa gjoere repoet offentlig.
2026-09-22 deploy.sh: kopier ogsaa de sju scriptene tjenestene henter selv
    lytteplan.py, helse.py, fugler.py, ny_art.py, bilde_analyze.py,
    tekstkollisjon.py og vakt.py laa paa serveren, men sto ikke i scp-lista,
    saa de ble bare oppdatert naar noen husket aa kopiere dem for haand. Alle
    sju er i bruk: frame_server.py importerer helse og fugler, audio_ingest.py
    importerer lytteplan og kjoerer bilde_analyze, daily_panel.py kjoerer
    ny_art og tekstkollisjon, og vakt.py gaar i crontab-en hvert kvarter og
    leses av helse.py.
    Sjekket mot serveren 22. sep 2026: seks av dem er identiske med repoet,
    men lytteplan.py der er fra 29. aug og eldre enn oppsett.py (ef0a00e) den
    naa skal lese koordinatene fra. Neste depl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
2026-09-22 Brukernavn, stedsnavn og maskinnavn ut av repoet
    Serveren er din, ikke repoets: deploy.sh krever FUGLE_SERVER, fra miljoeet
    eller deploy/deploy.env (ignorert av git), og setter User= i tjenestefilene
    til SSH-brukeren idet de installeres. Stedsnavnet paa fuglesida kommer fra
    FUGLERAMME_STED. Docs og de gamle Pi-scriptene sier «bruker» der de sa hvem
    jeg er, og WiFi-navnet og servernavnet er tatt ut.
2026-09-22 README delt opp per mappe, AGENTS.md og MIT-lisens
    Rot-README-en er skrevet for et offentlig publikum: hva dette er, hvordan
    delene henger sammen, valgene og hvorfor, og det som ble proevd og forkastet.
    Driftsnotatene fra den gamle README-en ligger naa naermest koden de
    beskriver: tools/, deploy/, firmware/, plates/, kamera-app/, kamera/, pi/,
    design/ og docs/ har hver sin README, og cron-delen er skrevet etter
    crontab-en slik den faktisk staar. AGENTS.md samler konvensjonene, CLAUDE.md
    importerer den. Blender-sporet staar under «proevd og forkastet»; grenen
    publiseres ikke.
2026-09-24 Nettsida: generator, innhold og Actions-jobb for GitHub Pages
    nettside/bygg.py bygger sida fra det som alt ligger i repoet: plansjefuglene
    og malene i plates/, navn og lengder fra bird_names.py, soloppgangskurven fra
    lytteplan.py, og dagene i nettside/dager/. Statisk HTML uten JavaScript,
    EB Garamond som egen font (OFL), ingen eksterne kall og aldri koordinater.
    Lista paa arket peker paa fuglen paa grenen med :has(), hjoernene er skaaret
    med corner-shape der det stoettes, og arket skalerer med cqw-enheter.
    Innholdet ligger i innhold_nb.py saa en engelsk utgave er en oversettelse,
    ikke en kodejobb. Workflowen bygger og publiserer ved hver push til main;
    Pages maa staa paa «GitHub Actions».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
2026-09-24 Nettsida paa engelsk ogsaa, med spraakvelger i toppen
    Begge spraak bygges hver gang: norsk i rota som foer, engelsk under en/
    med egne stier (birds/, how-it-works/, choices/, how-i-built-it/, day/).
    Bildene og stilarket deles. Spraakvelgeren staar sist i navigasjonen og
    peker paa samme side paa det andre spraaket; hver side har hreflang-lenker
    til begge.
    Dagfilene er norske og forblir det. Den engelske sida slaar opp artsnavn
    via latin i plates/arter.json og innhold_en.NAVN, oversetter vaerordet og
    belegget («1 ggr» -> «once»), og faller tilbake paa det norske navnet der
    det mangler, saa lista aldri faar hull. Arkivdagene har teksten i bildet
    og er norske paa begge spraak.
    Co-Authored-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
2026-09-24 Nettsida: pagineringa viser datoene, paa én rad
    Knappene paa smale skjermer heter naa dagen de gaar til, «‹ Ons 23.» og
    «Fre 25. ›», med chevron og tekst laast paa samme linje. Dagen som vises
    staar mellom dem med «I dag» under, ikke paa raden under. En dag som
    ikke finnes, i morgen eller foer arkivet, staar der graa uten lenke.
2026-09-25 Forsiden viser de aatte som er hoert flest dager
    Utvalget av fugler paa forsiden var haandplukket. Naa er det de aatte
    oeverste fra samme sortering som biblioteket, med linja «Hoert 29 dager ·
    opptil 100 %» under hvert kort, og seksjonen heter «De vanligste fuglene».
    Det faste utvalget (UTVALG) staar igjen som reserve naar statistikken
    mangler.
2026-09-25 Nettsiden: ramma rundt arket er borte, varmt blekk, lenker i blekk
    Helsvart ramme og helsvart blekk ble for hardt. Arket ligger naa rett
    paa siden med en myk skygge, blekket er en varm nesten-svart fra de
    moerkeste tonene i plansjene, og papiret har et hint varme. Lenker har
    samme farge som teksten rundt og faar understrek paa hover; i loepende
    tekst er streken svak i ro saa lenka kan skilles fra teksten uten farge.
    Roedt er bare igjen som aksent paa GitHub i menyen. Strekene i
    diagrammene fulgte ikke blekk-tokenet, de var hardkodet svarte; naa er
    de currentColor.
2026-10-02 Dagremsen viser de sju siste dagene og staar stille mens en blar
    Vinduet sluttet alltid paa valgt dag, saa valgt bilde laa lengst til hoeyre
    og hele remsen skled ved hvert klikk. Naa er remsen faste blokker paa sju
    regnet bakover fra nyeste dag; bare ramma rundt valgt dag flytter seg.
    Blar en forbi blokka, hopper remsen til de sju foer.
2026-11-05 Nettleseren logger inn med cookie paa frame-serveren, og token maskeres i loggen
    Med FRAME_TOKEN satt maatte nettsiden ha ?token= i URL-en. Da ga menylenkene
    401, og tokenet ble skrevet til journalen ved hvert kall. Foerste besoek med
    ?token= paa en side setter naa en HttpOnly-cookie og sender videre uten token.
    SameSite=Strict fordi GET /generate og /daily setter i gang arbeid. API-kall
    omdirigeres ikke, og X-Token virker som foer, saa Siri-snarveien er uberoert.
